wonderbench/mianguang/docs/README.md

# 方案文档

[PDF阅读版](毫米波睡眠监测与夜灯_样机设计方案.pdf) · [Word可编辑版](毫米波睡眠监测与夜灯_样机设计方案.docx)

方案书为2026-10-28的8页设计记录，包含资源比较、模块选择、电源与接口、安装、固件和验证计划。其“PCB编辑暂停、待最终导出”等历史状态已由2026-11-04的[PCB V0.2交付说明](../pcb/release_v02/README_交付与装配.md)替代；接线、跳帽与制造数据均以V0.2为准。

`archive/`保留V0.1离线复核作为问题来源记录；H-01至H-05的处理及剩余功能边界见V0.2交付说明。历史报告中的原工作区路径不作为当前文件入口。

`source/delivery_status_2026-10-28.json`保存原方案生成时的状态快照；`fonts/`包含文档字体及许可证。历史文档生成脚本在[tools/](../tools/)，输出到`docs/generated/`，不覆盖已交付PDF或Word。
