wonderbench/mianguang/research/README.md

# 参考资料与选型

- [选型证据与集成约束](source_notes.md)：C1001主选、其他雷达路线、安装和数据有效性条件。
- [资源索引](resources.json)：官方链接与用途。
- [下载校验清单](download_manifest.json)：参考资料SHA-256。
- [datasheets/](datasheets/)：厂家手册、协议、透波罩指南、C1001尺寸图与STEP/DWG。
- [vendor_library/](vendor_library/)：DFRobot官方库审阅快照及原许可证，用于协议核对。

资料快照日期为2026-10-28。当前项目连接与选料以[PCB V0.2](../pcb/README.md)为准。厂家文档及模型归原提供方，具体来源记录在上述索引。
