wonderbench/mianguang/models/mechanical/interface_evidence.md

# V0.2 PCB 与外壳接口证据

提取日期：2026-11-04。本文与同目录 `pcb_v02_reference.json` 一起用于 Blender 尺寸复核。`pcb/release_v02` 为冻结输入，未修改。数字复核不代表实物装配通过。

## 坐标与提取范围

- PCB 坐标：毫米；从元件顶面看，板框左下角 `(0,0)`，X 向右、Y 向上、Z 从顶面向元件侧。原生 EDA 数据以 mil 保存，乘 0.0254 转为 mm；旋转角沿原生 XY 平面逆时针。
- 板框 66×56 mm；厚度 1.6 mm 来自 V0.2 装配建议，Gerber 本身不规定板厚。四个非金属化孔名义 Ø2.7 mm，中心 `(5,5)`、`(61,5)`、`(5,51)`、`(61,51)`，孔距 56×46 mm。JSON 保留导出量化的小数，不将其当作加工公差。
- 全部 23 个元件位于顶面，共 63 个物理焊盘。读取独立 `.epcb` 的放置和项目 `.epro2` 内封装，使用仓库现有解析器处理删除及覆盖记录，再对照冻结 PickPlace、BOM 和针脚网络。
- `footprint_layer48_centerline_bbox_xyxy_mm` 是封装 layer 48 图形中心线外接框，不是实测器件外壳，也不是带装配公差的禁布区；`pad_bbox_xyxy_mm` 是焊盘机械参考。JSON 保存两者和并集，范围格式为 `[xmin,ymin,xmax,ymax]`。微小焊盘偏移小于 0.0002 mm，机械包络计算忽略该偏移。
- 当前 Blender 设计映射：`X=x−33`，`Z=y+56`；载板中心 `Y=12.2`，元件面 `Y=11.4`，背面 `Y=13.0`；元件向 `−Y` 生长。毫米转换为 Blender 米时再除 1000。

## XIAO：按针位配准，USB 朝向板 +Y

U1 原生放置原点为 `(33,30)`，两排针的几何中心为 `(33,29.51740096)`。左排 X=25.38000004，针 1→7 的 Y 从 37.13740096 递减至 21.89740096；右排 X=40.62000004，针 8→14 的 Y 从 21.89740096 递增至 37.13740096。行距 15.24 mm、针距 2.54 mm；承载板钻孔约 Ø1.1 mm。不能将两排针画成 19.2 mm 间距，也不能按原点直接对称放置模块。

Seeed 官方规格为 21×17.8 mm。官方 V1.3 KiCad 的板边按 D0、TX、RX、5V 针位配准后，在载板上为 X=24.110..41.890、Y=19.103401..40.058401 mm，中心 `(33,29.580901)`；该公开 CAD 的边框为 17.78×20.955 mm。USB 朝 +Y，变换到外壳后朝 +Z。[Seeed 官方说明](https://wiki.seeedstudio.com/XIAO_ESP32C3_Getting_Started/)、[官方 V1.3 PCB 文件](https://files.seeedstudio.com/wiki/XIAO_WiFi/Resources/XIAO_ESP32C3_v1.3_KiCad_260116.zip)。

冻结 EDA 封装保留的模块图形与当前官方 V1.3 板边在配针后有约 0.22 mm 的偏置差。插装孔位以冻结载板为准；壳内模型使用官方板边与额外装配余量。预留 USB 至 PCB Y≈41.7 mm 属于外壳设计余量，不能据此推定实际线缆插头的完整形状。

候选排母 C124418 / Ckmtw B-2200S07P-A120 的产品页列明 1×7、2.54 mm、塑壳绝缘高度 8.5 mm；这不是模块板底到载板顶面的完整堆高。[供应商产品规格](https://www.lcsc.com/product-detail/C124418.html)。当前模型另预留 2.5 mm 公针塑壳，暂按板底离载板 11 mm、模块 PCB 厚 1.6 mm、模块元件高 3.2 mm。公针/排母配套型号、插入止点、焊接姿态与实际 USB 外壳高度未冻结，该堆高只允许作条件空间检查。

当前 USB 服务插头预留厚度 8 mm（外壳 Y=−6.8..1.2），起点 Z=97.6 mm，轴向拔插距离 24 mm；线缆随后转弯的空间仍需按实物确认。模块自带 USB 用于固件/调试；面板电源 USB-C 小板通过 J1 供电，是另一个独立物料，不应将两者混为同一接口。

## XIAO 外置天线：真实候选尺寸与粘贴区域

XIAO ESP32C3 官方说明明确随附外置天线；目前尚未确认本项目实物的天线批次。可追溯候选为 Seeed A-01 FPC（SKU 318020748），其 2024-10-08 工程图型号 M01-0601770R0A、版本 V01：FPC 为 40.0±0.3 ×20.0±0.2 mm，馈线 80±2 mm、直径 1.13±0.1 mm，局部焊接总高不大于 1.80 mm（含离型纸）。当前官方商品页补充 FPC 基体厚 0.2 mm、IPEX1 接头。[官方工程图第 1 页](https://files.seeedstudio.com/wiki/XIAO_WiFi/antenna/FPC_Antenna_2.4GHz_2.9dbi_for_XIAO_ESP32C3/res/Datasheet_2.4GHz_FPC_Antenna_2.9dbi_for_XIAO_ESP32C3.pdf)、[官方商品页](https://www.seeedstudio.com/FPC-Antenna-A-01-for-XIAO-ESP32C3-C5-p-6439.html)。当前商品页包含双频用途，而上述工程图针对 2.4 GHz；本设计按这组有来源的外形预留空间，不据此认定随附批次或射频特性一致。

建议贴在左侧塑料内壁 YZ 平面，40 mm 长边沿 Z，20 mm 短边沿 Y。内壁 X=−47.6 mm 时，名义 FPC 基体中心为 `(−47.5,0,84)`、尺寸 `0.2×20×40` mm；包含焊点和装配余量的电子占位中心为 `(−46.6,0,84)`、尺寸 `2.0×20.6×40.8` mm。粘贴与检修区为 Y=−12..12、Z=62..106 mm，即 24×44 mm。占位最内侧 X=−45.6，距载板左边 X=−33 有 12.6 mm；此距离是几何余量，不是经厂家确认的射频净空要求。该位置避开中央雷达正前方，也将天线置于背部安装座之前。

官方 XIAO V1.3 PCB 的 ANT0（U.FL-R-SMT-1）原点配准到载板为 `(33,20.50040096)`，在本版外壳中为 X≈0、Z=76.50040096，处于 USB 的相反一端。FPC 馈线端可朝下至 Z≈64，至 ANT0 的 XZ 直线距离约 49.1 mm；80 mm 馈线可据此设计绕行路径，但折弯半径、连接头扣合高度、应力释放和检修余量仍需实物与模型验证。不得仅以端点直线距离判定线长够用。馈线不得覆盖 C1001 天线、夹在壳体接缝内，或妨碍 JP1/JP2/JP3 拔插。

JSON 的 `xiao.external_antenna` 记录官方尺寸、链接及 PDF 哈希；`enclosure_design_assumptions.wifi_antenna` 记录上述候选落位。不得将这些条件预留写成实物装配或 Wi-Fi/BLE 性能已通过。

## 接口、针序和跳帽访问

| 接口 | 原点 mm | 针 1→末针方向 | 针序 / 服务要求 |
|---|---:|---|---|
| J1 | 17,8 | +Y | 1=5V_IN，2=GND；外接面板供电小板 |
| J2 | 56,35 | +X | 1=5V_SYS，2=GND，3=RADAR_RX，4=RADAR_TX；雷达线束 |
| J3 | 56,17 | +Y | 1=5V_SYS，2=LED_LOW；限流暖白灯板 |
| J4 | 11,29 | +X | 1=BUTTON_N，2=GND；外壳按键线束 |
| J5 | 14,44 | +Y | 1=3V3，2=GND，3=I2C_SDA，4=I2C_SCL |
| JP1 | 47,8 | +Y | 1=5V_ISO，2=5V_MCU；主控电源跳帽 |
| JP2 | 48,36 | +X | 1=UART_TX_LINK，2=RADAR_RX；发送隔离跳帽 |
| JP3 | 48,41 | +X | 1=UART_RX_LINK，2=RADAR_TX；接收隔离跳帽 |

八个排针的插拔方向均应沿元件面法向（外壳 −Y），表中 X/Y 仅指板内针脚排列。塑壳大小、锁扣、极性防呆、线缆折弯半径及跳帽抓取尺寸没有被 PCB 封装锁定。模型应在可拆前盖后保留抓取路径，并避免雷达托盘或线束遮住 JP1/JP2/JP3。USB 调试前按 V0.2 装配说明：断开外部 5 V，拔下三个跳帽，再插 XIAO USB。不能仅拔 JP1 就认为 UART 已隔离。

## C1001 雷达模块的可追溯安装孔

官方图纸确认 22×22 mm、右侧两孔距 18 mm、距上下边各 2 mm；元件面视图左侧针脚自上而下为 VIN、GND、RX、TX、IO1、IO2。[DFRobot 官方页面及下载](https://wiki.dfrobot.com/sen0623)。

原厂 `JQC1001.step` 的板实体为 `#298 MANIFOLD_SOLID_BREP`：边界 X=18.559999465942..40.560001373291，Y=7.30999994278..29.309999465942，Z=−0.99144074..0 mm。将其左下角平移到 `(0,0)`，两个孔的名义中心为 `(20,2)`、`(20,20)`；对应圆柱面 #749/#815 的半径为 1.00000054 mm（名义 Ø2.0）。相对板中心即 `(9,−9)`、`(9,+9)`。孔径来自原厂 CAD，须与实际批次测量复核后再选螺钉/柱；不能把此 Ø2.0 与承载 PCB 的 Ø2.7 混用。

STEP 板厚为 0.99144074 mm，当前外壳取 1.0 mm 近似。文件含嵌套组件坐标，且 Free-Models 子装配存在变换后越出板框的几何；因此整个文件全部点的最大最小值不构成可信实物总高。当前模型雷达板中心为 `(0,−16.8,121)`，板背面 Y=−16.3，向后预留 8 mm 至 Y=−8.3；这是待到货验证的器件与线束空间，不是已测得的模组厚度。

## 当前已确认与条件检查边界

| 项目 | 状态 |
|---|---|
| 承载 PCB 板框、四孔、23 元件放置、63 焊盘、网络针序 | 冻结源文件数字证据 |
| XIAO 行距、针距、USB +Y、公开 V1.3 板边配准 | 原生封装与官方资料交叉核对 |
| C1001 22×22、18 mm 孔距、STEP Ø2.0 | 官方图纸/CAD；实物版本未核验 |
| 排母塑壳 8.5 mm | 候选供应商规格；采购配套尚未冻结 |
| 11 mm XIAO 插装高度、模块厚 1.6 mm、元件高 3.2 mm | 设计预留，需实测配套装配 |
| 雷达背面 8 mm、USB 插头 8 mm 厚×24 mm 轴向 | 设计预留，需实物确认 |
| 面板 USB-C、灯板、按键、线束、Wi-Fi 天线、螺钉 | 具体采购尺寸/固定方式未锁定 |
| 白色透波窗材料、色母和厚度 | 外观设计参数；射频效果需样件对照 |

## 全部 23 个元件放置和 layer 48 平面尺寸

以下尺寸是封装图形中心线的外接框，不是实测器件尺寸。焊盘外接框及其与图形的并集分别保存在 JSON 中。

| Ref | XY mm | CCW deg | Layer48 W x H mm | Footprint |
|---|---:|---:|---:|---|
| C1 | 31.000, 14.000 | 0 | 2.000 x 1.250 | C0805 |
| C2 | 37.000, 14.000 | 0 | 1.600 x 0.800 | C0603 |
| C3 | 17.000, 34.000 | 90 | 0.800 x 1.600 | C0603 |
| C4 | 54.000, 28.000 | 0 | 2.000 x 1.250 | C0805 |
| C5 | 54.000, 31.000 | 0 | 1.600 x 0.800 | C0603 |
| D1 | 37.000, 8.000 | 0 | 4.200 x 2.600 | SMA_L4.2-W2.6-LS5.0-RD_1 |
| D2 | 24.000, 14.000 | 90 | 1.700 x 2.800 | SOD-123FL_L2.8-W1.7-LS3.6-RD |
| F1 | 25.000, 8.000 | 0 | 3.200 x 1.600 | F1206 |
| J1 | 17.000, 8.000 | 90 | 2.540 x 5.080 | HDR-TH_2P-P2.54-V-M-1 |
| J2 | 56.000, 35.000 | 0 | 10.160 x 2.500 | HDR-TH_4P-P2.54-V-M |
| J3 | 56.000, 17.000 | 90 | 2.540 x 5.080 | HDR-TH_2P-P2.54-V-M-1 |
| J4 | 11.000, 29.000 | 0 | 5.080 x 2.540 | HDR-TH_2P-P2.54-V-M-1 |
| J5 | 14.000, 44.000 | 90 | 2.500 x 10.160 | HDR-TH_4P-P2.54-V-M |
| JP1 | 47.000, 8.000 | 90 | 2.540 x 5.080 | HDR-TH_2P-P2.54-V-M-1 |
| JP2 | 48.000, 36.000 | 0 | 5.080 x 2.540 | HDR-TH_2P-P2.54-V-M-1 |
| JP3 | 48.000, 41.000 | 0 | 5.080 x 2.540 | HDR-TH_2P-P2.54-V-M-1 |
| Q1 | 49.000, 17.000 | 0 | 1.300 x 2.900 | SOT-23-3_L2.9-W1.3-P1.90-LS2.4-BR |
| R1 | 45.000, 24.000 | 0 | 1.600 x 0.800 | R0603 |
| R2 | 49.000, 22.000 | 90 | 0.800 x 1.600 | R0603 |
| R3 | 17.000, 29.000 | 0 | 1.600 x 0.800 | R0603 |
| R4 | 49.000, 27.000 | 0 | 1.600 x 0.800 | R0603 |
| R5 | 49.000, 31.000 | 0 | 1.600 x 0.800 | R0603 |
| U1 | 33.000, 30.000 | 0 | 17.856 x 22.446 | XIAO_ESP32C3_SOCKET_2x7_P2.54 |

## 来源文件指纹

| Input | SHA-256 |
|---|---|
| `pcb/release_v02/Mianguang_V0.2.epcb` | `1cc1c4cba7115e438fbd0bac56380e4d36e0445491d1454f6da5bd68f7b3f74f` |
| `pcb/release_v02/Mianguang_V0.2.epro2` | `4eb70110e04e7c353f97750ac7644401175efcc098e2bfd465b6daf8d8106603` |
| `pcb/release_v02/PickPlace_Mianguang_V0.2.csv` | `e606ba203e43fe6af33b6836d30a4253de79c5992be454ca68045de4488c9eaf` |
| `pcb/release_v02/BOM_Mianguang_V0.2.csv` | `ec123c07fdffcc1a422fdac34d5140f67d5df404ad6c0e5fd122b268b563254a` |
| `pcb/release_v02/Gerber_Mianguang_V0.2.zip` | `663cf9db40d43defeba6dd79a99d8856211062c604a15fb8657d6bc7a798bc77` |
| `pcb/release_v02/README_交付与装配.md` | `c297ffe9cb8d8de3dd1741a3de4af1682943b6dbbc863be644320158e0cf5332` |
| `research/datasheets/C1001_step/JQC1001.step` | `8e2c76e44df98a1f32d43bad3ae7bf83f0e4d73102cc5e6e15412d7ff26e2b06` |
| `research/datasheets/C1001_dimensions.png` | `221a93c36e9908340f5e083d6ba3b4e5144f02bf990134016940414713dc0130` |
| Official XIAO V1.3 PCB ZIP | `477bc61cec652eaeefa887cb1f97abb1514e8a61ea9659240b88be7213c3b6ff` |
| ZIP member `202003511_XIAO ESP32C3_v1.3_SCH&PCB_260116/XIAO ESP32C3_v1.3.kicad_pcb` | `a761393935ff261a58fee3e3d7ecfb65152eaba8620de64ff7758fb0c043d1db` |
