wonderbench/mianguang/models/mechanical/review_v02.md

# V0.2 外壳独立复核记录

2026-11-04 对保存后重新打开的 `Mianguang_Enclosure_V0.2.blend` 完成独立几何复核：**15 项通过，0 项失败**。原始结果见 [`geometry_checks.json`](../v0.2/geometry_checks.json)，可复核脚本为 [`verify_enclosure_v02.py`](../scripts/verify_enclosure_v02.py)。检查没有保存或修改 Blender 工程。

本记录针对 PCB V0.2 与数字模型的配合。器件高度及未选定配件仍按采购包络判断；通过几何检查不代表已完成实物装配、射频或承载测试。

## 依据与复现

- PCB：冻结的 66 × 56 mm V0.2 载板，23 个器件、14 个 XIAO 对接针位，读取独立机械参考中的原生 EDA 坐标。
- 机械参考：[`pcb_v02_reference.json`](pcb_v02_reference.json)；来源文件 SHA-256 一并复核。
- 已检查模型 SHA-256：`ac4f19d308f535fb3ac228d6c6f5e865014e69b46b43829d7eb3abe2b98e2112`。
- Blender：5.2.1 LTS。

```sh
blender --background models/v0.2/Mianguang_Enclosure_V0.2.blend --python models/scripts/verify_enclosure_v02.py
```

脚本写入几何检查 JSON；不会保存或覆盖 `.blend`。后续若修改几何，应重新执行检查并核对报告中的模型指纹。

## 本次修正并复核的具体问题

| 位置 | 发现 | 最终处理 |
| --- | --- | --- |
| 主板与 XIAO | 初稿模块位置、针距与安装孔径不对应 V0.2 | 按 EDA 坐标布置全部23器件；XIAO按14针定位；主板孔改为Ø2.7 |
| 顶部按钮 | 键帽、法兰会撞桥柱 | 桥柱移至X=±17，扩大桥板；检查0～0.45 mm行程无打印件穿透 |
| 雷达与灯板托盘 | 立柱伸入托盘实体 | 柱端分别止于Y=-6与Y=-8.5承压面 |
| 灯板线槽 | 线槽切开安装孔 | 线槽移至Z=56.8，线束经过该槽 |
| C1001背面 | 元件包络侵入安装柱 | 在采购允许包络中扣出两孔周围禁布区域 |
| USB受电板 | 压条悬空，受电板后端穿壁 | 增加压脚；受电板中心Y=13.5；重新检查开孔配合 |
| 下部前盖柱 | 碰USB压条、灯托、扩散片法兰 | 两柱移至X=±42、Z=39；前盖定位唇增加Ø7.6退让，保留外面板厚度 |
| J2与JP2 | 插头预算与跳帽过近 | J2限制为最大10.4 mm宽窄体插壳，模型侧隙0.260 mm |
| 转轴 | 原立柱与下倾壳体相撞；螺母座、固定耳及摩擦垫相交 | 后置桌面立柱；阶梯固定耳R7.7/R4.5；摩擦垫外径9；增加实际止挡 |
| 单件连接 | 初轮前盖及USB压条存在断开的实体岛 | 接合处增加实体重叠后融合；最终11件均为单一连通实体 |
| 线束 | 自动切线超调，局部穿过托盘、桥板与压条 | 控制切线范围并重排四条尾段；对曲线实体包络重新检查 |

## 最终数字检查结果

| 检查 | 结果 |
| --- | --- |
| PCB板框、厚度 | 66 × 56 × 1.6 mm；厚度为本版制造建议 |
| 23个器件位置与XIAO14针 | 与独立提取的冻结坐标逐项一致，数值误差小于0.001 mm |
| 主板四孔 | Ø2.700 mm；孔中心X=±28，Z=61/107，孔距56 × 46 mm |
| 主板孔与壳内柱孔轴线 | 从实际网格孔圈拟合；同轴数值误差小于0.001 mm |
| 雷达两孔 | 模组Ø2.000 mm、托盘Ø1.700 mm，两孔距18 mm；轴线一致 |
| 11个打印零件 | 非流形边0；每件1个连通实体；体积为正 |
| 静态打印件与电子预算 | 未检测到超过数值分类阈值的采样穿透 |
| 桌面0～30° | 63个姿态检查通过；机身最低点距底座顶面最小3.971 mm |
| 壁挂0～45° | 93个姿态检查通过；机身及外接USB插头预算距墙面最小11.149 mm |
| 实际止挡 | 桌面−0.1°/30.1°、壁挂−0.1°/45.1°均检测到止挡接触 |
| 顶键 | 0、0.20、0.45 mm三个位置未与打印件相交；弹力及实际开关行程待选型确认 |
| XIAO USB插头 | 拆前盖和雷达托盘后，12 × 8 × 24 mm服务包络不与保留打印件相交 |
| 雷达面至前盖 | 模型间隙4.50 mm；没有据此推断射频性能 |
| 外部USB-C | 受电接口预算与壳开口配合通过；采购接口及真实线缆需符合预算 |

## 检查范围

碰撞检查使用保存模型的三角面、顶点及三角面中心，结合最近距离和三个方向射线判断内部点；数值分类阈值为0.05 mm。该阈值用于排除共面接触及浮点误差，不是允许制造干涉量。旋转检查采用0.5°离散步长，并加入端点和距止挡0.1°的位置；不能代替连续运动证明或实体转动测试。

XIAO插座组合高度、C1001背面8 mm预算、USB受电小板、灯板、光感头与实际线缆均需采购后量测。仍需验证打印收缩、热熔螺母试孔、紧固扭矩、底座抗倾倒、壁挂承载、按键回弹、夜灯温升和透波。以上事项保持为明确的样机验证条件。
