wonderbench/mianguang/firmware/reports/demo_summary.md

# 固件日志工程摘要

**合成模拟非实测 — 仅用于工具验证**

来源：`<project>/firmware/fixtures/demo_synthetic.jsonl`  
SHA-256：`b06ec00be3675a69ca47d01a035d6e8733191f3152256c597300977b0d793199`

非空记录 15 条，其中结构有效 sample 13 条；无效 JSON 1 条，结构不合格 0 条，非 sample 1 条。空白行 0 条。
重复相邻时间 1 次，时间下降 1 次，共 2 段。时间下降按重启或乱序边界处理，不能确证重启。

| 时间项目 | 结果 |
| --- | --- |
| 各段首末跨度之和 | 14.000 秒 |
| 可积分观察时间 | 8.000 秒（跨度的 57.1%） |
| 已知正向间隔中未计时间 | 6.000 秒 |
| 有效在床观察 | 6.000 秒 |
| 有效非在床观察 | 0.000 秒 |
| 在床状态 unknown | 2.000 秒 |

覆盖率分母为可积分观察时间。缺口和跨分段时间不补齐，也不自动算入 unknown。

| 指标 | 有效时间 / 覆盖率 | 有效去重原始读数数 | 中位数 | 范围 |
| --- | --- | --- | --- | --- |
| RR 呼吸频率 | 6.000 秒 / 75.0% | 6 | 17.0 | 14–22 |
| HR 心率 | 6.000 秒 / 75.0% | 6 | 71.0 | 68–82 |

RR/HR 单位为次/分钟。原始读数按各字段独立的 `(分段,t_ms-age_ms)` 去重；中位数不使用固件趋势中位数，日志行数不当作独立样本数。原始 available 读数范围、冲突和来源行见 JSON。

| 分段 | 来源行 | t_ms 范围 | sample 条数 |
| --- | --- | --- | --- |
| 1 | 2–11 | 1000–11000 | 9 |
| 2 | 12–15 | 500–4500 | 4 |

统计只延续至下一条有效记录，且间隔须大于 0、不超过 2 秒；末条不外推。坏行/非 sample 会阻断区间；重复时间行不贡献时长，其后区间也保守排除。

- 这是工程观察摘要，不是临床睡眠报告；在床观察时长不等于睡眠时长。
- 日志记录数不等于独立雷达读数数；RR 与 HR 分别按分段内 t_ms-age_ms 去重。
- 去重统计仅覆盖日志可见的观测时间键，不代表模组全部采样或 UART 帧总数。
- 非在床观察时长不等于真实离床时长或离床次数；unknown 不计作非在床。
- t_ms 下降仅表明重启或乱序边界，不能单凭该日志确认实际重启次数。
- 各段时长独立相加，没有绝对时间轴；乱序分段可能重叠，不能据此宣称真实整夜时长。
- 不推断模组睡眠阶段、睡眠质量、医学事件或医学报警。

JSON 附有每个计入/排除区间、原始读数来源行、异常位置与源文件哈希，可据此复核。
