wonderbench/mianguang/platform/reports/README.md

# 已执行的软件验收记录

以下报告来自真实 PostgreSQL / HTTPS 容器运行，输入全部为合成设备数据。JSON 保留当次 GitHub 合并候选提交、运行时间、请求数、环境与数据库字节数；不改写为最终主分支提交。工作流日志及 artifact 是对应执行证据。

| 历史规模 | 负载范围 | 证据 |
|---|---|---|
| 6,000 行 | 100 台同步突发；100 台每10秒上报；10个独立会话每15秒轮询；持续30.005秒 | [原始JSON](capacity-6000.json)、[工作流](https://github.com/wonderbench/mianguang/actions/runs/41850938034) |
| 6,048,000 行 | 同样的混合负载，持续30.006秒；并发查询单绑定24小时趋势与CSV | [原始JSON](capacity-6048000.json)、[工作流](https://github.com/wonderbench/mianguang/actions/runs/41851603839) |

两次运行的100次突发、300次周期上报、20次总览、2次趋势和2次CSV请求全部成功；实际行数、每台接收、latest/排序水位、调度次数及临时凭证清理检查全部通过。趋势和CSV各只有2个样本，表中P95是本次样本统计，不能外推长时间尾延迟。

| 服务端处理 P95 | 6,000 行 | 6,048,000 行 |
|---|---:|---:|
| 同步突发接入 | 31 ms | 69 ms |
| 周期接入 | 8 ms | 82 ms |
| 总览 | 43 ms | 64 ms |
| 单绑定24小时趋势 | 17 ms | 289 ms |
| 单绑定24小时CSV | 11 ms | 446 ms |

计时来自 Django `Server-Timing`，不包含反向代理排队和网络传输；客户端P95及样本数另见JSON。执行环境为2个可见CPU、8,317,034,496字节主机内存的GitHub Linux runner，Python3.12.16 / Django5.2.19 / PostgreSQL17.11；它不是设计候选的4 vCPU机构主机。

完整历史种子实际耗时431.922秒。负载后本次设备共有6,048,400条观测；全库大小10,137,294,515字节，观测表含索引10,127,826,944字节（约9.43 GiB）。这些是数据库关系大小，不包含WAL、Docker镜像、备份及未来膨胀空间。

本次只完成完整历史规模下的短时正确性和查询检查。两份报告均为 `smoke_passed`，`full_capacity_passed=false`。100台/10会话连续24小时、真实浏览器渲染、三台真机24小时、现场断电与UART/灯时序、机构异机恢复仍未执行。执行命令及完整判定见[容量验收](../docs/capacity.md)。

## 固件CI与开发产物

[固件CI记录](firmware-ci.json)来自[工作流41855225085](https://github.com/wonderbench/mianguang/actions/runs/41855225085)。6个原生C++可执行测试、实际main.cpp mock的3份JSON、15项日志测试、实际网络序列化的3份服务端契约检查、1项USB聚合流程模拟及两个板级构建全部通过；原生与网络host检查使用ASAN/UBSAN。

| 构建环境 | 静态RAM | Flash链接尺寸 | 应用分区上限 |
|---|---:|---:|---:|
| 原 `xiao_esp32c3` / V0.2.0 | 16,852 B | 289,680 B | 1,310,720 B |
| `xiao_esp32c3_platform` / 0.3.0-dev | 77,940 B | 936,796 B | 1,310,720 B |

以上是该次CI链接结果；原V0.2发布包未替换。开发版 `.bin`、分区/引导文件与ELF位于该工作流的artifact，元数据、摘要和保留期限见JSON。静态RAM不包含运行期Wi-Fi/TLS堆与任务峰值；NVS断电、网络期限、UART/按键/灯表现和三台24小时仍按[现场记录](../docs/field_trial.md)验收。
