wonderbench/mianguang/models/mechanical/mount_notes.md

# V0.2 桌面 / 壁挂支架设计记录

日期：2026-11-04。尺寸单位为 mm。此记录描述 Blender 几何与装配目标，未进行实物承载、倾覆、磨损或锁紧扭矩测试。

## 共用安装接口

- 主体中心 `(0,0,90)`，后背外表面 `Y=22`。共用 X 轴转轴中心为 `(0,34,90)`。
- 共用支架前板 44×30×4，正面 `Y=22`，两颗 M3 的中心为 `X=±16 / Z=90`。主壳内侧向后拧入 M3×10，先固定支架，再安装 PCB。
- 支架有侧向装入的 M3 六角螺母槽：对边 5.7、厚度 2.7，螺母中心 `Y=26.15`。按 M3 螺母对边5.5、厚2.4的目标包络建模，采购后须复核实际尺寸。槽前壁厚2.8；轴向螺钉清孔Ø3.4止于Y29.5。
- 主壳内承压面Y18时，M3×10的杆端到Y28；完整越过螺母后面Y27.35，且不接近转轴孔。螺钉头与 PCB 焊脚净距由主壳检查文件复核。
- 两个活动耳分别位于 `X=±18`，耳厚6，内侧面X=±15。固定中心耳总宽28，侧面X=±14；中央20宽段半径7.7，留出后板旋转间隙0.3；两端减径为半径4.5，避让螺母加强块的最小扫掠半径5。每侧放置Ø9×内Ø4.4×厚1的纤维/聚合物摩擦垫圈；其外径也必须避让上述加强块。转轴孔Ø4.4、轴目标M4×50，外侧加0.8厚垫圈与M4锁紧螺母。右侧螺母和左侧内六角头可从侧面操作。
- 轴向材料叠层为28+2×1+2×6=42；M4×50加外垫圈0.8与螺母5后，名义露牙2.2。螺纹仅作包络，未绘制牙型。

## 桌面结构

- 底座、后置立柱与顶部悬臂合为一个连通打印零件；不是未固定的相接外观块。
- 底座100×120×5，中心`(0,22,4.5)`，底面Z2，顶面Z7；四个Ø12×3粘贴硅胶脚垫落地到Z0，其中1mm嵌入凹槽。
- 后置立柱中心Y78，厚8，前缘Y74、后缘Y82。立柱与底座后沿对齐，底部有三角加强筋。顶部悬臂连接到共用转轴。
- 桌面俯角0–30°；共用支架右侧止挡舌与桌面支架的两个止挡面接触，分别限制0°与30°。模型保留准确止挡面，未对接触面增加装饰倒角。
- 对保守前下角`(Y=-23.6,Z=32)`，30°时的高度为`90+(-23.6-34)×sin30°+(32-90)×cos30°=10.9705`，相对底座顶面的净距约3.97。根模型若改变前盖厚度或主体高度，必须重算。
- 壳体后下角在45°时Y约66.53，后柱前面Y74；仅按壳体矩形包络得到7.47的横向间隔。桌面实际限位30°，更早停止。此值不代表包含所有支架止挡的完整碰撞检查。
- 5mm底板的强度、长期蠕变及整机重心尚未实测；不能把静态包络净距写成抗倾覆合格。

## 壁挂结构

- 壁挂板68×88×5，正面Y90，背面/墙面Y95；悬臂、加强筋和中心耳与板体连通。
- 壁挂俯角0–45°，两端有相同原理的机械止挡。
- 两个钥匙孔入口Ø8.5、槽宽4.5；最终承力槽中心Z70与Z126，孔距56。安装时先让螺钉头通过大孔，再向下滑入窄槽。
- 底部另有Ø4.5防抬起锁定孔，中心Z52，正面头部沉孔Ø8.5×2.2。两个上部挂点之外，必须装好第三颗锁定螺钉。
- 目标为M4盘头墙面固定件，实际螺钉头径需小于入口且大于窄槽；墙体锚栓按墙材另选。没有假定任何特定墙体的承载能力。

## 数字检查与实物待验

构建脚本仅输出部件，不导出、不覆盖其他 Blender 场景。根构建脚本负责检查连通性、闭合网格、轴孔、角度扫掠及整体装配。打印试装仍需复核螺母槽公差、轴孔实际尺寸、摩擦片压缩、最大角度、锁紧保持力、桌面抗倾覆与墙体紧固。

支架局部数字检查已在 Blender 后台实跑：三个打印部件均为单连通、0条非流形边、正体积。对共用活动支架与桌面固定支架，在0.1°、每0.5°中间步进及29.9°共61个采样点，BVH表面交叉均为0；壁挂同理至44.9°，共91个采样点均为0。越过止挡0.1°时出现交叉（下端−0.1°为8对面；上端30.1°/45.1°各6对面），证实止挡实际存在。边界接触本身不记作穿透。这是离散表面碰撞检查，不等于连续扫掠数学证明，也不覆盖完整主壳、线缆和螺钉。
