wonderbench/mianguang/THIRD_PARTY_NOTICES.md

# 第三方资料

| 内容 | 来源与随附说明 |
|---|---|
| DFRobot HumanDetection参考库 | [官方仓库](https://github.com/DFRobot/DFRobot_HumanDetection)；快照与[LICENSE](research/vendor_library/LICENSE)一并保留 |
| Noto Sans CJK SC字体 | [Noto CJK](https://github.com/notofonts/noto-cjk)；保留[OFL.txt](docs/fonts/OFL.txt) |
| 厂家手册、尺寸图、STEP/DWG | 来源见[资料索引](research/resources.json)和[选型证据](research/source_notes.md)，归各自权利人 |
| 固件与验收工具依赖 | 版本固定于`firmware/platformio.ini`、固件构建清单和`pcb/qa/requirements.txt`；依赖运行环境不随仓库复制 |

第三方文件保留各自许可证和来源，不因纳入本仓库而变更授权范围。
