wonderbench/mianguang/platform/docs/delivery.md

# 软件交付状态与剩余验收

截至2026-11-04，文档范围内的MVP软件模块已实现并逐项提交PR。平台业务代码、联网适配、配置和运行工具均在 `platform/`；原固件只增加条件编译接入与独立构建环境，V0.2发布包保留。

## 已交付与自动验证

| 项目 | 合并记录 | 已执行验证 |
|---|---|---|
| M1 数据接入 | [PR #1](https://github.com/wonderbench/mianguang/pull/1) | PostgreSQL迁移、凭证/身份、绑定、幂等与排序、并发边界及3设备合成接入 |
| M2 管理闭环 | [PR #2](https://github.com/wonderbench/mianguang/pull/2) | 两角色、Admin、总览、历史趋势、CSV权限及审计；容量工具覆盖10个独立HTTP查看会话 |
| M4 部署与恢复 | [PR #3](https://github.com/wonderbench/mianguang/pull/3) | 实际三容器HTTPS部署、人员网络边界、日清理、age加密备份及隔离空库恢复 |
| M4 容量工具 | [PR #4](https://github.com/wonderbench/mianguang/pull/4) | 100台同步突发和持续上报、10会话、604.8万行历史下的30秒混合负载；实际行数和水位一致 |
| M3 联网与现场配置 | [PR #5](https://github.com/wonderbench/mianguang/pull/5) | V0.2与0.3.0-dev实际构建、原有ASAN/UBSAN回归、真实序列化的服务端契约校验及USB配置流程模拟 |

实际数值、请求样本数、构建尺寸、原始JSON与工作流来源统一放在[软件验收记录](../reports/README.md)。容量目标、代码检查通过和真机结果各自记录；不会把短跑、HTTP会话或链接尺寸换算成24小时、浏览器渲染或运行期堆峰值。

## 执行入口

- 服务器部署、账号、网络边界、每日维护及隔离恢复：[运行与恢复](operations.md)。
- 两个固件环境的构建与受控刷写、USB配置、换绑及凭证轮换：[联网固件](../firmware/README.md)。
- 100台/10会话/6,048,000行/86,400秒的完整合成运行命令：[容量验收](capacity.md)。`--require-full` 在范围或门槛不满足时非零退出；10个真实浏览器的持续行为另行记录。
- 三台设备、无USB上报、断网/重启/换绑、资源及本地灯控对照：[现场记录与空白模板](field_trial.md)。

## 尚未完成的验收及所需条件

| 验收 | 所需真实条件 | 当前状态 |
|---|---|---|
| 100台持续24小时与真实浏览器 | 可持续运行的独立演示主机、同版PostgreSQL/HTTPS部署、10个浏览器及完整运行时间 | 已完成30秒及完整历史规模检查；24小时和真实浏览器未执行 |
| 三台真机24小时及硬件故障边界 | 三套PCB V0.2/ESP32设备、受控USB和供电、实际雷达与安装场景、现场操作记录 | 软件、工具和模板已交付；没有接入真机，不存在实测通过结论 |
| 机构实际部署及异机恢复RTO/RPO | 机构主机、域名/证书、Wi-Fi/NTP、人员网段、受控异机备份挂载与密钥保管、负责人 | 容器内合成部署和隔离恢复通过；机构环境与生产恢复指标未验收 |

上述条件没有在本轮提供。不得自动启用雷达或恢复安装/光照确认，也不能将开发固件当成无人值守恢复版本。现场补齐证据后按实际结果更新记录；仍失败或未覆盖的项目保留原状态。
