wonderbench/mianguang/pcb/qa/v03/online_dfm/PRECHECK_04_report.pdf

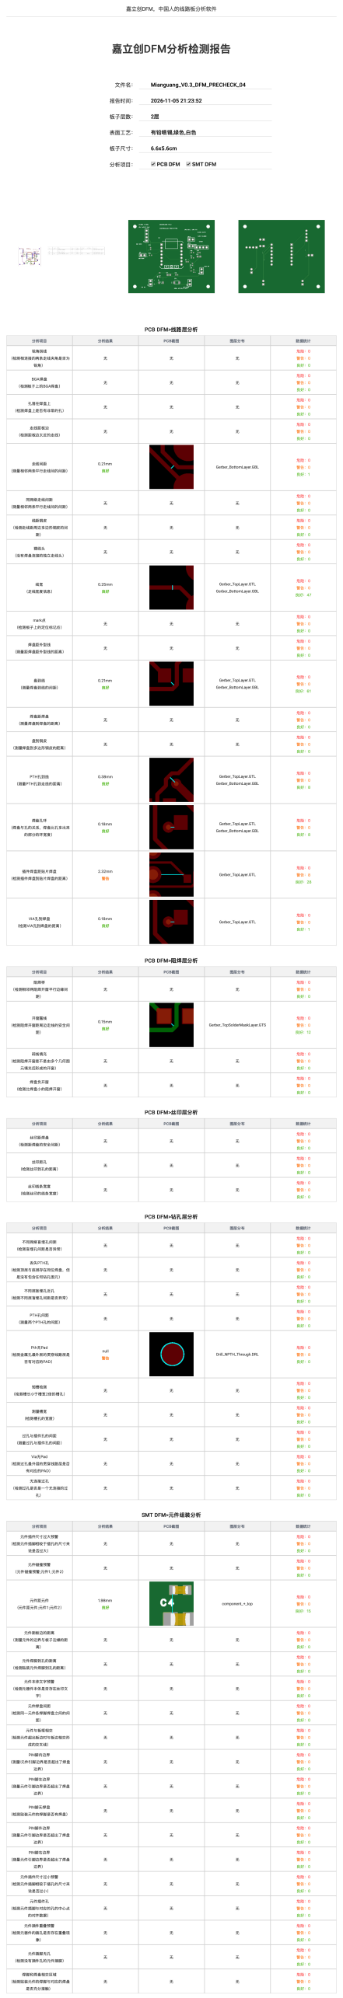
[picture p3: page 1]
