wonderbench/mianguang/pcb/qa/v03/online_dfm/PRECHECK_03_2_report.pdf

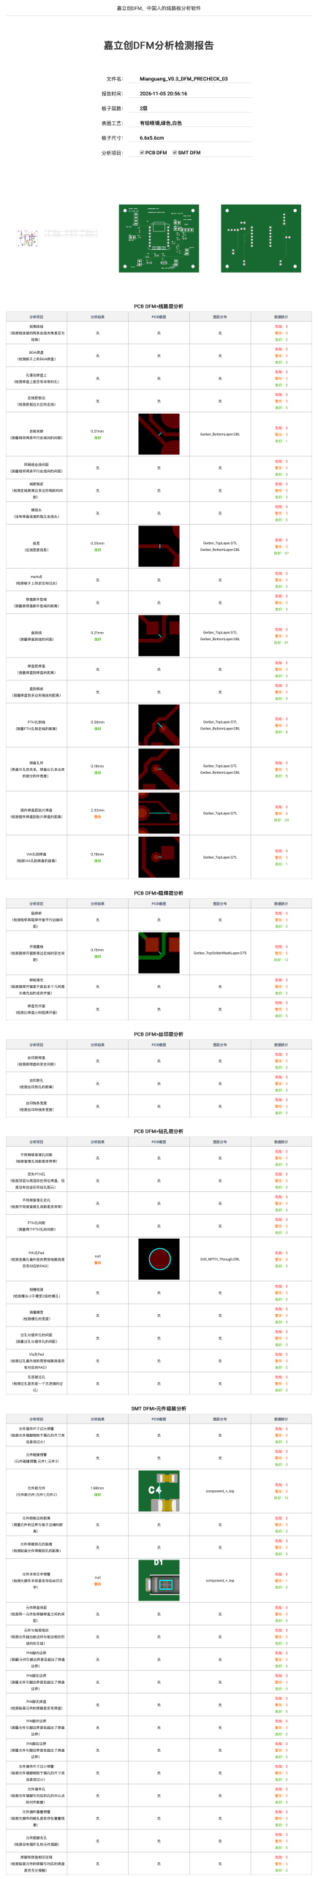
[picture p4: page 1]
