wonderbench/mianguang/pcb/qa/v03/online_dfm/PRECHECK_03_report.pdf

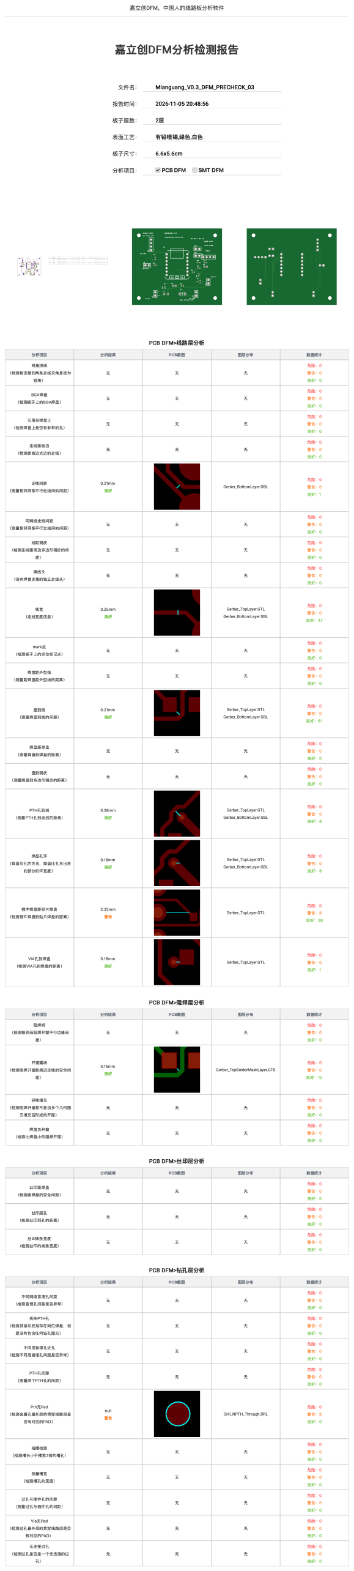
[picture p5: page 1]
