wonderbench/mianguang/pcb/qa/v03/online_dfm/PRECHECK_02_report.pdf

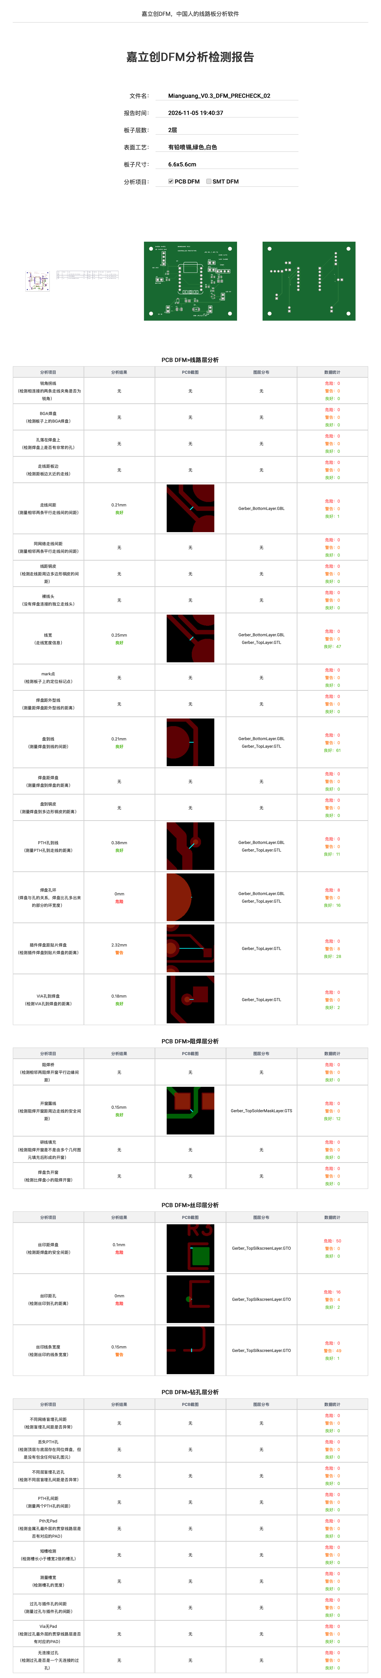
[picture p6: page 1]
