wonderbench/mianguang/docs/archive/PCB_V0.1_离线复核_2026-10-28.md

# 眠光 V0.1 离线硬件复核

复核日期：2026-10-28。范围为 C1001 + XIAO ESP32C3、66 × 56 mm 载板的原理图连接、器件记录、固件引脚与封装证据。仅读取工程文件、既有报告和厂家公开资料；未操作 EDA、Blender 或浏览器，未修改设计。本报告不是制造放行。

**结论：最新原理图的 51 个指定连接点均与 `net_assignments.json` 相符，未发现已证实的 TX/RX 对接反向、MOSFET G/S/D 接错或 SS14 极性接反。已证实的问题集中于交付版本不一致、建板脚本未跟随修改，以及若干仍依赖操作流程和外部部件的集成边界。现有资料不足以宣布最新 PCB 已与最终 F1 同步并完成制造校核。**

## 1. 本次采用的版本与证据等级

| 对象 | 本次读到的状态 | 可据此下的结论 |
|---|---|---|
| `hardware/native/sleep_radar.esch` | 与 `reports/schematic_reflow_final.json` 的 `result.source` 逐字相同；源头更新时间为 2026-10-28 11:39:20 左右 | 本次最新可读原理图；F1 已为 Littelfuse 1206L110/16WR、C3761685 |
| `hardware/reports/reflow_pins.json` | 19 个器件、最终重排后的引脚坐标 | 将每个指定引脚坐标匹配到最新原理图 LINE 端点及 NET 属性，共核对 51 点，0 处不一致 |
| `hardware/native/sleep_radar.epcb` | DOCHEAD 更新时间 11:36:28 左右；F1 仍引用旧 Device `27cd969df57915f3` | 是最终 F1 修改之前的 PCB 快照，不能当作当前 EDA 内存/已保存工程的完整证明 |
| `hardware/native/schematic_netlist.json`、`BOM_V01.csv`、`BOM_V01.tsv` | F1 为 KUU K1206L050YR、C2892420、0.5 A | 已确认过期；D1、Q1 的后期替换已进入这些文件 |
| `hardware/native/mianguang_sleep_radar_v01.epro2` 及 `unpacked_epro2/*.epru` | 打包时间在 F1 最终修改之前；内含 U1 等真实封装图元 | 可核对该快照封装，不能证明包含最终 F1 |
| `reports/reimport_fuse.json` | 返回 `true` | 有“执行过导入”记录，但没有导入后 PCB 源、BOM、网表、DRC 或连接核对快照 |
| `reports/eda_release_save.json`、`handoff_save_only.json` | 保存成功 | 只证明保存动作成功；不是新一轮设计或制造校核结果 |

便于后续识别的本次文件 SHA-256：

- 原理图：`f08d592f12919b7ad14e96aa431896464a231b6f72f49cc15f0fb8365b5d67d3`。
- PCB：`0b3f4b1c2fcabfc2d8d93410d4ed8d0b3d8abbf7a62a2eb7283a094f0ef4a5cb`。

以上哈希用于标识复核输入；后续改动后的文件应重新取证。

## 2. 已证实的问题

### H-01：最终 F1 与现有交付导出不一致——需在采购或制造前处理

最新原理图器件 `0160557e621b6da5` 的 Manufacturer 为 Littelfuse，Manufacturer Part 为 `1206L110/16WR`，Supplier Part 为 `C3761685`。`fuse_details.json` 对应 16 V、保持电流 1.1 A、跳闸电流 2.2 A、F1206。

但 `BOM_V01.csv` 第 7 行、同名 TSV、`schematic_netlist.json` 的 F1 和既有工程压缩包仍是 `K1206L050YR / C2892420 / 0.5 A`。因此，按目前文件直接下单会采购旧料，按照导出包复现也会回到旧版本。应从同一已保存工程重新导出 PCB、原理图、BOM、网表和项目包，再对 F1 的器件号、封装、引脚网络与版本进行一次交叉核对。

这不是“最新原理图仍选错保险丝”；最新原理图已正确记录此次替换。没有导入后完整源文件时，也不能反过来认定实时 EDA 内的 PCB 未更新。

### H-02：生成脚本不能完整复现当前设计

`hardware/scripts/create_schematic.py` 和 `01_create_components.js` 仍使用旧 F1 器件 UUID、名称 `PTC 0.5A HOLD`，也保留初始 D1/Q1 UUID。其器件列表未创建 JP1；JP1 是通过独立操作增加，后续连接脚本却依赖其存在。最终 F1 替换操作仅见报告，未纳入可复现的建板过程。

这些脚本目前只能作为过程记录。若继续提供“从脚本重新生成当前版本”的入口，应先让器件清单、JP1 创建、最终 F1/D1/Q1 替换、导出顺序同步，并在脚本或说明中明确初建与更新的适用状态。

### H-03：JP1 只隔离电源，不能满足全部断电 UART 隔离条件

已确认的拓扑是 `5V_IN → F1 → 5V_SYS → D1(A→K) → 5V_ISO → JP1 → 5V_MCU`；雷达 J2 与夜灯 J3 接在 `5V_SYS`。JP1 打开时只断开 MCU 的外部 5 V 支路，R4/R5 两条 UART 仍连接 MCU 与雷达，每路只有 100 Ω 串联电阻。

`firmware/src/main.cpp` 的 `setRadarEnabled(false)` 会结束 UART 并将 RX/TX 设为 INPUT；`setup()` 默认禁用 UART。这与原理图的操作说明一致。但硬件没有雷达电源检测、信号隔离或断电容忍缓冲器。执行 `radar on` 后，突然撤掉雷达电源无法由当前硬件自动阻止信号引脚注入；同样，应用代码高阻设置不证明上电、复位、下载器或 ROM 阶段始终高阻。100 Ω 不是电平转换器，也不构成断电隔离。

这是已确认的集成限制，而不是本次证明“已经发生损坏”。V0.1 可保留明确的受控调试流程；若要成为无人值守成品，应设计可验证的电源状态检测/通信禁能与上电时序，或使用具有相应断电保护能力的接口方案，再实测两侧独立掉电状态。

### H-04：无人值守启动行为尚不等于成品自动运行

固件上电始终调用 `setRadarEnabled(false)`，只有控制台 `radar on` 命令启用通信。它不会因为 JP1 闭合且外部 5 V 已存在而自行启用雷达。这是合理的工程调试防护，且 README 已明确说明；但若交付目标包括断电恢复后自动监测，该功能目前未完成。不能把引脚映射一致等同于完整的独立运行闭环。

### H-05：U1 采购元数据存在明确错误

U1 的 `Manufacturer Part` 为 XIAO ESP32C3，实际关联封装为 `CONN-SMD_XIAO_ESP32C3`，但导出网表的 `Supplier Footprint` 填写了 `QFN-32_5X5_EP3.7`。后者是芯片级封装名称，不是整块 XIAO 模块的外形。此属性不会自动证明 PCB 焊盘错误，但会误导采购和装配识别；应清理该元数据并锁定所购 XIAO 模块的硬件版本及是否预焊排针。

## 3. 已核对通过的连接和器件记录

### 3.1 固件接口

| 功能 | 原理图/网络 | 固件 | 结论 |
|---|---|---|---|
| 雷达发送 | U1.7 = D6 → MCU_TX → R4 100 Ω → RADAR_RX → J2.3 | GPIO21，`kRadarTx` | 相符；连接雷达 RX |
| 雷达接收 | J2.4 = RADAR_TX → R5 100 Ω → MCU_RX → U1.8 = D7 | GPIO20，`kRadarRx` | 相符；接收雷达 TX |
| 夜灯 | U1.3 = D2 → LED_PWM → R1 100 Ω → Q1.G | GPIO4，20 kHz PWM | 相符；高占空比对应低侧 MOSFET 导通 |
| 按键 | U1.2 = D1 / BUTTON_N；R3 10 kΩ 上拉至 3V3；C3 100 nF 对地；J4 按下接地 | GPIO3，INPUT_PULLUP，低有效 | 相符；外部 RC 约 1 ms，固件仍须做逻辑消抖 |
| 环境光 | U1.5 = D4 / SDA；U1.6 = D5 / SCL；J5.1 = 3V3 | GPIO6 / GPIO7，BH1750 地址 0x23 | 相符；子板须将 ADDR 置低，并提供接到 3.3 V 的上拉 |

XIAO 官方当前引脚表确认上述 D1/D2/D4/D5/D6/D7 与 GPIO 的映射。资料来源：[Seeed XIAO ESP32C3 官方入门页](https://wiki.seeedstudio.com/XIAO_ESP32C3_Getting_Started/)。

### 3.2 电源、二极管与夜灯

- **D1：** 最新原理图和现有 PCB 导出均为 MDD SS14、C2480、SMA/DO-214AC。符号定义 1=K、2=A，网络为 2=5V_SYS、1=5V_ISO；方向正确。现有包内 SMA 焊盘中心距约 3.930 mm，单焊盘约 1.520 × 1.680 mm，确有 SMA 封装图元，不是仅将旧封装改了名称。精确焊盘推荐尺寸仍应以锁定批次的制造商图为准。
- **JP1：** 1=5V_ISO、2=5V_MCU，确实串在 MCU 外供电支路。Seeed 官方说明 5V 引脚关联 USB VBUS，并要求外部供电向该引脚串二极管，方向与当前 D1 一致。D1 阻止 USB 向 5V_SYS 回供，但不能单独证明所有同时接电脑 USB 与外部电源的情况均安全；原理图“编程前取下 JP1 并断开外部 5 V”的流程仍有意义。[官方电源引脚说明](https://wiki.seeedstudio.com/XIAO_ESP32C3_Getting_Started/)
- **Q1：** 最新原理图及导出均为 AOS AO3400A、C20917、SOT-23。1=G 接 LED_GATE、2=S 接 GND、3=D 接 LED_LOW；与低侧 NMOS 拓扑相符。R1=100 Ω，R2=100 kΩ 下拉；启动先输出 LOW 再连接 PWM 的固件顺序相符。库记录导通电阻上限 48 mΩ @ VGS=2.5 V，支持 3.3 V 驱动的器件选择方向，但本次未完成制造商原始 PDF 参数表的独立复核。
- **夜灯接口：** J3.1=5V_SYS、J3.2=LED_LOW。板上没有 LED 限流电阻或恒流驱动；原理图已明确要求外部 **5 V、自带限流、≤0.5 W** 暖白灯板。按该边界灯电流最多约 100 mA。不能把 J3 接口解释为可直接接裸 LED。
- **F1：** 最新原理图的选料记录是 1.1 A 保持、2.2 A 跳闸，不能继续写成 0.5 A。保持/跳闸值来自本地器件详情记录，本次未获得对应 Littelfuse 原始曲线进行温度降额与时间曲线复核；它也不是精密的 1.1 A 限流器。
- **D2：** SMF5.0A、C2980403、SOD-123FL，符号图形阴极侧对应 pin 1，接 5V_SYS；pin 2 接 GND，未发现反接。库记录 VRWM=5 V、钳位电压 9.2 V；由此不能声称它把所有浪涌限制在“安全 5 V”，也不能代替输入过压切断或稳压。
- **去耦及按键值：** C1 标注 10 µF/25 V/X5R，料号 CL21A106KAYNNNE，0805；C2/C3 为 CC0603KRX7R9BB104、100 nF/50 V/X7R、0603；R1/R4/R5 为 100 Ω、R2=100 kΩ、R3=10 kΩ。原理图标注、网表和器件记录未发现相互冲突。C1 的耐压/介质及有效容值仍应补制造商资料及直流偏压条件证据。

## 4. XIAO 封装与机械真实性

本次实际解析了工程压缩包中 UUID `d1533a679cd0c852` 的 FOOTPRINT 文档，未用模块名称或 3D 外观代替焊盘校核。

| 项目 | 本地封装测得值 | 外部对照/判断 |
|---|---|---|
| 双排通孔 | 14 孔，排间距 600 mil=15.24 mm，同排针距 100 mil=2.54 mm | 与 Seeed 官方 DIP / DIP-SMD 封装孔心排列相符，旋转和平移后针序亦相符 |
| 通孔孔径/焊盘 | 孔径 43.308 mil≈1.100 mm，焊盘 62.992 mil≈1.600 mm | 官方混合封装为 0.889 mm 孔、1.524 mm 焊盘；本地是修改尺寸，需按实际排针/插座与制造能力确认，不能称为官方原样封装 |
| 两侧 SMD 焊盘 | 中心排间距约 17.000 mm，焊盘约 3.000 × 2.000 mm | 官方 DIP-SMD 示例为中心排间距 16.910 mm、焊盘 2.432 × 1.524 mm；尺寸不同不直接等于不可焊，但应选定贴焊或插座方案后按同一种装配方式复核 |
| 底部焊盘 | 另有 15–23，共 9 个底部焊盘，含一个 2.8 × 2.8 mm、编号 17 的 `PAD` | 官方本次下载的 DIP-SMD 包含 8 个底部焊盘；本地附加大焊盘没有在该官方库中找到直接对应。当前原理图 pin 17 NC；NC 不代表物理焊盘及锡膏不存在，直接贴焊前须核实模块底面禁布和焊接间隙 |
| 模块板体 | 主体丝印边界约 17.78 × 21.00 mm，USB 轮廓向板体外伸出 | 与官方规格 21 × 17.8 mm 的量级一致；不应将 USB 突出部分错误计入 PCB 板体后宣称板体尺寸错误 |
| 采购属性 | `Supplier Footprint=QFN-32_5X5_EP3.7` | 已确认错误，见 H-05 |

官方对照来源：[XIAO 系列 KiCad 封装包](https://files.seeedstudio.com/wiki/XIAO-KiCad-Library/New_XIAO_Series_Footprints.zip)，本次读取 `XIAO-ESP32-C3-DIP.kicad_mod`、`XIAO-ESP32-C3-DIP-SMD.kicad_mod`、`XIAO-ESP32-C3-SMD.kicad_mod`。这些官方文件本身也有不同装配形式和底部编号约定；不能只按 15–23 的编号差异判定本地信号映射错误。

`reports/pcb_imported_components.json` 中 U1 通孔曾显示 `hole=4.3308`，与包内同一封装的 `hole.width=43.308` 相差 10 倍。真实包内几何对应约 1.1 mm，故本次**不采纳“U1 孔径只有 0.11 mm”这一结论**。该矛盾说明单独使用早期 API 返回的几何值有风险；最终应以重新导出的封装/PCB 和钻孔文件联合核查。

尚未确定的装配事项：使用排针插座还是模块直接贴焊、实际模块硬件修订、插座高度、USB 插头拔插空间、天线馈线与外置天线位置、底部焊盘和载板走线之间的间隙。当前 3D 模型和库名不足以关闭这些项目。

## 5. 载板与 C1001 模块的孔位

- 现有 PCB 源的板框为闭合 66 × 56 mm 矩形，单位换算与 `placement_mm.json` 相符。
- 4 个载板安装孔均为不镀铜孔，孔径约 2.7 mm；中心为 (5,5)、(61,5)、(5,51)、(61,51) mm。它们是载板安装孔，不是 C1001 的固定孔，也不是 XIAO 模块孔。
- 已直接查看 `research/datasheets/C1001_dimensions.png`：C1001 板为 22 × 22 mm，右侧两孔纵向中心距 18 mm，孔中心距上下板边各 2 mm；左排接口针序从上到下 VIN、GND、RX、TX、IO1、IO2，针距 2.54 mm。
- 最新载板只提供四针 J2 线束接口，没有 C1001 的独立安装封装和固定孔。因此不能声称 C1001 可直接落入载板四个安装孔；它的支架、孔径、Z 高度与壳体装配是独立问题。
- `research/source_notes.md` 将孔径、器件总高、连接器方向列为实物待复核，这一保留正确。尺寸图未标注孔径；本次没有根据图片比例臆定孔径。

## 6. 仍需验证的电气/制造边界

1. **输入组件未定型。** J1 实际器件是 2.54 mm 两针排针，不是 USB-C 插座。USB-C 面板输入组件须在外部完成正确的 CC 下拉/受电配置、极性与线材规格；载板中没有这部分电路。应补外部面板组件、LED 限流组件、线束、J5 光感子板和 JP1 跳线帽的确切装配物料，不能只交付板上 BOM。
2. **新 F1 的保护配合尚未计算。** 需要在最差环境温度、最大 Wi-Fi 峰值、电源能力和灯板最大负载下核对保持/误动作，并检查线束、连接器、铜箔与故障电流及清除时间匹配。仅从 0.5 A 改成 1.1 A 不能证明保护性能更好或电压跌落已经解决。
3. **压降余量与供电瞬态。** 5V_MCU 承受 F1、D1、线缆及接触压降；C1001 直接在 5V_SYS。应测量低输入电压、夜灯 PWM、Wi-Fi 发送时 MCU 和雷达端实际电压、复位行为与通信质量。尚无实测数据证明供电预算成立。
4. **雷达支路去耦与回流。** 目前只有接在共享 5V_SYS 的 C1/C2；未见独立雷达电源滤波、专用电源测试点，J2 与 J3 共用该电源网。`source_notes.md` 所述“独立去耦与电源测试点、夜灯回流不穿过雷达支路”不能仅由此原理图宣称完成，应结合最终布线和雷达端去耦位置核验。
5. **UART 电气额定值。** 官方 ESP32 直连示例支持当前 3.3 V 逻辑的集成方向，但本地资料仍没有 C1001 UART 的绝对最大值、VIH/VIL 和断电注入规定。本次不将这些参数猜为已知。
6. **I²C 子板。** 载板不装 SDA/SCL 上拉，原理图明确依赖子板；这是条件式设计，不是遗漏已证明的错误。仍需确认子板上拉只接 3.3 V、ADDR=0，以及线缆长度/上拉值适配 100 kHz 通信。
7. **布线完成性证据不完整。** `pcb_final_verification.json` 曾给出 DRC 空列表，但较早 `autoroute_final.json` 同时记载 16 网中仅 2 网成功、14 网失败。后者可能涉及已有布线的重试，不能直接据此认定 14 网断路；空 DRC 同样不能解释该差异。本次不做完整铜几何连通性判定。尤其 F1 最后一次再导入后，缺少新一轮源文件、网络连通性与制造检查报告。

## 7. 建议关闭顺序

先从最终已保存工程重新导出完整同版文件并确认 F1；再确定 XIAO 装配形式和外部组件 BOM，核实底部附加焊盘；随后核对最终 PCB 连通性、钻孔、焊盘和电源回流。上板阶段优先验证 JP1/USB 操作状态、两侧独立掉电与复位阶段 UART、电源压降和灯板限流。只有这些条件关闭后，才能将当前工程样机描述升级为可独立运行、可生产的设计。
