wonderbench/mianguang/models/v0.2/renders/02_rear.png

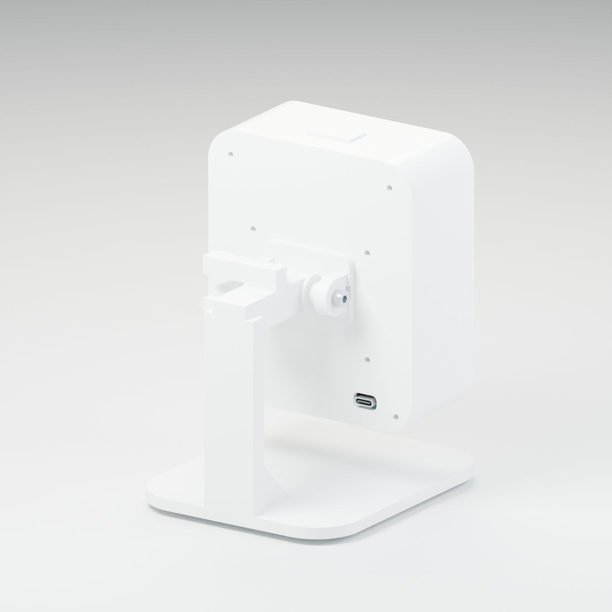
models/v0.2/renders/02_rear.png
