wonderbench/mianguang/models/v0.2/renders/03_wall_45deg.png

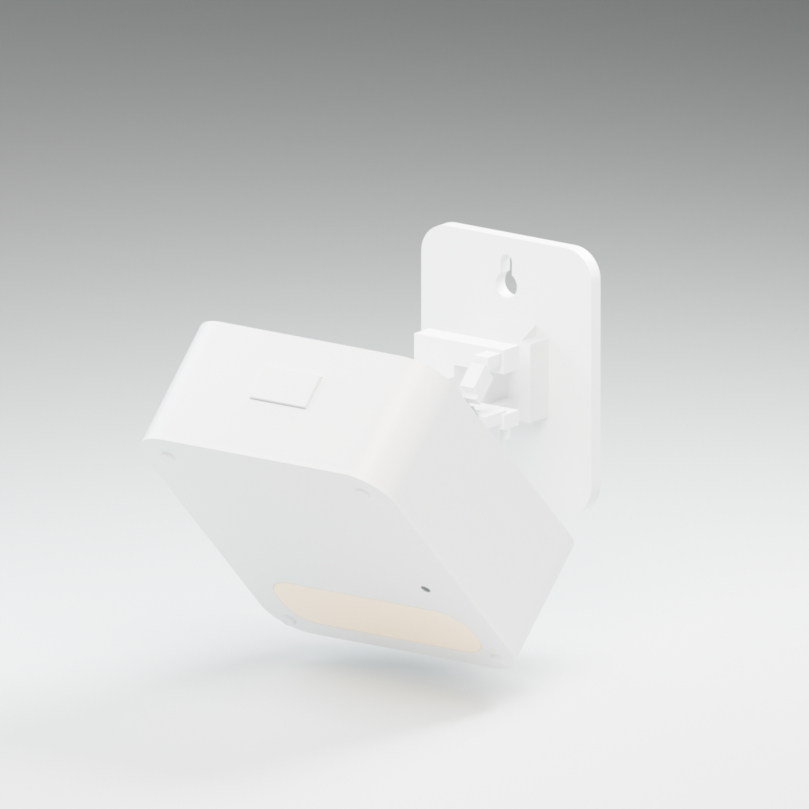
models/v0.2/renders/03_wall_45deg.png
