wonderbench/mianguang/models/v0.2/renders/04_exploded.png

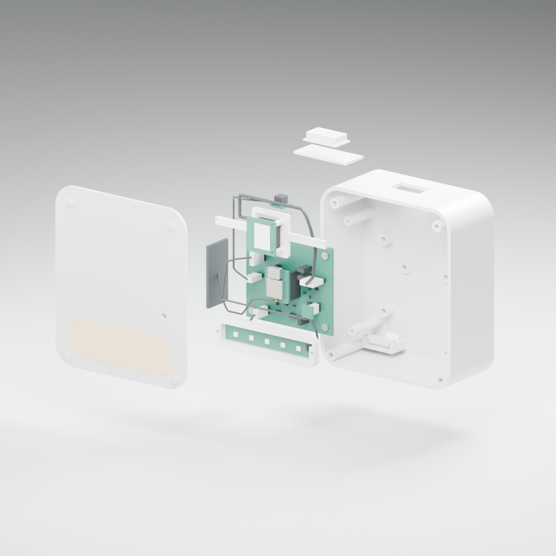
models/v0.2/renders/04_exploded.png
