wonderbench/mianguang/pcb/release_v03_precheck04/Schematic_V0.3.png

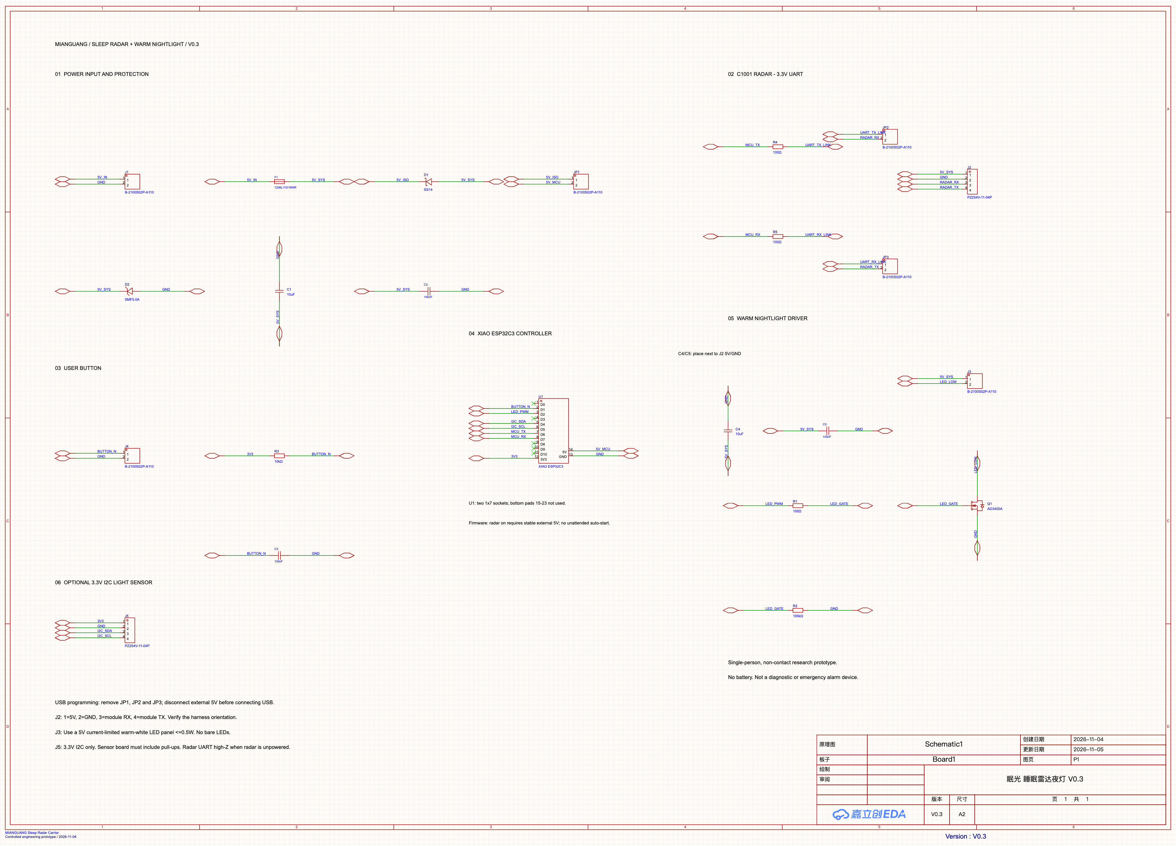
pcb/release_v03_precheck04/Schematic_V0.3.png
