wonderbench/mianguang/research/datasheets/C1001_dimensions.png

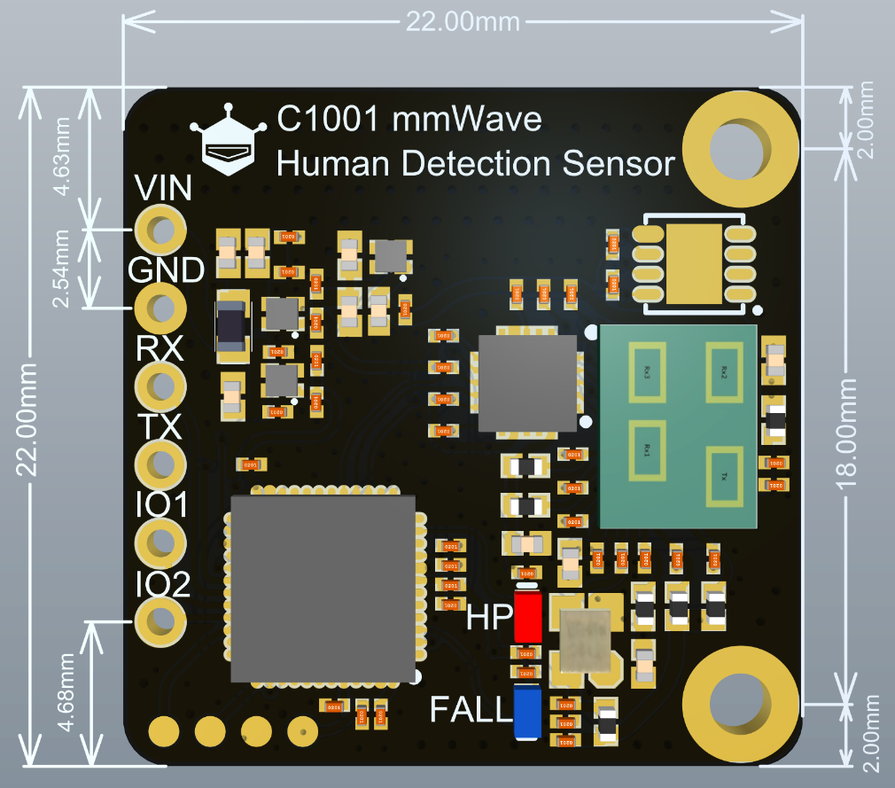
research/datasheets/C1001_dimensions.png
