wonderbench/mianguang/pcb/release_v03_precheck04/外接件与装配BOM.csv

物料编号 | 类别 | 名称 | 每套数量 | 单位 | 必须满足的规格 | 采购候选或来源 | 是否包含在工程BOM | 装配位置或连接 | 采购与验证状态
EXT-01 | 外接电子件 | DFRobot C1001 毫米波雷达模组 | 1 | 块 | SEN0623；5 V 供电；UART；单独固定 | DFRobot C1001 SEN0623；https://wiki.dfrobot.com/sen0623 | 否 | J2：5V_SYS/GND/模块RX/模块TX | 型号已选；到货硬件/固件版本、孔径、UART额定值待核
EXT-02 | 采购合并项 | Seeed XIAO ESP32C3 模块 | 1 | 块 | 必须是 XIAO ESP32C3；双排1×7公针插装；不按QFN芯片采购 | Seeed XIAO ESP32C3；https://wiki.seeedstudio.com/XIAO_ESP32C3_Getting_Started/ | U1已列时仅采购一次 | U1；USB-C方向按最终装配图 | U1已清除未核实的C19189385；确认Seeed模块修订、是否预焊排针及随附天线；不与工程BOM重复计数
EXT-03 | 插装附件 | 1×7 直插排母 | 2 | 条 | 2.54 mm针距；两排中心距15.24 mm；配合载板1.1 mm孔与1.8 mm焊盘及模块公针 | 既有库候选 C124418；220S-1*7P H=8.5MM Ytype Gold-plated | 否 | U1的14个通孔；一侧一条 | 候选未冻结；核对制造商引脚截面、孔径适配、插合深度和壳内高度
EXT-04 | 插装附件 | 1×7 直公针 | 2 | 条 | 2.54 mm针距；与选定排母配合；可用同规格长排针分切 | 既有库候选 C492406；PZ254V-11-07P | 否 | 焊于XIAO两侧；预焊版模块则不另购 | 核对公针长度及插合；预焊版需从采购量中扣除
EXT-05 | 插装附件 | 2.54 mm 两针跳线帽 | 3 | 个 | 单个帽只短接同一跳线的两针；绝缘外壳，便于拔取 | 通用2.54 mm短路帽；供应商待定 | 否；JP1/JP2/JP3排针已在工程BOM中，帽另购 | JP1电源、JP2雷达RX、JP3雷达TX | 必须核对针距；只在全部断电时切换
EXT-06 | 外接电子件 | 5 V 自带限流暖白灯板 | 1 | 块 | 额定5 V；总功率≤0.5 W；带电阻限流或恒流；可由低侧PWM调光 | 供应商待定；既有结构仅为65×9 mm占位 | 否 | J3.1=5V_SYS；J3.2=LED_LOW | 不得用裸LED；冻结外形、限流方式、PWM兼容性、色温和温升
EXT-07 | 外接电子件 | USB-C 固定5 V受电面板小板 | 1 | 块 | CC1、CC2分别具有5.1 kΩ下拉；输出固定5 V与GND；不请求9/12/20 V | 供应商待定；需原理图或导通检查 | 否 | 小板5V/GND到J1.1/J1.2 | 载板不含USB-C/CC电路；确认极性、板体、线缆应力释放和面板固定
EXT-08 | 电源附件 | USB 5 V电源适配器 | 1 | 个 | 稳压5 V；首轮选≥1 A供电能力；结合实测峰值和压降确认 | 合规成品固定5 V电源；型号待定 | 否 | 外部USB-C受电小板 | ≥1 A为样机选型目标；不代替输入保护、峰值和故障配合测试
EXT-09 | 线束 | 雷达四芯线束 | 1 | 套 | 载板侧2.54 mm四针母端；雷达侧按到货接口配接；逐线校验 | 供应商待定；按实物定长 | 否 | J2→C1001 VIN/GND/RX/TX | 不可默认商用线序；确认1号脚和线长；避开雷达天线正面
EXT-10 | 线束 | 供电两芯线束 | 1 | 套 | 2.54 mm两针母端；额定电流与F1/故障保护配合；极性标记 | 供应商待定；按实物定长 | 否 | USB-C受电小板→J1 | 核对接触件、导线截面、绝缘和防拉脱
EXT-11 | 线束 | 灯板两芯线束 | 1 | 套 | 2.54 mm两针母端；支持灯板最大电流；正负/开关回路标记 | 供应商待定；按实物定长 | 否 | J3→灯板 | 灯板负端接LED_LOW，不额外短接GND绕过Q1
EXT-12 | 外接电子件 | 常开瞬时按键及两芯线 | 1 | 套 | 无源常开；按下短接BUTTON_N与GND；与顶部键帽结构配合 | 型号待定；按键帽及固定结构选型 | 否 | J4 | 确认行程、力度、回弹和结构传动；不外加电源
EXT-13 | 选装电子件 | BH1750 环境光模块 | 1 | 块 | 3.3 V供电/逻辑；ADDR接低，地址0x23；自带SDA/SCL至3.3 V上拉 | BH1750子板；准确型号待定 | 否 | J5；位于独立光感窗 | 未装时自动夜灯不会得到已确认黑暗条件；需整机标定及防自身夜灯串光
EXT-14 | 选装线束 | 光感四芯线束 | 1 | 套 | 载板侧2.54 mm四针母端；3V3/GND/SDA/SCL | 供应商待定；按实物定长 | 否 | J5→BH1750 | 随EXT-13选装；上拉只接3.3 V；长度/上拉适配100 kHz
EXT-15 | 调试附件 | USB数据线 | 1 | 条 | 与XIAO USB-C匹配；具备数据功能 | 通用合规USB数据线 | 否 | 电脑→XIAO USB-C | 调试工具可多台共用；区别于仅充电线
EXT-16 | 模块随附件 | XIAO配套天线及馈线 | 1 | 套 | 与模块射频连接器匹配；优先使用厂家随附件 | Seeed模块随附；缺失时按厂家配套件补齐 | 否；通常随U1提供 | XIAO天线座；天线远离C1001正前方 | 确认供货内容；随模块提供时不重复采购
MECH-01 | 结构件 | 白色机壳、雷达窗和扩散片 | 1 | 套 | 外观参照industrial目录；雷达窗无金属填料/镀层；厚度和间距实测 | 现有Blender概念模型/打印样件；非冻结生产图 | 否 | 前后壳、上部雷达区、下部夜灯区 | 材料透波、装配公差、温升、卡扣与紧固均待实物验证
MECH-02 | 结构件 | 桌面支座与壁挂组件 | 1 | 套 | 兼容两种安装；角度可固定；按实际墙体/桌面选择固定方式 | 现有Blender桌面/壁挂概念件 | 否 | 机壳后部共用安装位置 | 转轴锁紧、限位、抗倾倒、墙体紧固承载尚待细化
MECH-03 | 结构件 | 载板与雷达固定件 | 1 | 套 | 载板四个2.7 mm不镀铜孔；绝缘间隔柱/螺钉长度按装配确定；雷达独立支架 | 型号和数量细分待机械装配冻结 | 否 | 载板孔距56×46 mm；C1001独立固定 | 不得用载板四孔代替雷达模块固定孔；避免螺钉/导线遮挡天线
