wonderbench/mianguang/pcb/release_v03_precheck04/BOM_Mianguang_V0.3.xlsx

No. | Quantity | Comment | Designator | Footprint | Value | Manufacturer Part | Manufacturer | Supplier Part | Supplier
1 | 2 | 10uF | C1,C4 | C0805 | 10uF | CL21A106KAYNNNE | SAMSUNG(三星) | C15850 | LCSC
2 | 3 | 100nF | C2,C3,C5 | C0603 | 100nF | CC0603KRX7R9BB104 | YAGEO(国巨) | C14663 | LCSC
3 | 1 | SS14 | D1 | SMA_L4.2-W2.6-LS5.0-RD_1 |  | SS14 | MDD(辰达半导体) | C2480 | LCSC
4 | 1 | SMF5.0A | D2 | SOD-123FL_L2.8-W1.7-LS3.6-RD |  | SMF5.0A | GOODWORK(固得沃克) | C2980403 | LCSC
5 | 1 | 1206L110/16WR | F1 | F1206 |  | 1206L110/16WR | Littelfuse(美国力特) | C3761685 | LCSC
6 | 6 | B-2100S02P-A110 | J1,J3,J4,JP1,JP2,JP3 | HDR-TH_2P-P2.54-V-M-1 |  | B-2100S02P-A110 | Ckmtw(灿科盟) | C124375 | LCSC
7 | 2 | PZ254V-11-04P | J2,J5 | HDR-TH_4P-P2.54-V-M |  | PZ254V-11-04P | XFCN(兴飞) | C492403 | LCSC
8 | 1 | AO3400A | Q1 | SOT-23-3_L2.9-W1.3-P1.90-LS2.4-BR |  | AO3400A | AOS | C20917 | LCSC
9 | 3 | 100Ω | R1,R4,R5 | R0603 | 100Ω | 0603WAF1000T5E | UNI-ROYAL(厚声) | C22775 | LCSC
10 | 1 | 100kΩ | R2 | R0603 | 100kΩ | 0603WAF1003T5E | UNI-ROYAL(厚声) | C25803 | LCSC
11 | 1 | 10kΩ | R3 | R0603 | 10kΩ | 0603WAF1002T5E | UNI-ROYAL(厚声) | C25804 | LCSC
12 | 1 | XIAO ESP32C3 | U1 | XIAO_ESP32C3_SOCKET_2x7_P2.54 |  | XIAO ESP32C3 | Seeed Studio |  | Seeed Studio / authorized reseller
