wonderbench/mianguang/models/stl/SR01_04_Top_Key_22x12.stl

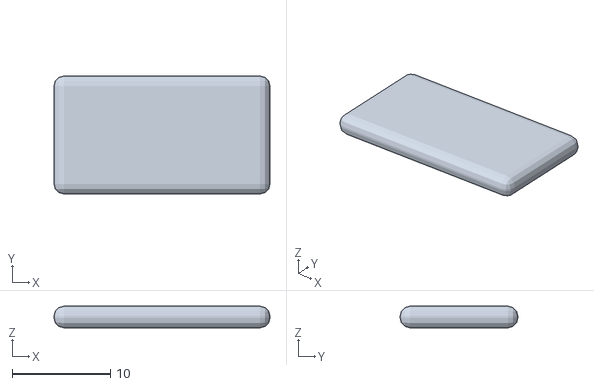
[picture p12: CAD file, 2026-11-04]
models/stl/SR01_04_Top_Key_22x12.stl
22.0 x 12.0 x 2.20
