wonderbench/mianguang/models/v0.2/stl/SR02_02_Front_Radome.stl

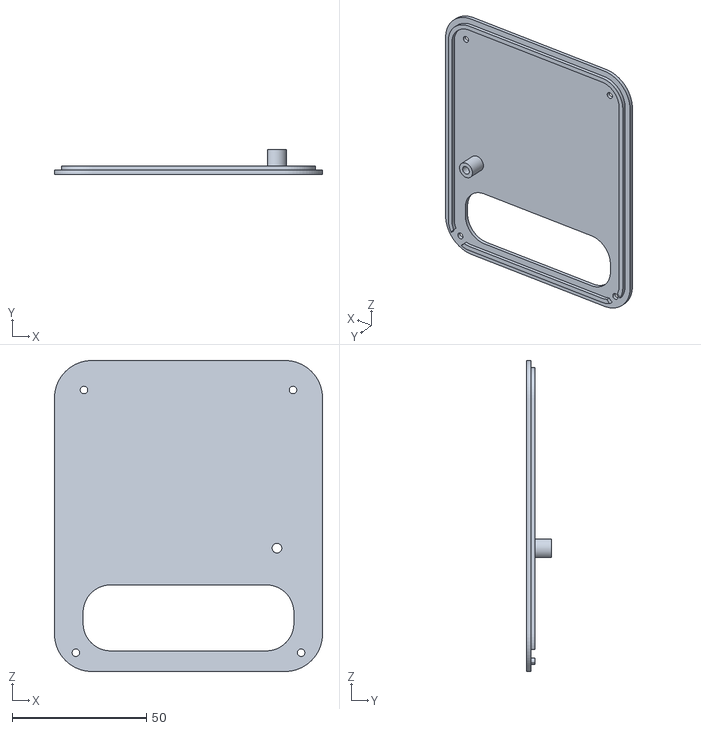
[picture p13: CAD file, 2026-11-04]
models/v0.2/stl/SR02_02_Front_Radome.stl
100.0 x 9.20 x 116.0
