wonderbench/mianguang/research/datasheets/C1001_step/JQC1001.step

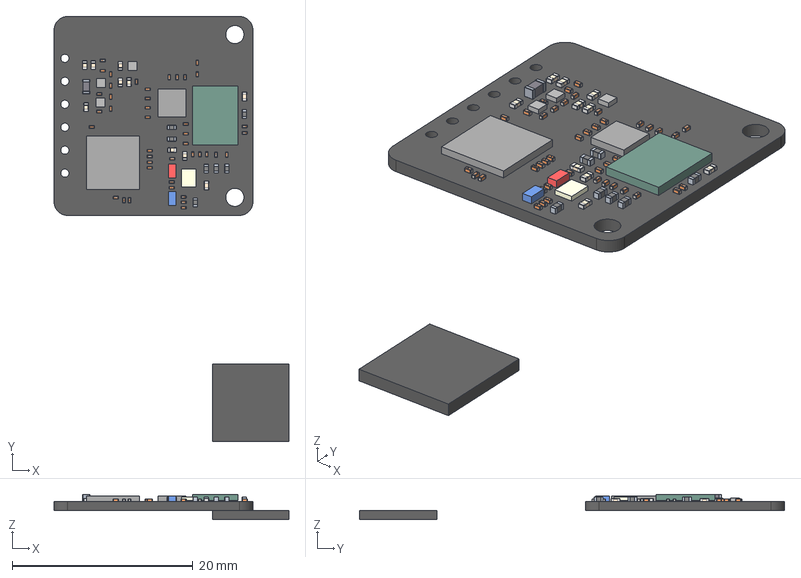
[picture p14: CAD file, 2026-11-04]
research/datasheets/C1001_step/JQC1001.step
26.0 x 47.0 x 2.79 mm
Board
Extruded x 10
User_Library-0201(0603M)_Cap x 42
User_Library-C-0402 x 12
Lötende x 14
User_Library-FB_1608-1_Pad001
User_Library-FB_1608-1_Cut
