wonderbench/mianguang/models/stl/SR01_09_Wall_Plate.stl

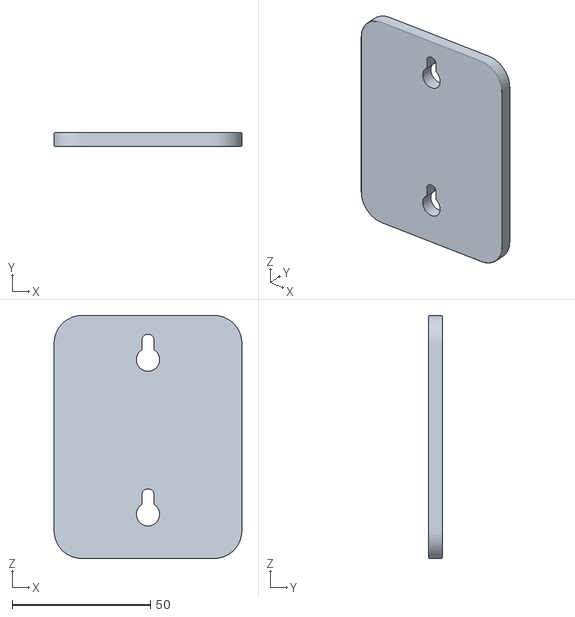
[picture p15: CAD file, 2026-11-04]
models/stl/SR01_09_Wall_Plate.stl
68.0 x 5.00 x 88.0
