wonderbench/mianguang/models/v0.2/stl/SR02_04_Captive_Top_Key.stl

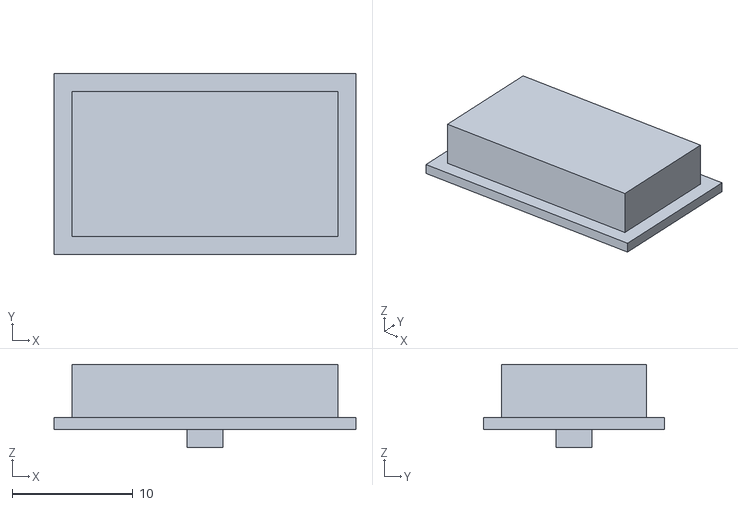
[picture p16: CAD file, 2026-11-04]
models/v0.2/stl/SR02_04_Captive_Top_Key.stl
25.0 x 15.0 x 6.90
