wonderbench/mianguang/models/stl/SR01_07_Desk_Riser.stl

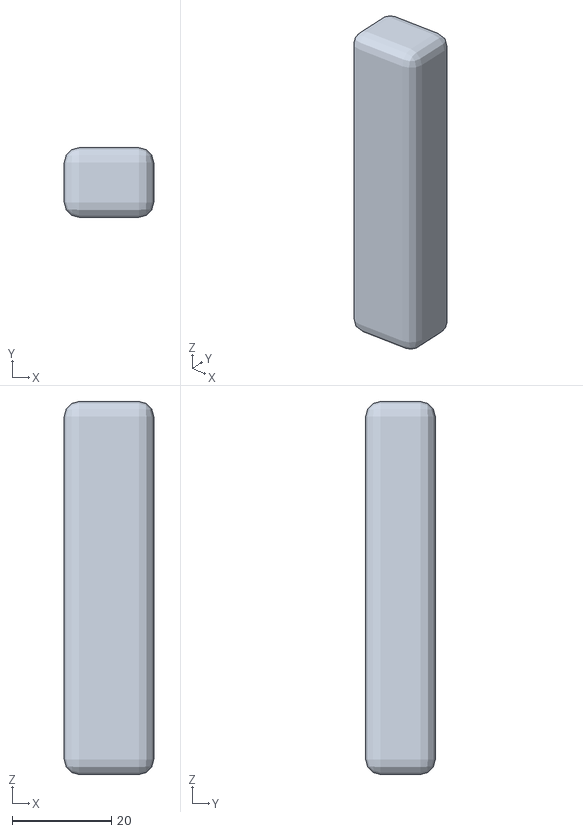
[picture p17: CAD file, 2026-11-04]
models/stl/SR01_07_Desk_Riser.stl
18.0 x 14.0 x 75.0
