wonderbench/mianguang/models/v0.2/stl/SR02_08_Desk_Stand_Base.stl

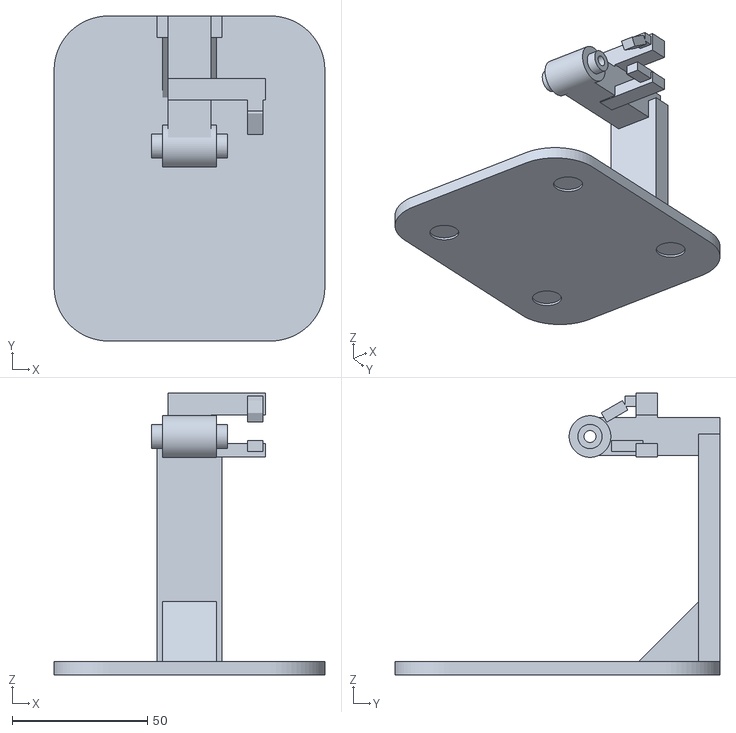
[picture p18: CAD file, 2026-11-04]
models/v0.2/stl/SR02_08_Desk_Stand_Base.stl
100.0 x 120.0 x 104.0
