wonderbench/mianguang/models/stl/SR01_06_Rear_Dock.stl

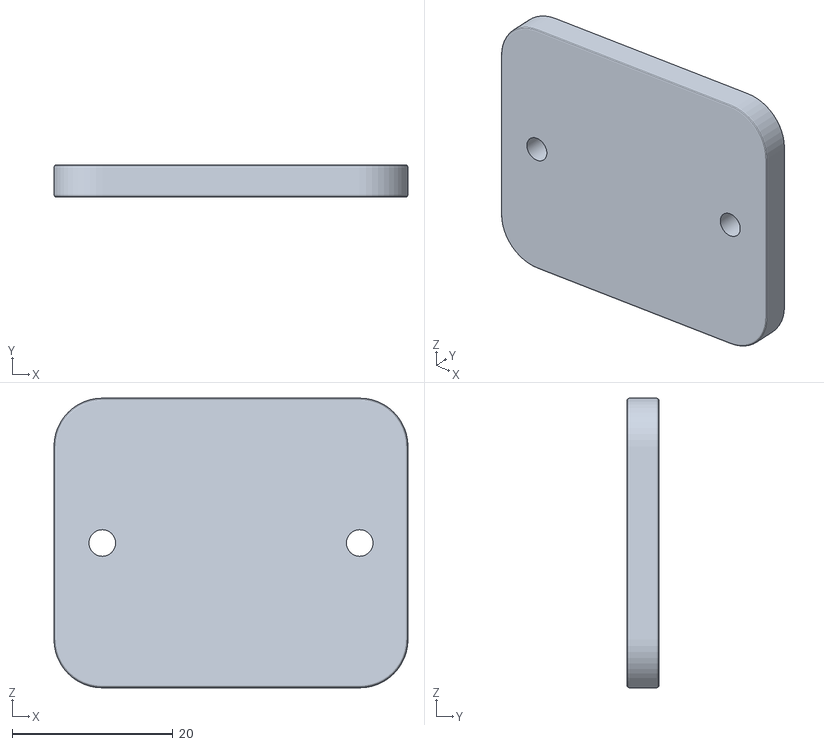
[picture p19: CAD file, 2026-11-04]
models/stl/SR01_06_Rear_Dock.stl
44.0 x 4.00 x 36.0
