wonderbench/mianguang/models/v0.2/stl/SR02_01_Rear_Tub.stl

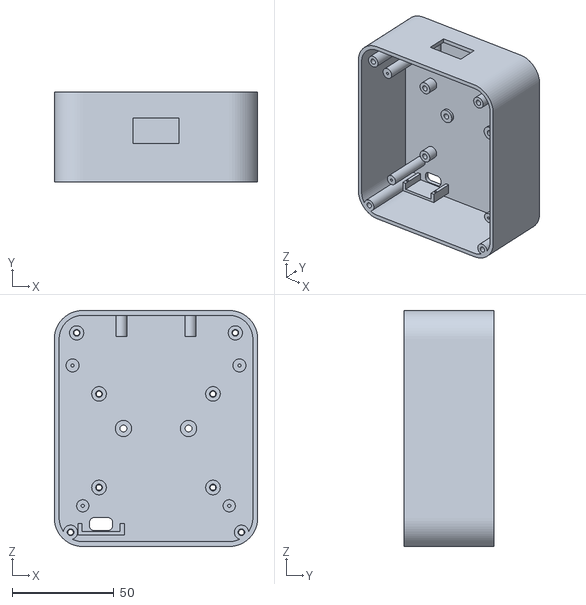
[picture p20: CAD file, 2026-11-04]
models/v0.2/stl/SR02_01_Rear_Tub.stl
100.0 x 44.0 x 116.0
