wonderbench/mianguang/models/stl/SR01_01_Rear_Tub.stl

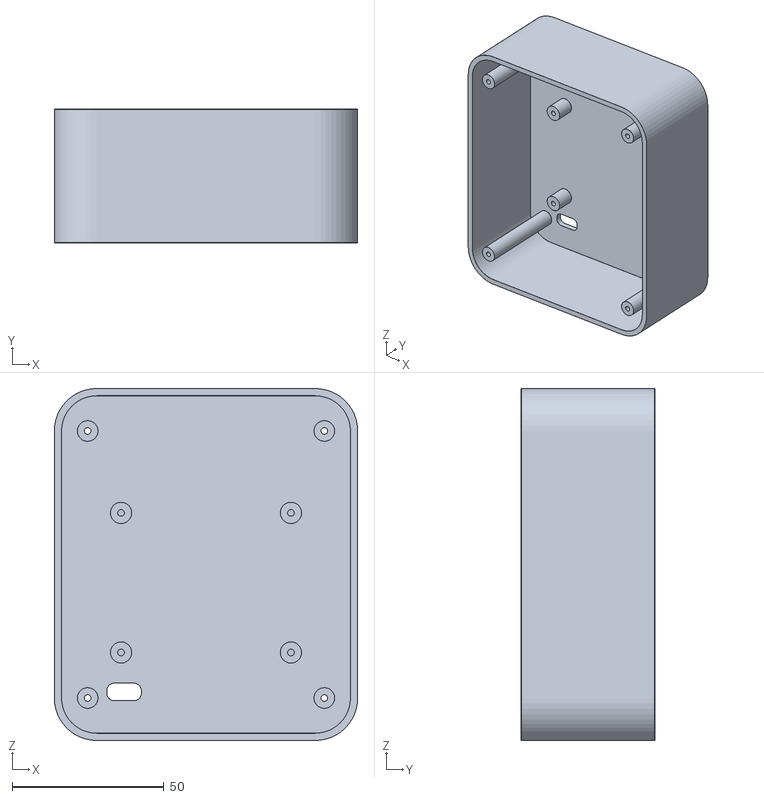
[picture p21: CAD file, 2026-11-04]
models/stl/SR01_01_Rear_Tub.stl
100.0 x 44.0 x 116.0
