wonderbench/mianguang/models/v0.2/stl/SR02_14_USB_Retainer.stl

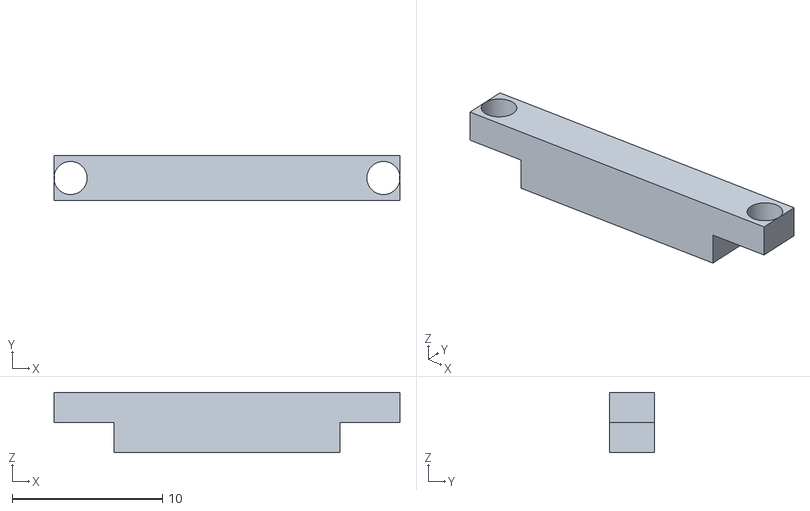
[picture p22: CAD file, 2026-11-04]
models/v0.2/stl/SR02_14_USB_Retainer.stl
23.0 x 3.00 x 4.00
