wonderbench/mianguang/models/stl/SR01_10_Wall_Standoff.stl

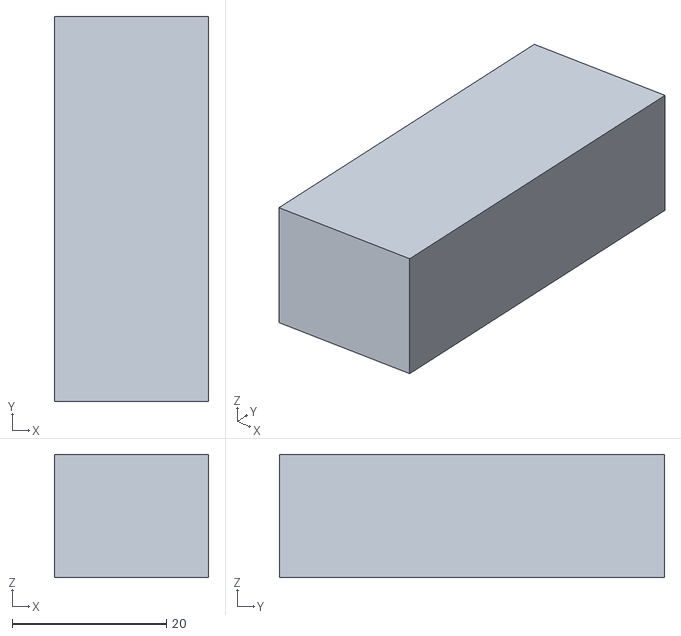
[picture p23: CAD file, 2026-11-04]
models/stl/SR01_10_Wall_Standoff.stl
20.0 x 50.0 x 16.0
