wonderbench/mianguang/models/v0.2/stl/SR02_09_Wall_Bracket_Plate.stl

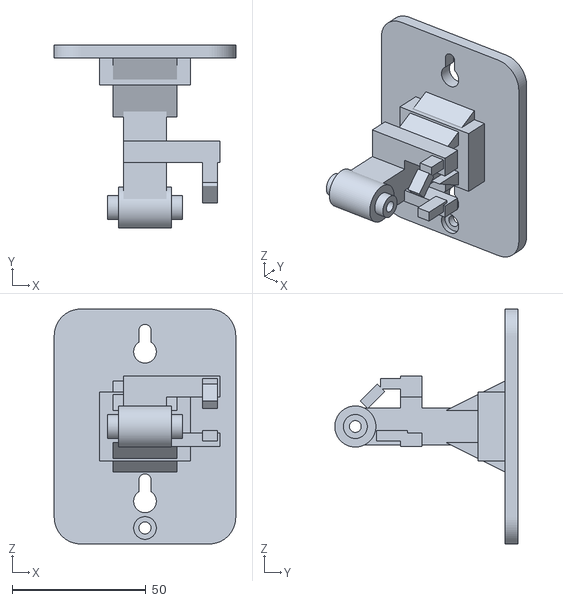
[picture p24: CAD file, 2026-11-04]
models/v0.2/stl/SR02_09_Wall_Bracket_Plate.stl
68.0 x 68.7 x 88.0
