wonderbench/mianguang/models/stl/SR01_03_Light_Diffuser.stl

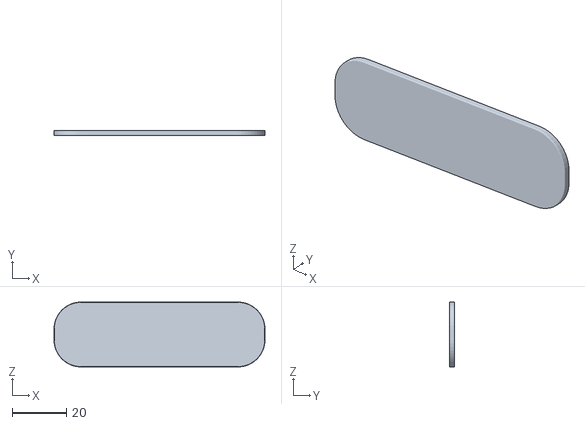
[picture p25: CAD file, 2026-11-04]
models/stl/SR01_03_Light_Diffuser.stl
78.0 x 2.00 x 24.0
