wonderbench/mianguang/models/v0.2/stl/SR02_05_Radar_Carrier.stl

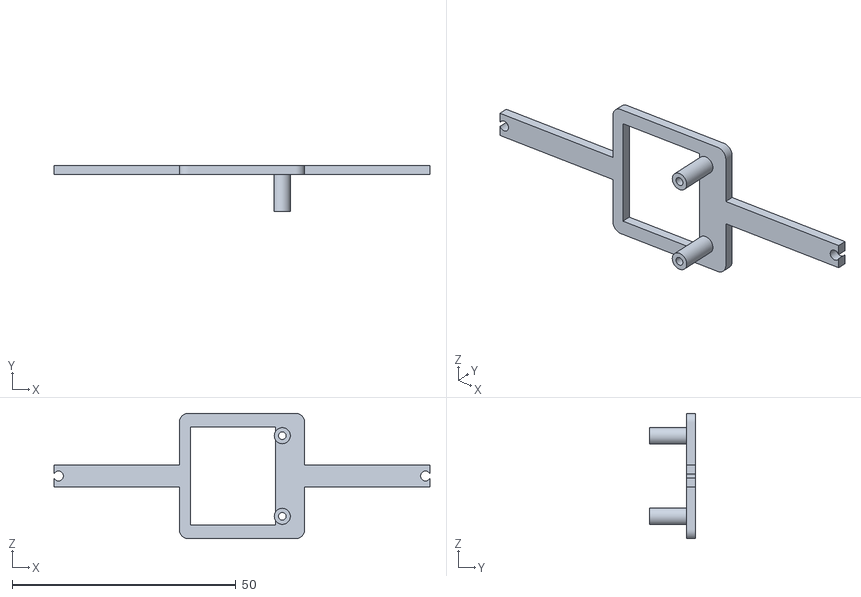
[picture p26: CAD file, 2026-11-04]
models/v0.2/stl/SR02_05_Radar_Carrier.stl
84.0 x 10.3 x 28.0
