wonderbench/mianguang/models/stl/SR01_02_Front_Radome_Frame.stl

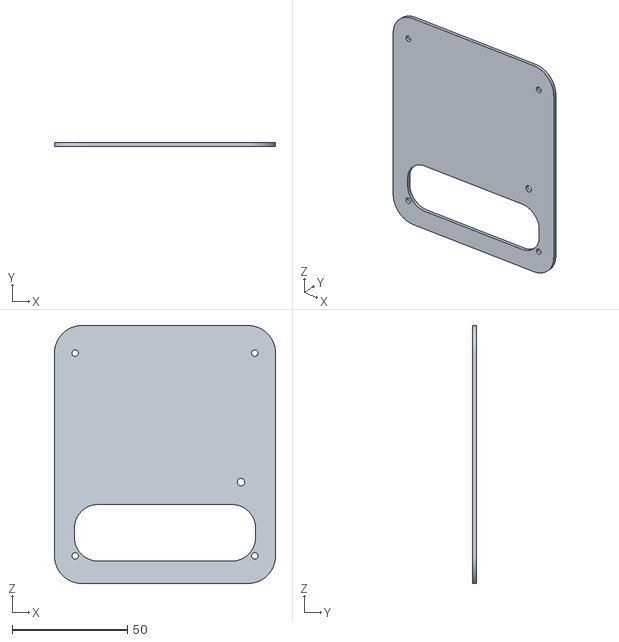
[picture p27: CAD file, 2026-11-04]
models/stl/SR01_02_Front_Radome_Frame.stl
96.0 x 1.60 x 112.0
