wonderbench/mianguang/models/v0.2/stl/SR02_03_Light_Diffuser.stl

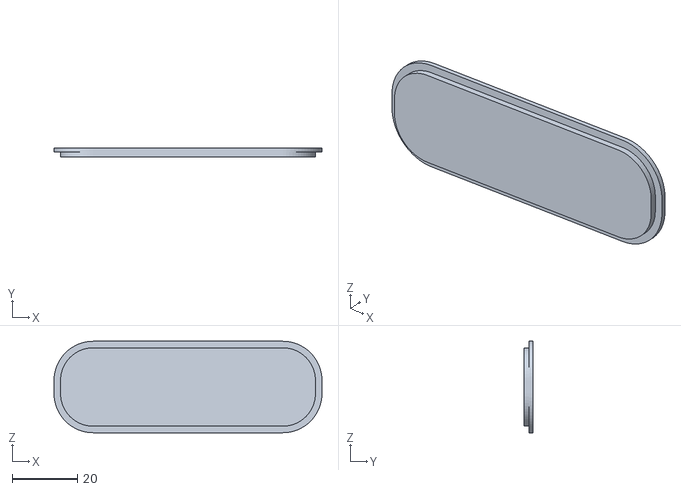
[picture p28: CAD file, 2026-11-04]
models/v0.2/stl/SR02_03_Light_Diffuser.stl
82.0 x 2.80 x 28.0
