wonderbench/mianguang/models/stl/SR01_08_Desk_Base.stl

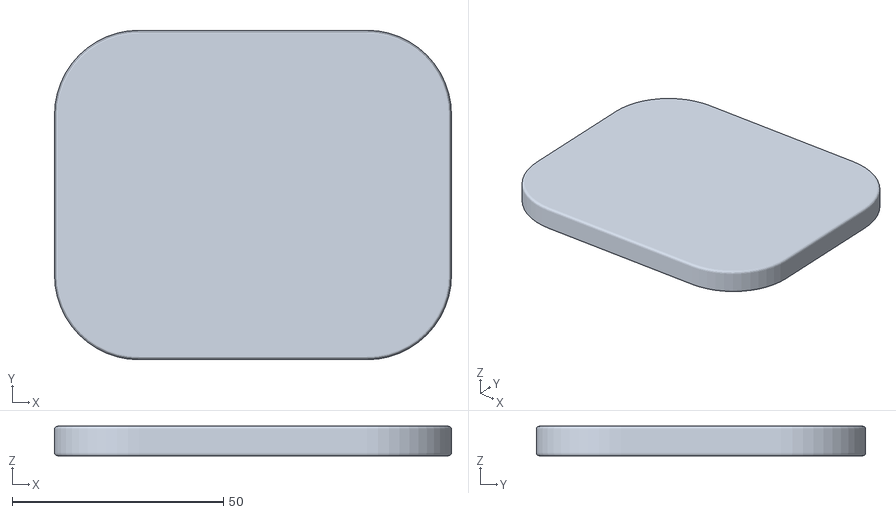
[picture p29: CAD file, 2026-11-04]
models/stl/SR01_08_Desk_Base.stl
94.0 x 78.0 x 7.00
