wonderbench/mianguang/models/v0.2/stl/SR02_07_Common_Dock_Yoke.stl

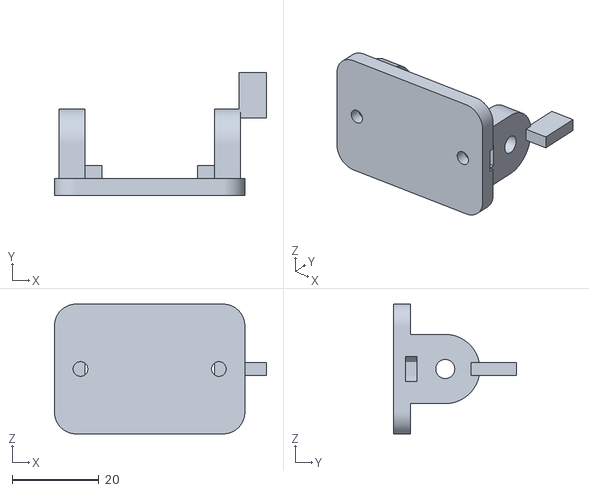
[picture p30: CAD file, 2026-11-04]
models/v0.2/stl/SR02_07_Common_Dock_Yoke.stl
49.0 x 28.5 x 30.0
