wonderbench/mianguang/models/stl/SR01_05_Radar_Tray.stl

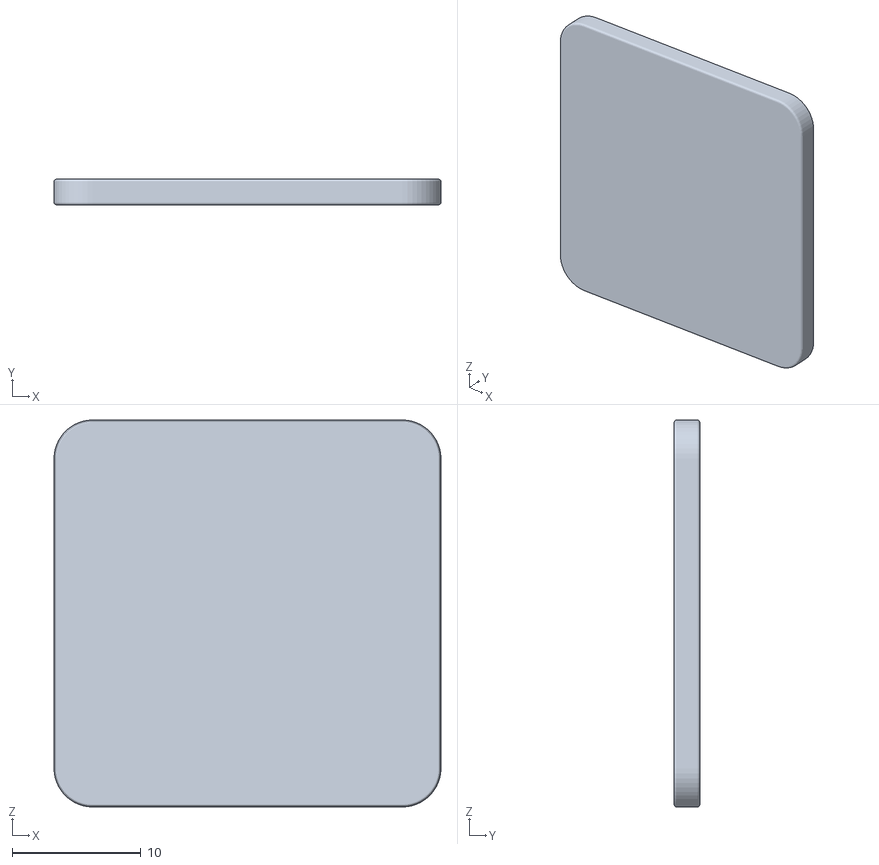
[picture p31: CAD file, 2026-11-04]
models/stl/SR01_05_Radar_Tray.stl
30.0 x 2.00 x 30.0
