wonderbench/mianguang/models/v0.2/stl/SR02_06_LED_Baffle.stl

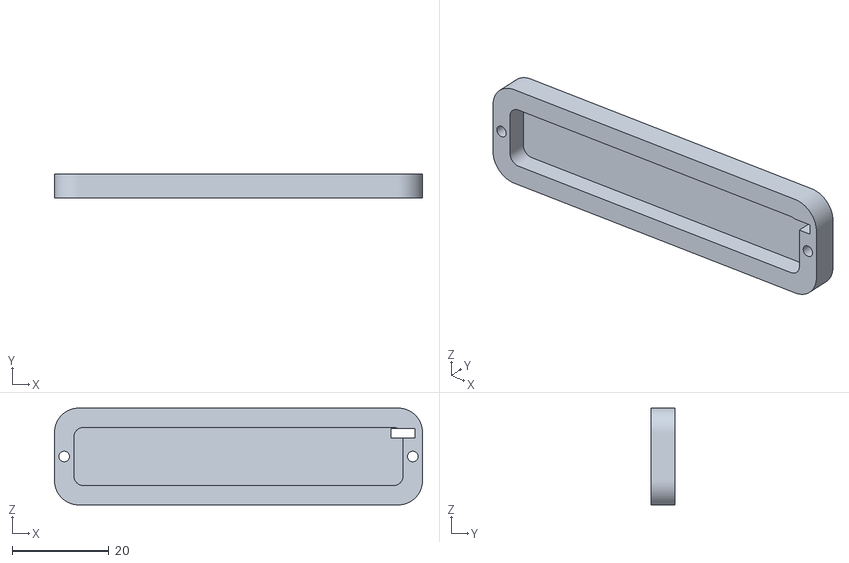
[picture p32: CAD file, 2026-11-04]
models/v0.2/stl/SR02_06_LED_Baffle.stl
76.0 x 5.00 x 20.0
