wonderbench/mianguang/models/v0.2/stl/SR02_12_Key_Switch_Bridge.stl

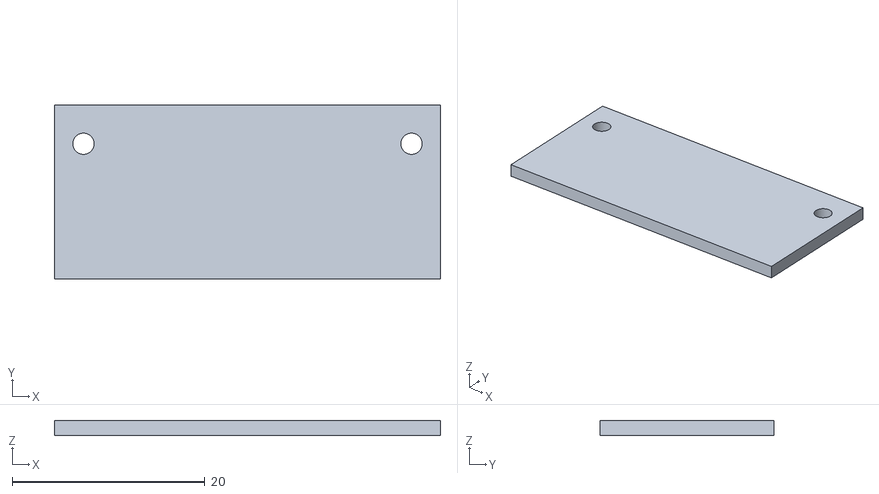
[picture p33: CAD file, 2026-11-04]
models/v0.2/stl/SR02_12_Key_Switch_Bridge.stl
40.0 x 18.0 x 1.60
