wonderbench/mianguang/(list of files, cad)

Other CAD files:
models/Sleep_Radar_Nightlight_Concept.blend
models/v0.2/Mianguang_Enclosure_V0.2.blend
research/datasheets/C1001_step/JQC1001.DWG
