wonderbench/mianguang/pcb/release_v03_precheck04/README_交付与装配.md

# 眠光 PCB V0.3 · PRECHECK04

日期：2026-11-05。此目录为收到PRECHECK03第二份在线PCB/SMT报告后的固定修订候选。**04尚未进行在线复检，未制造放行。**

## 本次最小修正

03第二份报告为PCB 0危险/16警告、SMT 0危险/1警告。SMT指出D1本体中央有丝印；04只调整D1封装顶丝印：删除中央二极管图形的四条线，把原阴极竖线移到本体外左侧。竖线中心X=33.2 mm、端点Y=7.4/8.6 mm，笔画8 mil（0.2032 mm），指示左侧1脚K。D1位号与上下轮廓保留。铜线、焊盘、孔位、器件位置和电气网络不作修改。

板仍为FR-4、2层、66 × 56 mm、厚1.6 mm、1 oz铜、绿色阻焊、白色丝印；目标表面工艺无铅喷锡。四个Ø2.7 mm NPTH中心为(5,5)、(61,5)、(5,51)、(61,51) mm，兼容既有V0.2外壳孔位和接口布局。尺寸/结构结论仅为数字几何验证。

## 同版交付文件

- `Mianguang_V0.3.epro2`：完整嘉立创EDA工程，含修订工程封装；`.esch`和`.epcb`为独立源快照。
- `BOM_Mianguang_V0.3.xlsx`和`.csv`：23件完整电气BOM，12个物料组。
- `PickPlace_Mianguang_V0.3.csv`：全部23件原生坐标。14件SMT专用BOM/坐标及9件手工项另见`../preflight_v03/smt_precheck04/`。
- `Gerber_Mianguang_V0.3.zip`：与`../preflight_v03/Mianguang_V0.3_DFM_PRECHECK_04.zip`相同，上传PCB及SMT分析。
- `Schematic_V0.3.png`、`PCB_Review_V0.3.pdf`：原理图及四页PCB查看文件。
- `native_checks.json`、`manifest.json`：原生严格检查及冻结文件身份。独立检查报告在上级`release_v03_precheck04_acceptance.json`和`release_v03_precheck04_fabrication.json`；差异、极性、导出及原始Gerber证据在`../qa/v03/precheck04/`。

上传Gerber仅删除经证明为主PTH精确子集的Via分类附表，全部保留层字节不变。主钻孔共38个PTH+4个NPTH；NPTH文件含明确NON_PLATED注释，不能为迎合PTH缺盘提示给安装孔补铜或删孔。

## 尚需确认的事项

1. 03第二份的8条`Pth无Pad`提示指向`Drill_NPTH_Through.DRL`。独立审计证实四个非镀铜机械孔源与导出一致，仍需DFM/CAM核对孔类型并记录处置；尚无平台豁免或零警告结论。
2. 另8条插件焊盘到贴片焊盘间距提示按既定工艺保留：14件SMT先回流、9件通孔/模块后手工装配。贴片方应确认手工焊接空间、工艺边/定位点；本版不作为波峰焊设计放行。
3. 03第二份已执行SMT DFM，但PDF不能证明全部14位号导入、选料和极性已逐项确认。04应重新分析并复核D1本体丝印提示是否消失，D1/D2/Q1方向按新极性表确认，D2实物阴极色带仍待供方包装图确认。
4. 两份03报告均选有铅喷锡；实际分析及最终加工设置应与目标无铅喷锡保持一致。

## 装配与上电

电路沿用V0.2操作要求：USB烧录前断开外部5 V并取下JP1/JP2/JP3；仅外供电时三个跳线装上、USB不接；受控双电源联调时拔下JP1，确认雷达有电后执行`radar on`。断电时切换跳线。J3接5 V自带限流、功率不超过0.5 W的灯板。外接件见本目录补充BOM，完整接线步骤见`../release_v02/README_交付与装配.md`；采购以本版完整BOM为准。

D1阴极向左，D2设计阴极向下，Q1单脚D在左、右下为G。原生旋转角度不等于贴片库零度，必须按实际针脚确认。原工程及本地检查通过不等于在线DFM、贴装匹配、首件焊接、电气、温升、射频或实物装配均通过。

03第二份原报告与复核位于`../qa/v03/online_dfm/PRECHECK_03_2_report.pdf`和`PRECHECK_03_2_review.md`。它们对应03，不能冒充04已通过。
