wonderbench/mianguang/models/mechanical/assembly_v02.md

# 眠光 V0.2 工程样机装配指南

适用日期：2026-11-04。适用工程：[Mianguang_Enclosure_V0.2.blend](../v0.2/Mianguang_Enclosure_V0.2.blend)；PCB 输入：[冻结 V0.2 交付](../../pcb/release_v02/)。本文依据 [主构建脚本](../scripts/build_enclosure_v02.py) 与 [支架脚本](../scripts/mount_v02.py) 描述样机装配目标。

本版允许开展打印配合验证。下面的紧固件和电子外形是采购约束或试配目标，不是已锁定的量产 BOM。到货尺寸、螺纹啮合、夹持力、线束和材料性能必须实测；不得仅凭模型或渲染图下结论。

## 结构零件与紧固件

STL 全套 11 件。两种安装方式共用九件机身零件，再选择桌面或壁挂支架；完整双模式套件保留两种支架。机身外形名义宽 100×高 116×深 44 mm，不含前盖突出、按键、支架和线缆。

| STL 零件 | 数量 | 用途与装配方式 |
|---|---:|---|
| `SR02_01_Rear_Tub` | 1 | 2.4 mm 名义壁厚；含 PCB、前盖、托盘、USB 和按键安装柱 |
| `SR02_02_Front_Radome` | 1 | 1.6 mm 前板、定位唇边及环境光筒；四颗前盖螺钉固定 |
| `SR02_03_Light_Diffuser` | 1 | 光窗 78×24 mm；背面法兰以薄胶垫固定到前盖 |
| `SR02_04_Captive_Top_Key` | 1 | 22×12 mm 键帽，下方法兰防脱；由实际开关提供回弹 |
| `SR02_05_Radar_Carrier` | 1 | C1001 双孔支撑及左右安装臂；可拆下进行 USB 检修 |
| `SR02_06_LED_Baffle` | 1 | 独立灯板托盘与遮光结构；灯线从侧槽引出 |
| `SR02_07_Common_Dock_Yoke` | 1 | 两种支架共用的活动后座；侧装 M3 螺母，M4 转轴 |
| `SR02_08_Desk_Stand_Base` | 1 | 连通的基座、立柱、悬臂和限位结构；基座 100×120×5 mm |
| `SR02_09_Wall_Bracket_Plate` | 1 | 连通的壁挂板、悬臂和限位结构；板体 68×88×5 mm |
| `SR02_12_Key_Switch_Bridge` | 1 | 托住独立按键小板；从下方装两颗 M2 螺钉 |
| `SR02_14_USB_Retainer` | 1 | 跨过受电小板前端无器件区域的可拆压条 |

| 紧固件或辅料 | 数量 | 当前目标与需要确认的尺寸 |
|---|---:|---|
| M2.5 内螺纹嵌件 | 8 | PCB 四处、前盖四处；模型导孔 Ø3.3，导孔深约 4.6/4.7 mm。嵌件外径、长度和安装工艺按实际产品试配，不将导孔尺寸当作嵌件外径 |
| M2.5 螺钉 | 8 | PCB 和前盖各四颗；M2.5×6 为试配起点。按实际嵌件、头型和夹持厚度核对长度，不能顶底或穿出外壳 |
| M2×6 螺钉 | 8 | USB 压条、按键桥、雷达托盘、灯托各两颗；安装柱为 Ø1.6 导孔，先做材料与牙型试配或攻牙试验 |
| M1.6×14 螺钉及配套螺母 | 各 2 | C1001 固定目标；模块孔 Ø2.0，支撑柱通孔 Ø1.7。板厚、柱高、螺母厚和露牙需核实，未额外计入垫圈厚度 |
| M3×10 螺钉 | 2 | 从壳内向后进入共用后座；必须在安装 PCB 前完成 |
| M3 六角螺母 | 2 | 目标对边 5.5、厚 2.4 mm；侧装槽对边 5.7、厚 2.7 mm |
| M4×50 转轴螺栓及 M4 锁紧螺母 | 各 1/安装模式 | 轴孔 Ø4.4；锁紧螺母包络对边 7、厚 5 mm。更换支架时可转移这一套硬件 |
| 纤维或聚合物摩擦垫圈 | 2/安装模式 | 外 Ø9、内 Ø4.4、厚 1 mm，放在中心耳与两侧活动耳之间 |
| 外侧金属垫圈 | 1/安装模式 | 外 Ø9、内 Ø4.4、厚 0.8 mm；垫圈总厚影响锁紧和露牙 |
| 粘贴硅胶脚垫 | 4/桌面模式 | Ø12×3 mm，约 1 mm 嵌入底座凹槽 |
| 墙面螺钉与锚固件 | 3/壁挂模式 | M4 盘头为几何目标；两处挂点、一处防抬起锁定。头径须能穿过 Ø8.5 入口并大于 4.5 mm 槽宽；长度及锚固方式按墙材另选 |
| 薄胶垫、不透光可拆胶带、线束固定件 | 按需 | 用于灯板、扩散片、按键小板、光感小板和天线；胶层厚度也要计入装配 |

螺纹仅以孔和包络表达，没有建模牙型。先打印孔、嵌件、螺母槽和转轴的配合试片，再决定工艺与补偿值。白色外观不要求所有内件透光；灯托及光筒必须在实物上确认能抑制串光。

## 电子件采购尺寸约束

| 电子件 | 当前模型约束 | 不应据此认定的事项 |
|---|---|---|
| V0.2 承载 PCB | 66×56×1.6 mm；四孔 Ø2.7，中心距 56×46；四孔在壳中 X=±28、Z=61/107 mm | Gerber 不规定板厚，需按交付要求下单 |
| XIAO ESP32C3 | 两排 1×7，行距 15.24、针距 2.54 mm；模块板边按官方 V1.3 针位配准，USB 朝壳体上方 | 排母塑壳 8.5 mm＋公针塑壳预留 2.5 mm＝11 mm 板底堆高是条件设计，不是已测完整插装高度 |
| XIAO 元件和检修插头 | 模块 PCB 厚暂按 1.6、顶面器件高暂按 3.2 mm；USB 插头 12×8 mm 截面、24 mm 轴向空间 | 具体 USB 线缆、接头、天线扣合高度和插入止点尚未固定 |
| J1–J5 接插件 | 插装和线束总体高度按载板元件面外 14 mm 预算；针序见接口证据 | PCB 排针封装不能保证任意带锁插壳都适配 |
| J2 雷达插壳 | 沿 X 宽度必须不大于 10.4 mm；与 JP2 跳帽名义侧隙仅约 0.26 mm | 极性键、倒角、壳体偏移和批次公差仍可能侵占间隙；必须测量候选窄体插壳 |
| C1001 | 22×22 mm，板厚近似 1 mm；右侧两孔 Ø2.0、间距 18 mm；背面器件和线束有 8 mm 条件预算 | 原厂 STEP 整体包络含不可靠自由模型，不能据此认定实际模组总高 |
| 面板 USB-C 受电小板 | 18×12×1.6 mm；后侧 USB 插口对准 X=−27、Z=43 mm；壳孔 11.4×6.4 mm | 前缘 3 mm 必须无器件，作为压持区（示意 Y=7.5..10.5）；压脚不得压焊点。板上 CC1/CC2 受电配置须符合 PCB 装配说明，外形匹配不能代替电气核对 |
| 夜灯灯板 | 65×9×1 mm，5 V 自带限流、功率不超过 0.5 W；侧向引线，薄胶垫固定 | LED 封装高度、胶层、散热与亮度均未实测 |
| 按键小板及开关 | 小板 10×10×1.6 mm，开关 6×6×5 mm；键帽侧隙约 0.3 mm、法兰与顶壁间隙约 0.8 mm | 开关有效行程暂以 0.25 mm 为调整目标；回弹、按压力和顶杆高度按到货件校准 |
| 环境光小板 | 8×8×1.6 mm，感光面贴近光筒后端，用可拆不透光胶带固定 | 常见更大尺寸 BH1750 成品板不能直接套用；须选合适小板或重新设计支座 |
| 2.4 GHz FPC 天线 | 有来源的 A-01 候选为 40×20×0.2 mm、80 mm 馈线，局部焊接总高≤1.8 mm；左内壁预留 2 mm 厚电子包络 | 随附批次、胶层、馈线长度/弯曲、接头扣合和装壳性能仍待实测 |

承载 PCB 背面为 Y=13 mm，焊脚预算截至 Y=16 mm。背壁内表面 Y=19.6 mm 的名义余量为 3.6 mm，但共用后座 M3 螺钉头局部更近；当前头部前表面 Y=16.4 mm，至焊脚预算仅 0.4 mm。修剪、检查全部焊脚及局部导线后再安装，不能用背壁余量代替螺钉头局部核对。

全部来源、坐标和已知尺寸见 [接口证据](interface_evidence.md) 与 [机械基准 JSON](pcb_v02_reference.json)。线束曲线是走线示意，不能直接作为下单线长；不得跨越雷达正前方、压在壳体接缝中或挡住跳帽。

## 装配顺序

1. **检查打印件与紧固件。** 核对 STL 毫米单位，清理孔和支撑残留；先试配嵌件、M3 侧装螺母、M4 轴及摩擦片。将八个 M2.5 嵌件安装到相应柱位，确认没有熔穿、开裂或外露金属接触 PCB 的情况。
2. **先装共用后座，再装 PCB。** 将两颗 M3 六角螺母从后座左右侧槽推入。后座贴合壳背；从敞开的壳内向后插入两颗 M3×10，拧入侧装螺母。该工序在 PCB 安装后不可直接从正面操作，不能倒置次序。确认后座贴合、螺母未转动、螺钉末端不侵入转轴空间。
3. **装 USB 受电小板。** 将小板放在后下方偏左的托台，插口对齐后壳开口；核对小板前缘 3 mm 无器件。压条只压该区域，使用两颗 M2×6 固定；按试配结果设置薄绝缘压垫，确认板不晃动且插拔力不由焊线承受。先用实际 USB 线检查插入与退出，引出待接 J1 的电源线。
4. **装顶部按键。** 从壳内将键帽穿出顶孔，使防脱法兰留在壳内。将 10×10 mm 开关板固定到桥板，开关对准顶杆；桥板两颗 M2×6 从下方向上固定。检查未按压时不触发、按下后能动作并自行回弹，引出待接 J4 的线束。
5. **固定天线与初步线束。** 在左内侧壁为 FPC 留出约 24×44 mm 粘贴检修区；按实际馈线端方向定位，并预留连接 XIAO ANT0 的松弛弧线。不要折压微型同轴接头。电源、按键、灯、光感和雷达线分别沿侧方整理，保留拔插余量。
6. **装承载 PCB 与 XIAO。** 用四颗 M2.5 试配螺钉将 PCB 固定到四柱；板背焊脚和后座螺钉头按上述预算复核。按真实插装状态测量 XIAO 堆高，确认两排针完整插入，模块 USB 朝上，外置天线接头正确扣合。安装 J1–J5 和 JP1/JP2/JP3 时逐项核对 V0.2 针序，特别检查 J2 窄体插壳与 JP2 的间隙。
7. **装夜灯。** 将 65×9 mm 限流灯板固定到独立灯托，线从侧槽引出，灯托用两颗 M2×6 固定到壳柱；确认螺孔、线槽互不侵占。将扩散片背面法兰以薄胶垫固定到前盖，避免漏光、松动和胶层侵入外观面。
8. **装 C1001 与雷达托盘。** 将 C1001 的两个 Ø2.0 孔对准托盘柱上的 18 mm 孔距，用两套 M1.6×14 与螺母固定，检查实际板厚、元件和线束没有压在支撑柱上。天线面朝前；托盘用左右两颗 M2×6 固定到壳体。核对雷达背部空间，并保持正前方无金属紧固件及导线。
9. **装环境光小板并合盖。** 将 8×8 mm 感光小板贴到光筒后端、感光面朝孔，用可拆不透光胶带固定；检查灯亮时的内部串光路径。接好 J3 灯线与 J5 光感线，缓慢合上前盖，确认线束未夹入定位唇边，再装四颗前盖 M2.5 螺钉。光筒与感光板随前盖移动，不得用短线强拉 PCB。
10. **选择一种支架并做断电试装。** 按下一节安装桌面或壁挂支架，转动到两个端点，检查实际线缆、墙面、底座和机身之间的空间。数字检查中的静态间隙不能代替这一动作。

## 桌面与壁挂

两种模式共用转轴中心 `(0,34,90)` mm 和活动后座。将固定支架中心耳放进活动后座的两耳之间，每侧放一片 Ø9×1 mm 摩擦垫圈；从侧面穿入 M4×50，另一侧放 0.8 mm 金属垫圈与 M4 锁紧螺母。调节到能可靠保持姿态、又不压裂打印耳的状态；锁紧扭矩须通过实际材料和样件确定。

桌面模式装四个 Ø12×3 mm 硅胶脚垫，使用 100×120×5 mm 基座。机械止挡目标为 0–30° 向下俯转。放在实际床头柜上检查倾覆、脚垫滑移、按键操作和 USB 拉线时的稳定性；5 mm 基座并未完成承载或长期蠕变测试。

壁挂模式的两处承力槽中心孔距为 56 mm（中性装配坐标 Z=70/126 mm），下方另有 Z=52 mm 的防抬起锁定孔。按墙材选择三套固定件：先使两颗挂点螺钉头穿过钥匙孔大端，再向下滑入窄槽，最后装好下方锁定螺钉。机械止挡目标为 0–45°；墙面固定强度、螺钉头适配和实际线缆弯曲均未由模型证明。

安装模式只描述机械兼容性。雷达仍需对准单人胸部并验证距离和姿态；普通床头柜位置不自动满足睡眠监测安装条件。相关产品资料和安装限制见仓库 [研究记录](../../research/source_notes.md)。

## USB 调试与拆修

1. 关闭并拔掉外部 5 V 电源，取下四颗前盖螺钉，托住前盖缓慢打开。
2. 先拔开灯线和环境光线，标记插头方向；如为一体线束，先释放固定点，不牵拉焊点。再取下雷达托盘的两颗 M2 螺钉，视需要断开雷达线束，将托盘与 C1001 一起移开。
3. 拔下 **JP1、JP2、JP3 三个跳帽**，确认外部 5 V 仍断开，再将调试线插入 XIAO 自带 USB。只拔 JP1 不能隔离 UART。24 mm 插入区是拆盖、拆托盘后的临时服务空间，不支持将调试线永久夹在闭合壳内。
4. 完成调试后先拔掉 XIAO USB，再按 V0.2 装配说明恢复跳帽和各线束。复装雷达托盘、灯线与光感线，检查夹线和极性后合盖，最后恢复外部供电。

若需要拆共用后座，必须先拆到能够取下 PCB，再从壳内拆 M3×10。不能用转动整个后座的方式强行松螺钉。

## 数字核对与实物放行边界

| 入口 | 能说明什么 | 不能替代什么 |
|---|---|---|
| [PCB 机械基准](pcb_v02_reference.json)、[接口证据](interface_evidence.md) | 输入文件 SHA-256、孔位、23 元件放置、官方尺寸与假设的来源 | 采购件实测、焊接和制造公差 |
| [fit_parameters.json](../v0.2/fit_parameters.json) | 构建参数、PCB 清单指纹和设计计算记录 | 独立几何复核；构建时 `design_conditions` 不等于实测结果 |
| [geometry_checks.json](../v0.2/geometry_checks.json) | 以报告列出的对象、版本和检查项为限的独立几何结果 | 未列对象、连续运动证明、实物配合、线缆柔性和承载 |
| [mesh_checks.json](../v0.2/mesh_checks.json) | 各 STL 非流形边、连通实体数、体积和外包尺寸 | 打印成功、材料强度、装配顺序或结构寿命 |
| [支架记录](mount_notes.md)、[复核记录](review_v02.md) | 设计关系、局部复核范围及问题修正记录 | 最新保存工程的完整检查结论 |

应读取最新报告的逐项状态和输入指纹；报告缺失、失败、未验证或重建后未更新时，相应项目仍未完成。本指南不预设所有几何项目通过。

首轮打印后至少完成嵌件/轴孔配合、全角度动作、三跳帽与 USB 检修、灯板/按键/光感固定、馈线松弛及墙面/桌面稳定性验证。再做相同安装条件下的裸雷达与装壳对比、灯亮/灭对比、温升与光感串光检查。白色 1.6 mm 前板、约 4.5 mm 天线前方间隙和暖光渲染只描述设计起点，不构成射频、照度、色温或医疗性能验证。
