wonderbench/mianguang/firmware/reports/board_build.txt

<project>/.tooling/pio/lib/python3.9/site-packages/urllib3/__init__.py:35: NotOpenSSLWarning: urllib3 v2 only supports OpenSSL 1.1.1+, currently the 'ssl' module is compiled with 'LibreSSL 2.8.3'. See: https://github.com/urllib3/urllib3/issues/3020
  warnings.warn(
Processing xiao_esp32c3 (platform: espressif32@6.12.0; board: seeed_xiao_esp32c3; framework: arduino)
--------------------------------------------------------------------------------
<project>/.tooling/pio/lib/python3.9/site-packages/urllib3/__init__.py:35: NotOpenSSLWarning: urllib3 v2 only supports OpenSSL 1.1.1+, currently the 'ssl' module is compiled with 'LibreSSL 2.8.3'. See: https://github.com/urllib3/urllib3/issues/3020
  warnings.warn(
Verbose mode can be enabled via `-v, --verbose` option
CONFIGURATION: https://docs.platformio.org/page/boards/espressif32/seeed_xiao_esp32c3.html
PLATFORM: Espressif 32 (6.12.0) > Seeed Studio XIAO ESP32C3
HARDWARE: ESP32C3 160MHz, 320KB RAM, 4MB Flash
DEBUG: Current (cmsis-dap) External (cmsis-dap, esp-bridge, esp-builtin, esp-prog, iot-bus-jtag, jlink, minimodule, olimex-arm-usb-ocd, olimex-arm-usb-ocd-h, olimex-arm-usb-tiny-h, olimex-jtag-tiny, tumpa)
PACKAGES: 
 - framework-arduinoespressif32 @ 3.20017.241212+sha.dcc1105b 
 - tool-esptoolpy @ 2.40900.250804 (4.9.0) 
 - toolchain-riscv32-esp @ 8.4.0+2021r2-patch5
LDF: Library Dependency Finder -> https://bit.ly/configure-pio-ldf
LDF Modes: Finder ~ chain, Compatibility ~ soft
Found 34 compatible libraries
Scanning dependencies...
Dependency Graph
|-- sleep_core
|-- Wire @ 2.0.0
Building in release mode
Compiling .pio/build/xiao_esp32c3/src/main.cpp.o
Building .pio/build/xiao_esp32c3/bootloader.bin
Generating partitions .pio/build/xiao_esp32c3/partitions.bin
Compiling .pio/build/xiao_esp32c3/lib2df/sleep_core/c1001_protocol.cpp.o
Compiling .pio/build/xiao_esp32c3/lib2df/sleep_core/monitor_logic.cpp.o
Compiling .pio/build/xiao_esp32c3/lib2df/sleep_core/radar_client.cpp.o
Compiling .pio/build/xiao_esp32c3/lib2df/sleep_core/user_input.cpp.o
esptool.py v4.9.0
Creating esp32c3 image...
Merged 1 ELF section
Successfully created esp32c3 image.
Compiling .pio/build/xiao_esp32c3/lib0a5/Wire/Wire.cpp.o
Compiling .pio/build/xiao_esp32c3/FrameworkArduino/Esp.cpp.o
Compiling .pio/build/xiao_esp32c3/FrameworkArduino/FirmwareMSC.cpp.o
Compiling .pio/build/xiao_esp32c3/FrameworkArduino/FunctionalInterrupt.cpp.o
Compiling .pio/build/xiao_esp32c3/FrameworkArduino/HWCDC.cpp.o
Compiling .pio/build/xiao_esp32c3/FrameworkArduino/HardwareSerial.cpp.o
Compiling .pio/build/xiao_esp32c3/FrameworkArduino/IPAddress.cpp.o
Compiling .pio/build/xiao_esp32c3/FrameworkArduino/IPv6Address.cpp.o
Compiling .pio/build/xiao_esp32c3/FrameworkArduino/MD5Builder.cpp.o
Compiling .pio/build/xiao_esp32c3/FrameworkArduino/Print.cpp.o
Compiling .pio/build/xiao_esp32c3/FrameworkArduino/Stream.cpp.o
Compiling .pio/build/xiao_esp32c3/FrameworkArduino/StreamString.cpp.o
Compiling .pio/build/xiao_esp32c3/FrameworkArduino/Tone.cpp.o
Compiling .pio/build/xiao_esp32c3/FrameworkArduino/USB.cpp.o
Archiving .pio/build/xiao_esp32c3/lib2df/libsleep_core.a
Compiling .pio/build/xiao_esp32c3/FrameworkArduino/USBCDC.cpp.o
Compiling .pio/build/xiao_esp32c3/FrameworkArduino/USBMSC.cpp.o
Compiling .pio/build/xiao_esp32c3/FrameworkArduino/WMath.cpp.o
Compiling .pio/build/xiao_esp32c3/FrameworkArduino/WString.cpp.o
Compiling .pio/build/xiao_esp32c3/FrameworkArduino/base64.cpp.o
Compiling .pio/build/xiao_esp32c3/FrameworkArduino/cbuf.cpp.o
Compiling .pio/build/xiao_esp32c3/FrameworkArduino/esp32-hal-adc.c.o
Archiving .pio/build/xiao_esp32c3/lib0a5/libWire.a
Compiling .pio/build/xiao_esp32c3/FrameworkArduino/esp32-hal-bt.c.o
Compiling .pio/build/xiao_esp32c3/FrameworkArduino/esp32-hal-cpu.c.o
Compiling .pio/build/xiao_esp32c3/FrameworkArduino/esp32-hal-dac.c.o
Compiling .pio/build/xiao_esp32c3/FrameworkArduino/esp32-hal-gpio.c.o
Compiling .pio/build/xiao_esp32c3/FrameworkArduino/esp32-hal-i2c-slave.c.o
Compiling .pio/build/xiao_esp32c3/FrameworkArduino/esp32-hal-i2c.c.o
Compiling .pio/build/xiao_esp32c3/FrameworkArduino/esp32-hal-ledc.c.o
Compiling .pio/build/xiao_esp32c3/FrameworkArduino/esp32-hal-matrix.c.o
Compiling .pio/build/xiao_esp32c3/FrameworkArduino/esp32-hal-misc.c.o
Compiling .pio/build/xiao_esp32c3/FrameworkArduino/esp32-hal-psram.c.o
Compiling .pio/build/xiao_esp32c3/FrameworkArduino/esp32-hal-rgb-led.c.o
Indexing .pio/build/xiao_esp32c3/lib0a5/libWire.a
Indexing .pio/build/xiao_esp32c3/lib2df/libsleep_core.a
Compiling .pio/build/xiao_esp32c3/FrameworkArduino/esp32-hal-rmt.c.o
Compiling .pio/build/xiao_esp32c3/FrameworkArduino/esp32-hal-sigmadelta.c.o
Compiling .pio/build/xiao_esp32c3/FrameworkArduino/esp32-hal-spi.c.o
Compiling .pio/build/xiao_esp32c3/FrameworkArduino/esp32-hal-time.c.o
Compiling .pio/build/xiao_esp32c3/FrameworkArduino/esp32-hal-timer.c.o
Compiling .pio/build/xiao_esp32c3/FrameworkArduino/esp32-hal-tinyusb.c.o
Compiling .pio/build/xiao_esp32c3/FrameworkArduino/esp32-hal-touch.c.o
Compiling .pio/build/xiao_esp32c3/FrameworkArduino/esp32-hal-uart.c.o
Compiling .pio/build/xiao_esp32c3/FrameworkArduino/firmware_msc_fat.c.o
Compiling .pio/build/xiao_esp32c3/FrameworkArduino/libb64/cdecode.c.o
Compiling .pio/build/xiao_esp32c3/FrameworkArduino/libb64/cencode.c.o
Compiling .pio/build/xiao_esp32c3/FrameworkArduino/main.cpp.o
Compiling .pio/build/xiao_esp32c3/FrameworkArduino/stdlib_noniso.c.o
Compiling .pio/build/xiao_esp32c3/FrameworkArduino/wiring_pulse.c.o
Compiling .pio/build/xiao_esp32c3/FrameworkArduino/wiring_shift.c.o
Archiving .pio/build/xiao_esp32c3/libFrameworkArduino.a
Indexing .pio/build/xiao_esp32c3/libFrameworkArduino.a
Linking .pio/build/xiao_esp32c3/firmware.elf
Retrieving maximum program size .pio/build/xiao_esp32c3/firmware.elf
Checking size .pio/build/xiao_esp32c3/firmware.elf
Advanced Memory Usage is available via "PlatformIO Home > Project Inspect"
RAM:   [=         ]   5.1% (used 16852 bytes from 327680 bytes)
Flash: [==        ]  22.1% (used 289732 bytes from 1310720 bytes)
Building .pio/build/xiao_esp32c3/firmware.bin
esptool.py v4.9.0
Creating esp32c3 image...
Merged 2 ELF sections
Successfully created esp32c3 image.
========================= [SUCCESS] Took 7.66 seconds =========================
