wonderbench/mianguang/pcb/release_v03/README_交付与装配.md

# 眠光 PCB V0.3 · DFM 预检候选

日期：2026-11-05。完整工程为 `Mianguang_V0.3.epro2`，使用嘉立创 EDA 专业版 4.1.78 导出。此目录是版本固定的预检候选；在线 DFM 由用户手动上传，报告尚未回传，制造放行状态为 **待完成**。

## 本轮修正

- J1–J5、JP1–JP3 的厂家名称及供应商封装描述与器件库精确匹配，关闭原 V0.2 的 8 个排针采购属性提示。
- C1/C4 保持 `CL21A106KAYNNNE`、10 µF、25 V、X5R、0805；采购编号改为已核对的 `C15850`，补齐厂家和电容属性。
- 16 条独立丝印文字采用 40 mil 字高、6 mil 笔画；修正 C0603、D1、D2、F1、Q1 的封装丝印。移动两个顶部标题和 D1 位号，避免文字相互覆盖。
- 从同一工程重新导出原理图、PCB、完整工程、网表、BOM、坐标、Gerber 和预览。检查记录绑定 `.esch`、`.epcb`、`.epro2` 的 SHA-256，包含实际使用的 10 种封装。

原理图和 PCB 原生严格检查均返回 `true`，详情为 `[]`。保存、关闭和重开后，设计记录与导出源相符；仅忽略编辑器重建的记录序号及文档时间/客户端标识。独立验收和制造几何结果分别位于上一级目录的 `release_v03_acceptance.json`、`release_v03_fabrication.json`。这些结果不替代尚未回传的在线 DFM 报告。

## 文件使用

| 文件 | 用途 |
|---|---|
| `Mianguang_V0.3.epro2` | 可导入嘉立创 EDA 的完整工程，含修改后的工程库 |
| `Mianguang_V0.3.esch`、`Mianguang_V0.3.epcb` | 原理图和 PCB 源快照，关联封装以完整工程为准 |
| `BOM_Mianguang_V0.3.xlsx`、`.csv` | 载板 23 个元件、12 个物料组的电气 BOM |
| `外接件与装配BOM.csv` | 沿用的整机外接件、模块、线束、插座和装配附件 |
| `PickPlace_Mianguang_V0.3.csv` | 坐标及方向；U1/排针为手工装配，未作贴片机原点标定 |
| `Gerber_Mianguang_V0.3.zip` | 原生制板图层与钻孔，可直接上传在线 DFM |
| `Schematic_V0.3.png`、`PCB_Review_V0.3.pdf` | 原理图与四页 PCB 查看文件 |
| `native_checks.json`、`manifest.json` | 原生检查证据和候选内容清单；在线报告未包含在本次候选中 |

`../preflight_v03/Mianguang_V0.3_DFM_PRECHECK_02.zip` 与本目录 Gerber ZIP 字节完全相同，专供手动上传。01 版预检包已被取代。

## 板参数与结构兼容

FR-4，2 层，66 × 56 mm，板厚 1.6 mm，1 oz 铜；本次制造检查按绿色阻焊、白色丝印参数进行。Gerber 不编码全部材料和表面处理要求，工艺选项应与分析/制板时填写的一致。

本轮铜层、63 个物理焊盘、23 个元件位置、42 个独立钻孔及所有网络连接均与 V0.2 一致。四个 Ø2.7 mm 不镀铜安装孔中心为 (5,5)、(61,5)、(5,51)、(61,51) mm。原 V0.2 Blender 外壳的孔位、接口和内部位置依据仍适用，无需因本轮丝印/采购属性修订重做模型。

工程库保存时部分远程 3D 资源 UUID 发生重新映射；模型名称及放置变换未变。上述兼容结论基于实际 PCB 几何，不宣称这些远程模型文件二进制相同，也不替代实物装配验证。

钻孔主文件 `Drill_PTH_Through.DRL` 含 38 个镀铜孔，`Drill_NPTH_Through.DRL` 含 4 个不镀铜孔。`Drill_PTH_Through_Via.DRL` 的 4 个过孔是主 PTH 文件的精确子集，不能重复计入加工孔。

## 接线与上电

电路和固件操作沿用 V0.2，固件仍为 V0.2.0。完整装配和首件测量步骤见仓库 `pcb/release_v02/README_交付与装配.md`；其中采购属性警告与旧 C1/C4 采购信息以本版文件为准。

| 接口 | 载板针序 |
|---|---|
| J1 外部供电 | 1=5V_IN，2=GND |
| J2 C1001 雷达 | 1=5V_SYS，2=GND，3=模块 RX，4=模块 TX |
| J3 夜灯 | 1=5V_SYS，2=LED_LOW；使用 5 V 自带限流、功率不超过 0.5 W 的灯板 |
| J4 按键 | 1=BUTTON_N，2=GND；常开瞬时按键 |
| J5 光感 | 1=3V3，2=GND，3=SDA，4=SCL；BH1750 地址 0x23，上拉只接 3.3 V |

所有跳线在断电时切换。USB 烧录前断开外部 5 V，并拔下 JP1、JP2、JP3。受控双电源联调时 JP1 拔下、JP2/JP3 装上，确认雷达供电后执行 `radar on`；单外部供电时三个跳线均装上，USB 不接。当前固件尚未实现上电自动启用或自动掉电禁能。

在线 DFM 报告回传后按实际问题位置复核，必要时重新导出新候选。首件仍需完成焊接导通、负载压降、温升、UART、夜灯及整机装配测试；本次没有实物测试记录。

## 检查范围依据

丝印字高至少 1 mm、笔画至少 0.15 mm、到焊盘间距至少 0.15 mm等规则依据[嘉立创 PCB 工艺能力](https://jlcpcb.com/capabilities/pcb-capabilities)。普通专业版严格 DRC 与[仅私有部署支持的增强 DFM 规则](https://prodocs.lceda.cn/cn/private/enterprise/drc-dfm-rules.html)不是同一套能力；本次未将未执行的增强规则或在线分析写为通过。
