wonderbench/mianguang/pcb/release_v03_precheck03/README_交付与装配.md

# 眠光 PCB V0.3 · PRECHECK 03

日期：2026-11-05。此目录为收到 PRECHECK 02 在线报告后修订的固定候选，完整工程、BOM、坐标及制板图层均已重新导出。**03 版尚需用户重新上传 PCB DFM；SMT DFM 未执行，未制造放行。**

## 根据在线报告完成的修正

| 02 版报告问题 | 03 版处理与状态 |
|---|---|
| 焊盘孔环 0 mm，8 项危险 | 四个不镀铜安装孔改用原生圆形挖槽，去除两铜层内的同径虚拟焊盘。孔径和坐标保持不变；孔内铜图形去除后不改变实际成板铜线。是否消除在线项需重新上传确认。 |
| 丝印距焊盘 0.1 mm，50 项危险 | 按实际阻焊窗口边界留距，简化无极性器件外框、扩大排针外框、修正极性器件标记。新增本地门槛为距阻焊窗 ≥0.25 mm。 |
| 丝印距孔 0 mm，16 项危险、4 项警告 | 移走 C3 位号、删除 R5 贴近过孔的外框，检查全部独立钻孔边界。上传包去掉重复 Via 分类钻孔附表，保留完整主 PTH/NPTH 文件。 |
| 丝印线宽 0.15 mm，49 项警告 | 可见文字及保留轮廓描线最小 8 mil（0.2032 mm），文字字高不小于40 mil（1.016 mm）。 |
| 插件焊盘到贴片焊盘 2.32 mm，8 项警告 | **保留的工艺提示，尚未由板厂确认。** 既定装配为14件SMT先回流，9件通孔/模块后手工插装焊接；本版不作为波峰焊装配设计。不得把这8项写成零警告。 |

D1 保留中央二极管/阴极符号；D2 保留靠1脚的阴极横杠；Q1 新增1脚旁标记圆点。位号、接口针序和上电提示保持可读。

## 同版文件

- `Mianguang_V0.3.epro2`：完整嘉立创 EDA 工程，含修订后的工程封装。
- `Mianguang_V0.3.esch`、`Mianguang_V0.3.epcb`：同版源快照；工程库以完整工程包为准。
- `BOM_Mianguang_V0.3.xlsx`、`.csv`：23个元件的完整电气BOM，共12个物料组。
- `PickPlace_Mianguang_V0.3.csv`：全部23件的原生坐标。14件SMT专用BOM与坐标另见仓库 `pcb/preflight_v03/smt_precheck03/`，9件手工项另列。
- `Gerber_Mianguang_V0.3.zip`：与 `../preflight_v03/Mianguang_V0.3_DFM_PRECHECK_03.zip` 字节相同，直接上传PCB DFM。
- `Schematic_V0.3.png`、`PCB_Review_V0.3.pdf`：原理图和四页PCB查看文件。
- `native_checks.json`、`manifest.json`：原生严格检查与文件身份。原始Gerber、钻孔去重证据及复核记录见 `../qa/v03/precheck03/`。

此 Gerber 包只删除原生 `Drill_PTH_Through_Via.DRL` 分类附表；已证明其4孔是主PTH文件的精确子集，所有保留文件的每个字节不变。上传包仅含38个PTH及4个NPTH，共42个独立孔。未经该证明不得自行删除其他钻孔文件。

## 工艺、结构与上电

载板为 FR-4、2层、66 × 56 mm、1.6 mm厚、1 oz铜，绿色阻焊、白色丝印，目标表面处理为无铅喷锡。02版报告实际选择了有铅喷锡；重新分析时请使工艺设置与最终采用的工艺一致。

四个 Ø2.7 mm NPTH 安装孔中心为 (5,5)、(61,5)、(5,51)、(61,51) mm。23个元件放置、63个物理焊盘、接口及网络保持不变，现有 V0.2 Blender 外壳的数字几何依据仍适用。圆形机械孔的表示发生变化，不能据此声称源文件或原始铜层字节与02版相同；核对的是实际孔形与钻孔后铜图形。

电路和固件操作沿用 V0.2：USB烧录前断开外部5 V、拔下JP1/JP2/JP3；仅外供电时三个跳线均装上、USB不接；受控双电源联调时JP1拔下，确认雷达有电后执行 `radar on`。所有跳线在断电时切换。J3使用5 V自带限流、功率不超过0.5 W的灯板。完整步骤见仓库 `pcb/release_v02/README_交付与装配.md`，采购信息以本版BOM为准。

SMT预览需核对选料、封装中心及实际引脚方向；原生角度不等于贴片库零度。D1阴极向左，D2设计阴极向下，Q1单脚D在左、右下为G。D2实物色带与阴极对应仍需供方包装图确认。工艺边/定位点及后续手工焊接安排应由贴片方确认，本版单板没有新增工艺边或MARK。

## 验证边界

原生原理图/PCB严格 DRC 均通过；离线验收另见上一级 `release_v03_precheck03_acceptance.json`。制造几何按 `online-preflight` 配置检查，报告为 `release_v03_precheck03_fabrication.json`。此配置是在原规则上增加距实际阻焊窗/钻孔≥0.25 mm、笔画≥0.20 mm；不代表复现了嘉立创服务器全部算法。

PRECHECK 02 在线报告归档于 `../qa/v03/online_dfm/PRECHECK_02_report.pdf`。03 版只能在新报告回传后更新在线结论；目前没有 SMT 平台确认、首件焊接、电气、温升或实物装配通过记录。
