wonderbench/mianguang/pcb/release_v02/README_交付与装配.md

# 眠光毫米波睡眠雷达夜灯｜PCB V0.2 交付与装配

版本：PCB V0.2；整理日期：2026-11-04。适用组合：DFRobot C1001 SEN0623、Seeed XIAO ESP32C3、5 V 自带限流暖白灯板；配套固件为 `mianguang_firmware_v0.2.0.zip`。这是用于接线、烧录和安装验证的受控工程样机。当前未进行开发板烧录、实物电气测试或整夜睡眠对照验证。

**交付状态：V0.2 工程、BOM和制板文件已统一导出，电路、几何、加工图层及版本文字的一致性检查通过。** PCB原生DRC返回 `[]` / `true`；原理图为0项致命问题、0项电气错误，保留1组涉及8个排针的供应商属性警告。实际Gerber的铜连接、钻孔及锡膏开窗检查通过，PCB/PDF和原理图预览已复核。文件清单与封包完整性记录见 `manifest.json` 及压缩包根目录的 `release_v02_acceptance.json`。

## 本轮修正与版本使用

| 复核项 | 本轮处理 | 状态与剩余边界 |
|---|---|---|
| H-01：F1 与旧导出不一致 | F1 统一为 Littelfuse 1206L110/16WR、C3761685；F1206；保持电流 1.1 A | 已闭环：最终工程、原理图/PCB、网表和BOM一致；本版制板数据来自同一工程 |
| H-02：旧脚本不能复现最终工程 | 以独立 V0.2 工程为发布入口；新增脚本目录说明，标明历史脚本与一次性补丁 | 已形成使用约定；旧脚本不作为一键生成入口 |
| H-03：JP1 不能断开 UART | 新增 JP2/JP3，分别断开两路 UART；与 JP1 配合用于烧录和受控联调 | 可人工断开信号；自动掉电禁能仍未实现 |
| H-04：固件不自动启用雷达 | 保持人工确认供电后执行 `radar on` | 延期功能：脱机启用、断电恢复自动监测与供电检测 |
| H-05：U1 采购属性误写 QFN | U1 改为 Seeed XIAO ESP32C3 插座装配，清除旧 C19189385 料号；只保留 14 个通孔 | 已修正实例属性及封装；实际模块修订、排母配合与插拔空间仍待到货验证 |
| 雷达电源去耦 | J2 附近增加 C4=10 µF、C5=100 nF，接 5V_SYS/GND | 已加入设计；PWM干扰、压降和雷达端瞬态尚未实测 |
| 通孔落线与布线 | 走线连接到保留的 XIAO 通孔；按新网络重新布线并清理无效微小线段 | 已闭环：PCB原生DRC与最终Gerber实铜检查均通过，无开路或短路 |

本目录为 V0.2 交付入口，对应独立本地工程 **眠光 睡眠雷达夜灯 V0.2**。`hardware/native/`、`hardware/BOM_V01.*` 和旧报告中的 V0.1 导出属于历史快照，不能混入本轮采购或制板。早期建图、重排和布局脚本的适用范围见 `hardware/scripts/README.md`；重新打开、复核和后续修改以最终工程包为准。

| 项目 | V0.2 当前设计统计 |
|---|---|
| 载板 | 66 × 56 mm，双面布线 |
| 原理图/PCB元件 | 23 个元件；18 个电气网络 |
| 元件物理焊盘 | 63 个：29 个表贴焊盘、34 个镀铜通孔焊盘 |
| 过孔 | 4 个；与元件通孔分开计数 |
| 安装孔 | 4 个直径 2.7 mm 的不镀铜孔；不计入元件焊盘 |
| XIAO插座 | 14 个镀铜通孔；孔径约 1.1 mm、焊盘约 1.8 mm，1号脚方形标记 |

焊盘数是物理铜焊盘数量，不能当作元件数量；最终钻孔文件分别包含元件通孔、过孔和安装孔。

## 统一交付文件

以下文件组成V0.2交付内容。`manifest.json` 记录 `release_v02/` 中全部有效载荷文件的相对路径、字节数与SHA-256，不记录清单自身。验收报告 `release_v02_acceptance.json` 位于压缩包根目录，与 `release_v02/` 并列，记录所验清单的SHA-256；报告不纳入清单，以避免相互引用形成哈希循环。

| 文件 | 用途 |
|---|---|
| `Mianguang_V0.2.epro2` | 完整嘉立创EDA工程，优先用于重新打开和后续修改 |
| `Mianguang_V0.2.epcb`、`Mianguang_V0.2.esch` | 同版PCB与原理图源快照；关联库以完整工程包为准 |
| `BOM_Mianguang_V0.2.csv`、`BOM_Mianguang_V0.2.xlsx` | 同版载板元件清单；CSV为标准逗号分隔文件 |
| `PickPlace_Mianguang_V0.2.csv` | 元件坐标；装配前结合顶底层、旋转和手插件确认，不视作自动贴装批准 |
| `Gerber_Mianguang_V0.2.zip` | 制板图层、板框及镀铜/不镀铜钻孔文件 |
| `Schematic_V0.2.png`、`PCB_Review_V0.2.pdf` | 原理图和PCB查看文件 |
| `schematic_netlist.json`、`pcb_netlist.json` | 原理图与PCB网络连接快照，用于同版交叉核对 |
| `native_checks.json` | 原生检查结果，包括保留提示及检查范围 |
| `manifest.json` | 本目录有效载荷文件清单与SHA-256，用于确认版本和完整性 |
| `../release_v02_acceptance.json` | 压缩包根目录的最终验收报告；绑定上述清单的SHA-256 |
| `README_交付与装配.md` | 本说明：接线、跳线操作、装配和验证边界 |
| `外接件与装配BOM.csv` | 整机所需外接件与装配附件，补充工程BOM |

工程 BOM 是载板元件清单，不等于整机采购清单。随附 `外接件与装配BOM.csv` 列出雷达、插座、公针、跳线帽、灯板、线束和结构件。U1 模块若已经列在工程 BOM 中，只采购一次；两条排母和两条公针需要另计。贴片生产时，U1 按手工插装模块处理，不应把它当作 QFN 芯片或底部贴焊模块。

## 制板下单与装配工艺

本轮小批样板建议采用 **FR-4、2层、1.6 mm板厚、1 oz铜厚、绿色阻焊、白色丝印、无铅喷锡**。这些是下单工艺建议，须由板厂确认与其工艺能力及报价选项匹配；Gerber不编码全部材料、板厚、铜厚和表面处理参数，应在下单界面逐项填写。通孔器件、排针和XIAO插座采用手工装配；XIAO模块在排母焊接检查完成后插入。

**钻孔文件不得重复计数。** 原生Gerber包保留 `Drill_PTH_Through_Via.DRL`，其中4个过孔是主文件 `Drill_PTH_Through.DRL` 的精确子集，只作为过孔分类附表。加工主孔文件为：

- `Drill_PTH_Through.DRL`：38个镀铜孔，包含34个元件通孔和4个过孔。
- `Drill_NPTH_Through.DRL`：4个不镀铜安装孔。

以上合计 **42个独立孔**。不要将过孔分类附表再次叠加到主PTH文件后重复钻孔；交给板厂时一并说明这两个主孔文件和附表关系。原生文件保持原样以便追溯，验收统计按孔中心、孔径和镀铜属性去重并逐孔匹配。

## 机械和装配约定

载板左下角为板框坐标原点，四个安装孔中心为 (5,5)、(61,5)、(5,51)、(61,51) mm，孔中心距为 56 × 46 mm。四孔用于固定载板；C1001 是通过线束连接并独立固定的 22 × 22 mm 模块，其固定孔不与载板四孔共用。

U1 双排孔中心间距为 15.24 mm、同排针距 2.54 mm。XIAO 先焊两条 1×7 公针，载板焊两条匹配排母，再插入模块。U1 的 1 号脚和 USB-C 朝向按最终装配图确认；两排不能错位或旋转 180°。载板焊孔约 1.1 mm、铜焊盘约 1.8 mm。现有排母候选 C124418 的标称高度为 8.5 mm，公针候选为 C492406，二者来自已有库检索，仍须核对实际引脚尺寸、配对插入深度和 USB 插头空间后再冻结采购。

U1 插座装配不使用模块底部附加焊盘，也不使用模块边缘 SMD 焊盘；接地由 U1.13 完成。装配后检查模块底部与载板铜线、器件的间隙。XIAO 随附外置天线需要按模块说明安装并留出馈线空间；不把天线或线束放在 C1001 正前方。[XIAO 官方说明](https://wiki.seeedstudio.com/XIAO_ESP32C3_Getting_Started/)

现有 Blender 文件是白色机身、桌面支座和壁挂背板的概念结构。载板尺寸约定保持一致，但排母高度、USB 插头、线束和螺钉柱的实物装配尚待核对。3D 模型中主板占位孔径是 2.8 mm，PCB 实际加工孔径是 2.7 mm；两者不能作为互换的加工图。桌面和壁挂均需重新确认雷达朝向、胸部距离与实际有效数据；官方睡眠模式安装建议向下倾斜 30–45°，视场为 40° × 40°。[C1001 安装说明](https://wiki.dfrobot.com/sen0623/docs/21502)

## 接口与线束

下表均为载板端针号；最终焊接前以板上 1 号脚标记和导通测量确认线束另一端，不能仅按线色判断。

| 接口 | 载板针序 | 装配要求 |
|---|---|---|
| J1 外部供电 | 1=5V_IN，2=GND | J1 是两针接口，不是 USB-C 插座；外接受电小板输出固定 5 V |
| J2 C1001 | 1=5V_SYS，2=GND，3=模块 RX，4=模块 TX | 3 接 C1001 RX，4 接 C1001 TX；IO1/IO2 本版不接；共地 |
| J3 夜灯 | 1=5V_SYS，2=LED_LOW | 5 V、自带限流暖白灯板，功率不超过 0.5 W；不得接裸 LED |
| J4 按键 | 1=BUTTON_N，2=GND | 常开瞬时按键，按下接地；不外加电源 |
| J5 选装光感 | 1=3V3，2=GND，3=SDA，4=SCL | BH1750 地址 0x23，ADDR 接低；上拉只接 3.3 V，子板自带上拉 |

UART 路径为 `U1.7 → R4 → JP2 → J2.3` 与 `J2.4 → JP3 → R5 → U1.8`；R4/R5 均为 100 Ω。JP1 串在 `5V_ISO → 5V_MCU` 支路。JP2/JP3 只是信号线物理断开，接口仍共地，不是隔离式通信，也没有自动掉电禁能功能。

## 供电与跳线状态

**所有跳线只在两路电源都断开后切换。** 先按下表设置跳线和接线，再上电。USB 指 XIAO 自带的 USB-C 调试口；“外部 5 V”指 J1 输入。

| 用途 | JP1 | JP2、JP3 | 电源及启用流程 |
|---|---|---|---|
| USB 烧录 | 拔下 | 全部拔下 | 外部 5 V 断开，仅接 XIAO USB；雷达信号和外供电支路均断开 |
| USB 日志／受控联调 | 拔下 | 全部装上 | USB 与外部 5 V 均稳定后，确认雷达实际有电，再执行 `radar on` |
| 单外部 5 V 运行 | 装上 | 全部装上 | USB 不接；当前固件上电仍等待人工启用，不保证脱机自动开始监测 |

联调结束先执行 `radar off`，再断电；改变跳线状态前确认 USB 和外部 5 V 均已断开。双电源联调中突然掉电、复位/ROM 阶段的 UART 状态仍未完成实物验证，不能把本操作流程解释为自动掉电保护。

固件上电将 UART 设为高阻，确认雷达已供电后执行 `radar on`；该命令只启用通信，不能接通雷达电源。确认位置、角度和单人场景后执行 `install yes`；BH1750 和整机光学阈值已检查后执行 `ambient yes`。这些确认不跨重启保存。现有按键短按切灯、长按切亮度或恢复自动，并不启用雷达。需要独立运行和断电恢复自动监测时，仍须另行实现并验证供电检测与自动启动。

## 首次上板验证顺序

1. 不插 U1、不开灯，检查 5V_IN、5V_SYS、5V_ISO、5V_MCU、3V3 对地是否存在异常低阻，核对 D1/D2 极性、Q1 管脚及各线束针序。
2. 按 USB 烧录状态设置跳线，插装 XIAO 后烧录；核对串口日志、按键与灯控制命令。固件编译记录不能代替烧录结果。
3. 断电后改为受控联调状态，接雷达并测量 J2 实际 5 V 和 UART 电平；两路供电稳定后启用雷达，记录查询响应、错误计数和字段有效状态。
4. 接入规定的限流灯板，测试全亮、低亮、PWM 转换时的电源压降、温升和雷达数据质量；再验证光感缺失、遮挡和自身夜灯串光。
5. 分别完成桌面与壁挂安装、翻身/离床、遮挡、断连恢复和整夜记录。呼吸/心率仅输出模组标称量程内的有效趋势，不据此生成临床睡眠分期、呼吸暂停诊断或急救报警。

F1 的 1.1 A 是保持电流标称值，不是精密限流值；还需验证温度、峰值电流和故障保护配合。D2 的 TVS 不能替代稳压或持续过压切断。载板的电气检查、制板文件检查和实物功能验证各自单独记录。

## 检查记录与保留提示

| 检查对象 | 最终文件检查结果 |
|---|---|
| 嘉立创EDA PCB DRC | 错误列表 `[]`，通过状态 `true` |
| 原理图检查 | 0项致命问题、0项电气错误；1组供应商属性警告，涉及8个排针。原生汇总 `passed=false`，原因是该警告组保留 |
| 工程、源文件、BOM和网表 | 23个元件及核心网络一致；F1、U1装配形式、元件采购属性和V0.2版本文字已交叉核对 |
| Gerber板框 | 闭合66 × 56 mm矩形，与PCB源一致 |
| Gerber实际铜连接 | 对63个物理焊盘、61个铜连通区域及镀铜孔壁联合检查；无漏铜焊盘、开路或短路 |
| 钻孔 | 42个独立孔与源文件的坐标、孔径和镀铜属性逐一匹配：34个元件通孔、4个过孔、4个2.7 mm不镀铜安装孔；其中U1为14个镀铜通孔 |
| 表贴锡膏开窗 | 29个表贴焊盘均有完整开窗，最低焊盘面积覆盖率99.9995%；该值为导出几何计算结果 |
| 通孔与锡膏边界 | 所有通孔焊盘均无锡膏覆盖；以焊盘外包区域加0.02 mm计算容差检查，越界面积为0，未归属开窗为0 |
| 预览与保存持久性 | PCB/PDF图层及原理图预览已复核；PCB保存并重开后丝印位置保留，DRC仍为 `[]` / `true`，版本与接线说明一致 |
| 文件清单与封包验收 | `manifest.json` 记录有效载荷哈希；根目录 `release_v02_acceptance.json` 绑定该清单SHA-256并记录完整验收结果 |
| 开发板烧录、实机供电／UART／灯光测试 | 尚未进行，须单独记录实物结果 |
| 实体外壳装配、桌面／壁挂安装与整夜试用 | 尚未进行，须单独记录装配及场景结果 |

1组 `ATTRMATCHCODE` 警告涉及8个排针，对应 **J1、J2、J3、J4、J5、JP1、JP2、JP3**。它们是供应商属性匹配提示。已按采购资料补充型号与供应商信息，但原库通用排针符号属性仍未得到原生匹配规则确认，故保留提示：J1/J3/J4/JP1/JP2/JP3 为 C124375、Ckmtw B-2100S02P-A110、2针2.54 mm直插；J2/J5 为 C492403、XFCN PZ254V-11-04P、4针2.54 mm直插。当前没有把提示隐藏、降级为通过或据此宣布全部采购属性已获自动确认。[C124375官方采购记录](https://www.lcsc.com/product-detail/C124375.html)、[C492403官方采购记录](https://www.lcsc.com/product-detail/C492403.html)

最终检查记录要区分：电气网络与实铜连通性、加工图层与钻孔、采购元数据、实物测试。自动掉电隔离、雷达脱机自动启动、断电后自动恢复监测和临床有效性均不在本版已实现范围内。外置限流灯板、USB-C受电小板、3.3 V光感上拉和实际线序仍是整机装配条件。

最终交付包的文件身份和验收范围以 `manifest.json` 与根目录 `release_v02_acceptance.json` 为准。上述检查验证设计文件与加工数据，不替代首次上板和整机实测，也不代表整机认证、临床验证或量产放行。
