wonderbench/mianguang/research/datasheets/C1001_sleep_installation.webp

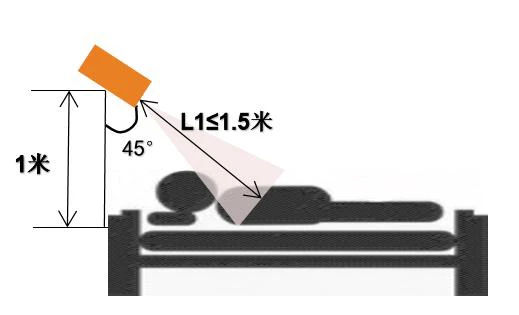
research/datasheets/C1001_sleep_installation.webp
