wonderbench/mianguang/verification/README.md

# 仓库迁移检查

[2026-11-04检查摘要](import_2026-11-04.json)记录文件分类后的路径、校验和与既有测试结果。本次没有修改固件算法、PCB电路或模型几何，也没有重新生成目标板二进制或执行实机烧录。

PCB详细检查见[最终验收报告](../pcb/release_v02_acceptance.json)，固件原始构建证据见[软件验证记录](../firmware/reports/VERIFICATION.md)。
