wonderbench/mianguang/firmware/reports/VERIFICATION.md

# V0.2 软件验证记录

日期：2026-10-28。验证环境：macOS arm64，Clang，C++17，Python 3。本目录所有场景回放均为构造数据，**没有雷达实测数据**。

| 层次 | 结果 | 可复核记录 |
|---|---|---|
| 协议、查询客户端、质量/趋势/夜灯、用户输入、贯通回放 | 6 个测试程序通过，严格编译告警、地址及未定义行为检查通过 | `native_tests.txt` |
| 实际 Arduino 主循环与硬件接口替身 | 通过；读取实际 `src/main.cpp`，验证串口/按键/光传感器耗时和 3 条 JSON | `main_mock_tests.txt` |
| 离线日志统计 | 15 项 Python 单元测试通过 | `python_tests.txt` |
| ESP32C3 目标编译 | 成功；静态RAM 16,852 B，程序 289,732 B，应用镜像 314,432 B | `board_build.txt`、`image_validation.txt` 与发布清单 |
| 开发板烧录、物理串口、测量精度、PWM/温升、整机试验 | 未进行 | 需要样机实测 |

## 已覆盖的故障与边界

- 协议：0–64 字节负载、最大长度、噪声、分片、连续帧、重叠帧头、坏帧尾、坏校验、过长报文、字节超时及回绕。
- 客户端：启动等待、睡眠模式切换/读回、同命令响应匹配、字段长度/枚举、单请求在途、晚包、超时重试、连续故障重新确认模式、关闭/恢复。
- 有效性：字段独立过期、安装未确认、通信故障、冲突占用、体动、无信息、零/255和标称量程。
- 趋势：中位数、启动覆盖率、同报文去重、观测时间归桶、缓存跨桶、缺口退出、25 天无有效数据后的恢复。
- 夜灯：8 小时合成场景、暗/亮/unknown、一次离床事件、3 秒新证据、旧在床报文、手动优先、渐变、延时与 50 天时钟推进。
- 主循环：故障与恢复在同一批输入时仍取消旧离床过程；I²C 耗时后重新校验数据年龄；日志分段输出及最大值仍是完整 JSON。
- 日志：重复、乱序/重启分段、缺口不补齐、左端有效时间积分、RR/HR 独立观测去重、同键冲突、坏 JSON、NaN/Infinity及重复属性。

长时间场景由逻辑时钟加速推进；并非连续运行了 50 天的物理耐久测试。测试的模拟输入按源码协议构造，无法证明模组实际固件的串口行为与参数完全一致。

## 本轮修复的可复现问题

1. 缓存读数可能从前一秒被计入后一秒：按真实观测时间归桶，避免虚增覆盖率。
2. 仍在新鲜期内的旧在床报文可能重新允许灯事件：拒绝乱序占用证据。
3. 25 天故障后旧去重基准超出时间比较范围：过期基准清理后允许新数据恢复。
4. 读取光传感器后沿用主循环入口时刻：决策前刷新时间并重新检查协议/数据期限，避免使用刚过期的离床证据。移除修复的负控能触发模拟测试失败。
5. ESP32C3 工具链中的 `uint32_t` 与本机底层类型不同，导致模板类型推导失败：显式使用固定宽度类型，目标编译及本机回归均通过。

固定构建版本：PlatformIO Core 6.1.18、Espressif32 6.12.0、Arduino 包 `3.20017.241212+sha.dcc1105b`（Arduino ESP32 2.0.17）、RISC-V GCC 8.4.0 / 2021r2-patch5、esptool 4.9.0。镜像的校验和与验证哈希均通过。完整镜像只在本地生成，没有调用设备烧录命令。

## 样机验证入口

使用 [固件说明](../README.md) 的接线、供电确认和命令顺序；把实际模块固件标识、安装几何、原始 UART 抓包、照度阈值和参考设备记录作为同一试验包保存。只有取得这些证据后，才评估实机准确度、漏测与误触发。当前版本不生成医学诊断、睡眠呼吸暂停报警或临床睡眠分期。
