wonderbench/mianguang/pcb/qa/v03/mounting_and_clearance_review.md

# PCB V0.3 PRECHECK04：安装孔与装配间隙处置复核

日期：2026-11-05。只读复核 `pcb/preflight_v03/Mianguang_V0.3_DFM_PRECHECK_04.zip`、`pcb/release_v03_precheck04/`、`models/v0.2/` 的 STL 与构建脚本。**未修改 EDA、Gerber、STL 或任何带清单哈希的文件；不构成制造放行，也不关闭 [LATEST.json](../../LATEST.json) 中的开放项。** 下文涉及外壳的补充说明优先于 [assembly_v02.md](../../../models/mechanical/assembly_v02.md) 中未写明的部分；该文件受 `models/v0.2/manifest.json` 哈希约束，本次未改。

## 结论

| 项目 | 判断 | 需要的动作 |
|---|---|---|
| `Pth无Pad` 8 条（NPTH 文件） | **可接受，不改设计** | 下单时请 CAM 确认一句（见“下单确认”） |
| 插件到贴片焊盘间距 8 条（最小 2.32 mm） | **可接受，不改设计** | 下单写明先回流、后手工焊通孔 |
| 报告工艺为有铅喷锡 | **必须修正，但不改文件** | 选无铅喷锡后重跑并归档 DFM |
| M3 螺钉头与 JP2/J2 焊脚（名义 0.4 mm） | **不可忽略，低成本可控** | 按下文指定螺钉头并修剪焊脚；结构修正另行跟踪 |
| 8 个螺钉柱孔贯穿后壳 | **与装配说明不符** | 首轮试装可接受；下一版外壳修正或写明用意 |
| J2 插壳与 JP2 跳帽（名义 0.26 mm） | **真实风险** | 只用窄体插壳，首件试配 |
| Ø2.7 孔配 M2.5 螺钉 | **偏紧，不必为此改板** | 打印试片；不顺时可手工扩孔；若改板顺带改孔径 |

## 1. `Pth无Pad` 8 条

本次独立解析 04 上传包，确认 `Drill_NPTH_Through.DRL` 首行为 `;TYPE=NON_PLATED`，四孔 Ø2.70000 mm，中心 (5,5)、(61,5)、(5,51)、(61,51) mm；板框层只有矩形外框。独立测得孔边到顶、底层铜的最小距离为 7.349 mm，与[专项复核](online_dfm/PRECHECK_03_npth_review.md)的 7.348618 mm 一致。四孔逐层的最小距离（9.781、9.301、7.349、10.839/13.164 mm）均与专项复核一致。

**最坏情况的后果很小：** 即使 CAM 把四孔当作镀铜孔，它们也没有网络、距铜 7 mm 以上，电气上仍然孤立，只是孔壁增加一层镀铜。M2.5 螺钉仍可通过。因此这 8 条不值得为消警改设计，**不要补铜盘、删孔或关闭检查**。

仍需问一句的原因：嘉立创[工艺能力页](https://jlcpcb.com/capabilities/pcb-capabilities)建议把 NPTH 画在机械层或禁布层，而本设计只通过 NPTH 钻孔文件表达。该页也没有给出“无焊盘孔”的规则或圆形 NPTH 的孔径公差，“4 孔 × 2 层 = 8 条”仍是推断。

## 2. 插件到贴片间距 8 条

既有复核把这项作为手工焊接空间待确认。补充一个关键事实：**23 个元件全部位于顶面（坐标文件 Layer 均为 T），29 个贴片焊盘全在顶面。** 34 个通孔的焊点都在背面操作，烙铁头并不进入顶面的 2.32 mm 间隙，背面也没有需要避让的贴片件。

按封装图形估算，插件塑壳到相邻贴片也有约 2.3 mm（U1 右排到 R1、J2 到 C5、J4 到 R3），不妨碍插装。因此无需移动 R1、R3、C5、R5，不值得为此重新走线和复检。

## 3. 表面工艺

04 报告仍为有铅喷锡，而目标是无铅喷锡。这不是文件问题，只需改下单选项，但现有报告不能证明无铅条件下的结果。改选后重跑一次并归档。

## 4. M3 螺钉头（[assembly_v02.md](../../../models/mechanical/assembly_v02.md) 补充）

装配说明只写“M3×10”，但 0.4 mm 余量依赖模型中的 Ø5.6 × 1.6 mm 头部（`build_enclosure_v02.py:180`）。承压面 Y=18，PCB 背面 Y=13，焊脚预算至 Y=16。

| 螺钉头 | 头高 k/mm | 头部前表面 Y | 距 PCB 背面/mm | 相对焊脚预算/mm |
|---|---:|---:|---:|---:|
| 内六角圆头 ISO 7380（k 最大 1.65） | 1.65 | 16.35 | 3.35 | +0.35 |
| 普通盘头（常见值，以实物为准） | 约 2.4 | 15.6 | 2.6 | −0.4 |
| 内六角圆柱头（常见值，以实物为准） | 约 3.0 | 15.0 | 2.0 | −1.0 |

位置关系：右侧螺钉在 PCB 坐标 (49,34)，左侧在 (17,34)。左侧最近通孔 6.88 mm，无风险。右侧投影内外的针脚为：

| 针脚 | 网络 | 到螺钉中心/mm | 说明 |
|---|---|---:|---|
| JP2.2 | RADAR_RX | 2.02 | 针脚在头部投影内 |
| JP2.1 | UART_TX_LINK | 3.03 | 针脚在投影外，焊盘有重叠 |
| J2.1 | 5V_SYS | 3.34 | 针脚在投影外，焊盘有重叠 |

金属头部本身不接任何网络，只有焊脚同时接触才会桥接：JP2 两脚相连会使拔下 JP2 后的 UART 断开失效，J2.1 与 JP2.2 相连则会把 5 V 加到雷达 RX。按排针常见 3 mm 尾长估算，插入 1.6 mm 板后露出约 1.4 mm，加焊料约 1.5–2 mm，正常修剪后不会接触，**概率低但后果重**。另外，`mount_notes.md` 称该净距由主壳检查文件复核，但 `geometry_checks.json` 没有焊脚或该螺钉头的检查项，此余量至今只是手算。

**装配要求：**

1. 两颗 M3×10 使用 ISO 7380 内六角圆头（或实测头高不大于 1.65 mm 的螺钉），不用普通盘头或圆柱头。
2. 焊后修剪 JP2 和 J2 焊脚，含焊料不超过板背 2.0 mm，并实测记录。
3. 在右侧螺钉头表面贴一层聚酰亚胺胶带，覆盖整个头部。
4. 合板前用万用表确认 J2.1、JP2.1、JP2.2 两两不通（JP2 跳帽拔下时）。

## 5. 螺钉柱孔贯穿后壳

`SR02_01_Rear_Tub.stl` 的后外表面（Y=22）在全部 8 个柱位都有 r=1.35 mm 的孔圈：PCB 四柱 (X=±28, Z=61/107)，前盖四柱 (X=±42, Z=39) 与 (X=±39, Z=137)。来源是 `build_enclosure_v02.py:169,175` 的 Ø2.7 通孔，在[后视图](../../../models/v0.2/renders/02_rear.png)中可见。

而装配说明要求螺钉“不能顶底或穿出外壳”，也没有提到这些孔。首轮试装没有功能影响，贯通孔还能避免螺钉顶底，但卧室产品有进尘、进虫和外观问题。应在下一版外壳中改为盲孔，或明确写明用途。修改需在 Blender 中重建并重新生成几何检查和发布包。

## 6. J2 与 JP2

按封装，J2 塑壳左缘 X=50.92、JP2 右缘 X=50.54，排针之间仅 0.38 mm；10.4 mm 宽的插壳再减至 0.26 mm。此项已有几何检查，但只针对模型包络。带锁插壳通常更宽，不能假定可用。

采购雷达线束时**只选实测宽度不大于 10.4 mm 的窄体无锁插壳**，并连同实际跳线帽试配。顶层走线 X=47.96 穿过 JP2 两脚之间，因此把 JP2/JP3 左移不是单纯移动器件，需要重新走线，只在另有改板理由时才值得做。

## 7. Ø2.7 孔与 M2.5 螺钉

2.7 mm 配 M2.5 只有 0.2 mm 直径余量，即每孔约 ±0.1 mm，且要同时容纳板厂孔位误差和打印件误差。仅 0.3% 的打印收缩，在 56 mm 孔距上就有约 0.17 mm，再加上热熔嵌件的偏斜，余量可能被用尽。

建议先按 56 × 46 mm 打印带嵌件的试片，用裸板或同孔距样板试装。若个别孔不顺，这四个孔距铜 7 mm 以上，可手工扩至 Ø3.0 mm。若因其他原因改板，可把孔径改为 Ø3.0 mm 且不动中心；需同步修改 `pcb/qa/check_release.py:555` 的期望值和外壳模型孔径。

## 下单确认

可直接用于下单备注或询问 CAM：

> 四个 Ø2.70 mm 孔（中心 (5,5)、(61,5)、(5,51)、(61,51) mm，文件 `Drill_NPTH_Through.DRL`）是不镀铜机械安装孔，按设计不带焊盘和铜环。请确认按 NPTH 加工；DFM 的 8 条“Pth无Pad”与这四孔相关，请确认可接受。装配顺序为 14 件贴片先回流，9 件通孔和模块后手工焊接，不过波峰焊；请确认 8 条插件到贴片间距提示可接受，以及是否需要工艺边或定位点。

下单选项：FR-4、2 层、1.6 mm、1 oz、绿色阻焊、白色丝印、**无铅喷锡**。选好后重跑 PCB 和 SMT 分析，归档报告，核对 14 个位号的选料、封装和方向（特别是 D1、D2、Q1）。

收到回复并归档后，再更新 `LATEST.json` 的 `open_conditions`。

## 方法与边界

Gerber 与钻孔由本次临时脚本直接解析，未使用仓库检查器；STL 按二进制顶点解析。螺钉头尺寸中，ISO 7380 已查到公开数据，盘头和圆柱头为常见值，尾长和焊料高度为估算，都需要按实物确认。本复核是文件级分析，不代替首件焊接、试装、电气或射频测试。
