wonderbench/mianguang/pcb/qa/v03/online_dfm/PRECHECK_04_review.md

# PRECHECK04 在线 PCB / SMT DFM 报告复核

用户上传的[原始 PDF](PRECHECK_04_report.pdf)已按原字节归档，报告显示时间为 **2026-11-05 21:23:52（Asia/Shanghai）**。完整单页报告已经两次独立目视核对；PCB DFM 与 SMT DFM 均勾选，并分别具有实际分析章节。

**PCB 为 0 个危险、16 个警告；SMT 为 0 个危险、0 个警告。D1 本体丝印警告已在本次报告中关闭。** 相比[03 第二份报告](PRECHECK_03_2_review.md)，合计警告由 17 降至 16，没有新增警告。本次继续使用已冻结的 04 工程、BOM、坐标及 Gerber，无须据此重新修改或导出 PCB。

## 与上一份报告的对照

| 范围与项目 | 03 第二份危险 / 警告 | 04 危险 / 警告 | 04 报告内容 | 处置 |
|---|---:|---:|---|---|
| PCB：插件焊盘距贴片焊盘 | 0 / 8 | 0 / 8 | 2.32 mm，良好 28；顶铜层 | 仍需装配方接受先回流、后手工插装的工艺 |
| PCB：Pth无Pad | 0 / 8 | 0 / 8 | `null`，良好 0；`Drill_NPTH_Through.DRL` | 仍需 DFM/CAM 确认机械孔分类和处置 |
| SMT：元件本体文字预警 | 0 / 1 | **0 / 0** | “无”，危险 / 警告 / 良好均 0 | **原 D1 警告关闭** |
| 合计 | 0 / 17 | **0 / 16** | PCB 16、SMT 0 | 工艺确认尚未完成，未制造放行 |

合计是完整 PDF 逐行求和；表中已列出所有非零危险 / 警告类别。其余检查条目均为 0 危险、0 警告。焊盘孔环显示 0.18 mm、良好 8；三项 PCB 丝印检查均为“无 / 0 / 0 / 0”，没有提供新的数值最小值。SMT 元件距元件为 1.98 mm、良好 15；该计数不等于已证明完整导入 14 个预期 SMT 位号。

## D1 修正已经得到在线复检支持

04 删除了 D1 本体中央的二极管图形，将阴极竖线移到本体外左侧，保留外部 D1 位号及上下轮廓。既有[源与导出差异复核](../precheck04/electrical_delta_review.md)和[D1 标记几何复核](../precheck04/d1_marker_review.md)证明改动仅涉及该顶层丝印，器件坐标、焊盘、钻孔和电气连接保持不变。

本次 SMT “元件本体文字预警”明确为 0，足以关闭先前 D1 的该项报告警告。它不替代选料、极性、全部位号匹配或实际焊接验收。既有本地独立验收 **49/49 PASS**、制造检查 **40/40 PASS** 仍对应同一冻结源；本轮没有改设计，也未重新生成这些历史检查结果。

## 制造前仍需取得的确认

| 待确认事项 | 当前证据与需要的回复 |
|---|---|
| 四个安装孔的 NPTH 属性 | 保持 Ø2.7 mm，中心为 (5,5)、(61,5)、(5,51)、(61,51) mm；钻孔文件明确 `NON_PLATED`。请 DFM/CAM 确认四孔不镀铜，并对 NPTH 文件触发的 8 条 `Pth无Pad` 给出处置。不要增加铜盘、删孔或关闭整个检查来消警。 |
| 8 条插件至贴片间距警告 | 按 **14 件 SMT 先回流，9 件通孔 / 模块后手工装配**；请装配方确认可执行该工艺及工艺边 / 定位点要求。最小 2.32 mm 是实际间距，不能仅以 SMT 零警告宣称这些提示已豁免。 |
| 表面工艺一致性 | 本报告仍为“**有铅喷锡、绿色、白色**”，项目目标为“**无铅喷锡、绿色、白色**”。需在分析设置和最终加工要求中统一并保存确认；当前报告没有证明无铅条件下的工艺接受。 |
| 正式贴装匹配 | 核对全部 14 个位号及料号、封装和引脚方向，特别是 D1、D2、Q1；D2 实物阴极色带仍需供方资料或实物确认。保存选料和方向预览，不能仅凭旋转角或“良好 15”判定完成。 |

机械孔的[既有专项复核](PRECHECK_03_npth_review.md)表明四个 NPTH 孔在上下铜层均无铜重叠、最近孔边到铜为 7.348618 mm，38 个 PTH 在两层都有正铜环。03→04 电气 / 制造几何不变，因此证据仍适用。四孔乘两层与 8 条警告数量相符只是解释性推断，平台分类及 CAM 接受尚未获得确认。

手工装配间距的八对焊盘见[既有逐点分析](PRECHECK_02_independent_review.md)。SMT 核对使用同版 [BOM](../../../preflight_v03/smt_precheck04/BOM_SMT_Mianguang_V0.3.csv)、[坐标](../../../preflight_v03/smt_precheck04/CPL_SMT_Mianguang_V0.3.csv)、[手工项](../../../preflight_v03/smt_precheck04/manual_assembly.csv)及[极性表](../precheck04/smt_polarity_reference.md)。这些文件无需因本次报告重新生成。

## 报告身份及归档边界

- 内部文件名：`Mianguang_V0.3_DFM_PRECHECK_04`；2 层，66 × 56 mm。
- PDF：1 页，4,762,485 字节；SHA-256 `7515256d264090277eda905bf22e0db700d14e062ea99e92811acb70e21ae9ca`，与用户原文件逐字节一致。
- PDF 元数据创建时间为 21:23:53；索引采用报告正文显示的 21:23:52。
- 关联 [04 上传 Gerber](../../../preflight_v03/Mianguang_V0.3_DFM_PRECHECK_04.zip) 的 SHA-256：`915296951145847c9b6e229feffacc6bc4edb3c42af815d3ca696ad4964370c0`。
- 结构化记录：[PRECHECK_04_summary.json](PRECHECK_04_summary.json)；当前交付状态：[LATEST.json](../../../LATEST.json)。

关联依据为用户提交、报告内文件名、尺寸及板图。PDF 不含输入 ZIP、BOM、CPL 的哈希，也没有逐位号的完整选料 / 方向清单，不能声称报告自身证明了全部输入一致性。冻结 04 工程和完整交付 ZIP 均形成于收到本报告之前，继续保持原字节；其中“待复检”是导出时状态。本 PDF、复核及最新索引作为仓库补充记录，**未加入或覆盖既有完整 ZIP**。

当前结论为：D1 问题已关闭，在线 SMT 零危险零警告，PCB 剩余 16 条工艺 / 孔分类警告待处置；尚未制造放行，也未完成首件电气、温升、射频及实物装配验证。
