wonderbench/mianguang/pcb/qa/v03/online_dfm/PRECHECK_03_2_review.md

# PRECHECK03 第二份在线 DFM 报告复核

用户第二次上传的[原始 PDF](PRECHECK_03_2_report.pdf)已逐字节归档，报告显示时间为 **2026-11-05 20:56:16（Asia/Shanghai）**。报告内部文件名仍为 `Mianguang_V0.3_DFM_PRECHECK_03`；归档文件名中的 `_2` 用于区别首次报告，不表示 PCB 版本变化。[首次报告](PRECHECK_03_report.pdf)和[首次复核](PRECHECK_03_review.md)完整保留。

**本报告合计 0 个危险、17 个警告：PCB 为 0 / 16，SMT 为 0 / 1。** PCB DFM 和 SMT DFM 均已勾选，且存在带实际结果的“SMT DFM > 元件组装分析”章节。与首次报告相比，PCB 的两类警告及数量未变；本次新增的 SMT 检查发现 D1 本体中央的一处文字预警。不能写成全部无警告通过或制造放行。

## 全部非零危险与警告

| 范围 | 检查项 | 危险 | 警告 | 良好 | 报告结果与定位 |
|---|---|---:|---:|---:|---|
| PCB | 插件焊盘距贴片焊盘 | 0 | 8 | 28 | 2.32 mm；`Gerber_TopLayer.GTL`；与首次 03 相同 |
| PCB | Pth无Pad | 0 | 8 | 0 | 结果 `null`；`Drill_NPTH_Through.DRL`；与首次 03 相同 |
| SMT | 元件本体文字预警 | 0 | 1 | 0 | 结果 `null`；`component_+_top`；截图指向 D1 本体中央 |

合计来自完整单页 PDF 各行的逐项目视求和，不是 PDF 另行颁发的总体通过结论。其余所有分析条目的危险、警告均为 0。焊盘孔环显示 0.18 mm、良好 8；丝印距焊盘、丝印距孔、丝印线条宽度均为“无 / 危险 0 / 警告 0 / 良好 0”。这些丝印条目没有给出新的数值最小值，不应借用本地测量值冒充在线报告读数。

## D1 本体中央警告与 04 候选修正

SMT 警告截图的青色框位于 D1 器件本体中央，框中可见二极管图形与小字叠影；上方外部 `D1` 位号在框外，左右焊盘也不在框内。因此该截图不支持“仅需移动 D1 外部位号”的判断。PDF 的图像分辨率不足以可靠读出框中具体字符串或确定源图元 ID，应对照源封装中央图形/文字处理。

本体中央丝印需要在拟定的 **PRECHECK_04 候选**中修正，并保持明确的阴极方向标识。修正后应重新导出、运行本地检查并重跑在线 PCB 与 SMT DFM。本次归档没有修改任何 PCB、封装、BOM、坐标或 Gerber，也不声称该警告已经关闭。

## 仍未闭环的三项工艺条件

1. **NPTH 识别及 CAM 结论。** “Pth无Pad”仍明确指向非金属孔文件。既有[NPTH 专项证据](PRECHECK_03_npth_review.md)记录了四个机械孔及源文件非镀铜意图；四孔乘两铜层与 8 条警告数量相符，但 PDF 没有逐点清单或分类日志，不能直接宣布全部误报或已豁免。仍需 DFM/CAM 核实孔属性并记录处置结论，不得为消警而给机械孔加铜、删孔或关闭整个检查。
2. **后续手工插装的工艺接受。** 8 条插件焊盘至贴片焊盘间距警告仍保留。计划工艺为 14 件 SMT 先回流、9 件通孔/模块随后手工装配；贴片/装配方对此条件的接受尚未由报告证明，不能按波峰焊工艺直接放行。具体 8 对焊盘见[02 几何分析](PRECHECK_02_independent_review.md)。
3. **喷锡工艺一致性。** 报告仍为“有铅喷锡、绿色、白色”，项目目标为“无铅喷锡、绿色、白色”。实际检测设置与最终加工要求仍需一致化确认，本报告不构成无铅喷锡条件下的最终工艺确认。

## SMT 已执行与尚未证明的范围

本次可以确认 **SMT DFM 已执行**：首页勾选 SMT DFM，后部有完整的元件组装分析章节和结果；“元件距元件”为 1.98 mm、良好 15，D1 本体文字预警为警告 1。其余 SMT 分析条目危险、警告均为 0。

该 PDF 没有逐一列出全部预期 14 个 SMT 位号、选料料号、BOM/CPL 哈希、各器件角度或逐项极性确认。“良好 15”是该项的结果计数，不能据此证明 14 个位号完整覆盖。正式选料、全部 14 位号的导入与匹配、封装/方向/极性仍需与[SMT BOM](../../../preflight_v03/smt_precheck03/BOM_SMT_Mianguang_V0.3.csv)、[SMT 坐标](../../../preflight_v03/smt_precheck03/CPL_SMT_Mianguang_V0.3.csv)及[极性表](../precheck03/smt_polarity_reference.md)逐项确认；本报告不替代这些确认，也不构成实物或制造验收。

## 报告身份与范围

- 板参数：2 层，66 × 56 mm；与首次 03 相同。
- 第二份 PDF：4,816,409 字节，1 页；SHA-256 `ea74515b35dcdc8e53dbcbce50c5f0469a792dcea27879627973c660e80364fe`。
- 首次 PDF SHA-256：`d3689c3b8a3cae97806bd7f69210ab852bbf2b0d308eebeef730b48e138e13e3`；其报告时间为 20:48:56，仅勾选 PCB DFM，合计 0 个危险、16 个警告。
- 关联的 03 上传 Gerber SHA-256：`8e786b7bfa3eb609b283f079b3bb2ccddcab58149d3979a5f0926bc297206811`。
- 结构化汇总：[PRECHECK_03_2_summary.json](PRECHECK_03_2_summary.json)。

关联依据为用户提交、报告内部文件名、尺寸及板图。PDF 不含源 ZIP 或 BOM/CPL 哈希，因此不声称它与这些输入存在报告内的密码学绑定。本次仅新增原始 PDF、结构化汇总和本文三个归档文件，首次报告及冻结 PRECHECK_03 交付保持不变。04 候选仍待修正和复测，当前尚未制造放行。
