wonderbench/mianguang/pcb/qa/v03/online_dfm/PRECHECK_03_review.md

# PRECHECK03 在线DFM报告复核

报告时间：2026-11-05 20:48:56（Asia/Shanghai）。输入为用户上传的[原始PDF](PRECHECK_03_report.pdf)，已逐字节归档并完整目视检查。PDF仅勾选PCB DFM，SMT DFM未勾选。板尺寸66 × 56 mm、2层，与03候选相符。

**结论：报告所列危险项合计0、警告合计16。此前孔环及丝印报警已不再出现；尚有两类警告需要确认，不能写为全部通过或制板放行。** 本轮不改PCB、工程封装、BOM、坐标或Gerber。

## 与02版的逐项比较

| 检查项 | 02版危险 / 警告 | 03版危险 / 警告 | 03报告结果及判断 |
|---|---:|---:|---|
| 焊盘孔环 | 8 / 0 | 0 / 0 | 最小0.18 mm，良好8；旧零孔环报警消失 |
| 丝印距焊盘 | 50 / 0 | 0 / 0 | 显示“无”，未报告异常 |
| 丝印距孔 | 16 / 4 | 0 / 0 | 显示“无”，未报告异常 |
| 丝印线条宽度 | 0 / 49 | 0 / 0 | 显示“无”，未报告异常 |
| 插件焊盘距贴片焊盘 | 0 / 8 | 0 / 8 | 最小2.32 mm，既有工艺提示仍在 |
| Pth无Pad | 0 / 0 | 0 / 8 | 新警告，图层列为Drill_NPTH_Through.DRL，数值栏为null |

合计为对完整报告各条目计数求和，不是PDF另行给出的总体通过章。丝印三项为“无 / 0 / 0 / 0”，不能把本地测量的最小值冒充在线报告读数。

## 新警告：先核对非镀铜孔识别

“Pth无Pad”的描述针对金属化孔缺少对应铜焊盘，但其图层列明确指向非镀铜钻孔文件。冻结03的四个安装孔由原生圆形挖槽导出，孔位为(5,5)、(61,5)、(5,51)、(61,51) mm，直径均2.7 mm；属于机械非镀铜孔，不承担电气导通。

原始`Drill_NPTH_Through.DRL`不仅文件名为NPTH，还含`;TYPE=NON_PLATED`与`;Layer: NPTH_Through`注释；主PTH文件对应标为PLATED。两文件没有XNC的`TF.FileFunction`扩展属性。独立解析可识别这些注释，但不能据此认定在线平台也采用相同规则。具体孔、铜避让和输入身份见[NPTH专项证据](PRECHECK_03_npth_review.md)。

据此推断，新增警告很可能源于平台把这4个机械孔带入PTH缺盘规则。4孔乘两铜层与8项数量相符，但PDF没有完整定位清单或解析日志，不能把该计数机制写成已证实。

下一步应在DFM/CAM中检查这4孔实际识别的属性为NPTH，并保持原孔位和孔径；如可编辑属性，仅核正其孔类型后重跑该项，否则交由板厂CAM核对并记录结论。无需为消除此提示给机械孔增加铜焊盘，也不能删除安装孔或关闭全部PTH检查。嘉立创[属性编辑说明](https://www.jlc.com/portal/server_guide_39122.html)列出了PTH/NPTH属性分类；该文针对软件菜单，不保证在线页面有同样入口。嘉立创EDA[圆形挖槽说明](https://prodocs.lceda.cn/cn/pcb/place-slot-region/index.html)明确小于等于6.5 mm的圆形挖槽输出到NPTH文件，03源表达与此一致。

## 既有8条间距提示与SMT

最小2.32 mm及8项数量与02一致。仍按既定工艺：14件SMT先回流，9件通孔/模块随后手工装配。间距提示未获贴片方确认，本次保留为待确认项；不把它作为波峰焊设计放行。具体8对焊盘见[02几何分析](PRECHECK_02_independent_review.md)。

本报告不含SMT检查。应在同一03版PCB资料上导入[14件SMT BOM](../../../preflight_v03/smt_precheck03/BOM_SMT_Mianguang_V0.3.csv)和[14件SMT坐标](../../../preflight_v03/smt_precheck03/CPL_SMT_Mianguang_V0.3.csv)，完成选料、封装/角度及贴装预览。D1、D2、Q1按[极性表](../precheck03/smt_polarity_reference.md)逐项确认；D2实物色带、工艺边/定位点及后续手工焊接安排仍需确认。

## 工艺与后续状态

03报告仍选择“有铅喷锡、绿色、白色”，项目目标为“无铅喷锡、绿色、白色”。需要核对平台实际工艺选项，使检测及加工要求一致；本报告不能代表无铅喷锡选项下的最终工艺确认。

本次只新增在线报告和结论，冻结工程、14件SMT文件及原始交付ZIP继续保持字节不变。其清单/说明中的“待报告”是导出时历史状态，最新结果以[当前索引](../../../LATEST.json)与本文为准。当前仍未制造放行，也没有新增SMT或实物验证通过记录。

## 输入身份

- PDF SHA-256：`d3689c3b8a3cae97806bd7f69210ab852bbf2b0d308eebeef730b48e138e13e3`。
- 03上传Gerber SHA-256：`8e786b7bfa3eb609b283f079b3bb2ccddcab58149d3979a5f0926bc297206811`。
- 03源清单SHA-256：`b4005dd1d23cf3f2f2d47bcd8de1533c190a3120a7a414f98ee6ad758b45a51f`。
- 结构化汇总：[PRECHECK_03_summary.json](PRECHECK_03_summary.json)。PDF没有上传ZIP的哈希，关联依据为用户提交记录、文件名、尺寸和板图，不能声称PDF本身提供了密码学绑定。
