wonderbench/mianguang/pcb/qa/v03/precheck04/d1_marker_review.md

# PRECHECK04 D1 外置阴极标记复核

结果：**PASS**。只读核对最终完整工程、PCB 源与实际 Gerber，没有操作 EDA 或修改候选。

仅删除封装中央 e7/e9/e10/e11，将 e8 改为阴极左侧竖杠。e14/e17 上下轮廓、焊盘、本体包络、其余图形及属性保持一致。实际 Gerber 中确认只有一条对应竖杠，旧中央符号区域已清空。

- 全局端点：**(33.2, 7.4) → (33.2, 8.6) mm**，即 (1307.086614, 291.338583) → (1307.086614, 338.582677) mil。
- 封装局部端点：(-3.8, -0.6) → (-3.8, 0.6) mm，即 (-149.606299, -23.622047) → (-149.606299, 23.622047) mil。
- 实际描线宽度：**0.2032 mm（8 mil）**，满足 ≥0.20 mm。
- D1 阴极 1 脚在左侧，接 5V_ISO。竖杠位于设计本体外侧，本体到竖杠墨迹净距 **1.598378 mm**。

| 最小墨迹净距 | 实际 Gerber / 原生焊盘结果 |
|---|---:|
| 阻焊开窗 | 0.922670 mm |
| 所有钻孔边缘 | 13.164655 mm |
| 物理焊盘（最近 D1.1） | 0.973462 mm |
| 其余丝印（含位号和轮廓） | 1.635278 mm |

上述间距均高于 0.25 mm，竖杠不越板框。计算包含描线宽度与端帽，几何离散误差界为 0.000125 mm。本体范围来自工程封装第 48 层图形，不代替实物尺寸公差；本记录不声称贴片平台检查已通过。

实际 Gerber SHA-256：`915296951145847c9b6e229feffacc6bc4edb3c42af815d3ca696ad4964370c0`。
完整输入哈希、坐标和逐项结果见 [d1_marker_review.json](d1_marker_review.json)。
