wonderbench/mianguang/pcb/qa/v03/online_dfm/PRECHECK_02_independent_review.md

# 嘉立创在线 DFM PRECHECK_02 与本地检查差异复核

日期：2026-11-05。只读复核冻结 `pcb/release_v03`；没有修改 EDA、冻结源、原制造报告或发布包。本复核使用 PDF 技能，已目视单页图像 PDF 的完整渲染。原本地36 PASS仅代表当时明示的检查范围，不是本次在线DFM结果。

归档说明：本文保留 PRECHECK_02 的问题分析与当时建议。后续 PRECHECK_03 的最终几何检查另见[正式制造检查报告](../../../release_v03_precheck03_fabrication.json)，孔转换证据见[独立转换报告](../precheck03/hole_conversion_probe.md)。在线复测结果须另行记录，本文不替代复测。

## 证据身份与确定性

- 用户提供报告：[PRECHECK_02_report.pdf](PRECHECK_02_report.pdf)，PDF标注报告时间 **2026-11-05 19:40:37**。
- 实际上传候选 `pcb/preflight_v03/Mianguang_V0.3_DFM_PRECHECK_02.zip` 与冻结 `Gerber_Mianguang_V0.3.zip` 的 SHA-256 完全一致：`b245381b710547aec874be0bb3018a74e3dfb0aaf2f7b20015833cee4b0f3a61`。
- PDF SHA-256：`10b7d5c73c5864da864bad16d8fab4e0bcffe7fb39bebef6e0b320dd8abc3111`。PDF只记文件名，没有服务端输入哈希，因此“PDF确实使用这份字节”的归属仍依据用户提交记录、文件名及精确几何对应，而非PDF内的密码学绑定。
- 详细JSON：[PRECHECK_02_geometry_review.json](PRECHECK_02_geometry_review.json)，保存全部63个焊盘、42个独立钻孔、逐条相关Gerber笔画和最近点。圆弧离散误差0.000125 mm；以下为名义文件几何，不是实物测量。

## 在线报告明确给出的结果

| 项目 | 报告最小值 | 危险 | 警告 | 良好 |
|---|---:|---:|---:|---:|
| 焊盘孔环 | 0 mm | 8 | 0 | 16 |
| 丝印距焊盘 | 0.1 mm | 50 | 0 | 0 |
| 丝印距孔 | 0 mm | 16 | 4 | 2 |
| 丝印线条宽度 | 0.15 mm | 0 | 49 | 1 |
| 插件焊盘距贴片焊盘 | 2.32 mm | 0 | 8 | 28 |

报告勾选 **PCB DFM**，**没有勾选 SMT DFM**。报告工艺栏为 **有铅喷锡、绿色、白色**，与项目原先拟定的**无铅喷锡**不一致。下次检测/下单应将表面工艺选项校正；这不是可忽略的文件字样差异，也不是证明板厂已经生产。

## 1. 丝印距离口径：50个开窗不足0.25 mm，逐一可复现

本地旧门槛检查的是“丝印到铜焊盘 ≥0.15 mm”，并检查不直接压阻焊窗；最小丝印到开窗0.09985 mm被记录但没有作为失败门槛。因此本地通过和在线危险可以同时出现。不能据旧PASS覆盖在线结果。

本次改按实际阻焊开窗测距，**恰有50个物理焊盘小于0.25 mm**，最小 **0.09985 mm**，与在线“0.1 mm、危险50”的汇总高度一致。在线截图也显示绿窗口边界。由此推断服务端所称“焊盘”使用了开窗/露铜边界；尚未获取服务端逐条规则定义，故该口径归因标为推断。无论服务端内部如何命名，50处近窗丝印均为真实导出几何，建议全部修到至少0.25 mm，并留额外余量。

下表列出全部违规物理焊盘。最近点是丝印侧位置，坐标单位mm、原点为板框左下角。每个焊盘的另一侧最近点、相关Gerber对象和边界都在JSON。

| 器件 | 引脚 | 丝印到开窗最小–最大/mm | 该器件最邻近丝印点/mm |
|---|---|---:|---|
| C1 | 2, 1 | 0.102230–0.102230 | (32.70561, 14.82740) |
| C2 | 2, 1 | 0.128745–0.128841 | (35.83031, 13.38452) |
| C3 | 2, 1 | 0.128745–0.128841 | (17.61548, 32.83031) |
| C4 | 2, 1 | 0.102230–0.102230 | (55.70561, 28.82740) |
| C5 | 2, 1 | 0.128754–0.128829 | (52.83031, 30.38452) |
| D1 | 2, 1 | 0.150631–0.150631 | (39.10218, 9.04143) |
| D2 | 1, 2 | 0.129631–0.154760 | (23.33957, 15.37840) |
| F1 | 1, 2 | 0.101620–0.101620 | (22.95994, 6.98359) |
| J1 | 2, 1 | 0.192200–0.192200 | (15.85700, 9.27000) |
| J2 | 1, 2, 3, 4 | 0.218680–0.242200 | (53.61052, 35.00000) |
| J3 | 2, 1 | 0.192200–0.192200 | (56.90000, 14.58700) |
| J4 | 2, 1 | 0.192200–0.192200 | (8.58700, 28.10000) |
| J5 | 1, 2, 3, 4 | 0.218680–0.242200 | (14.00000, 41.61052) |
| JP1 | 2, 1 | 0.192200–0.192200 | (48.14300, 9.27000) |
| JP2 | 2, 1 | 0.192200–0.192200 | (50.41300, 36.00000) |
| JP3 | 2, 1 | 0.192200–0.192200 | (50.41300, 41.00000) |
| Q1 | 1, 2, 3 | 0.124240–0.157621 | (49.50000, 15.54999) |
| R1 | 2, 1 | 0.099850–0.099850 | (46.30889, 24.43180) |
| R2 | 2, 1 | 0.099850–0.099850 | (48.56820, 23.30889) |
| R3 | 2, 1 | 0.099850–0.099850 | (15.69111, 28.56820) |
| R4 | 2, 1 | 0.099850–0.099850 | (50.30889, 27.43180) |
| R5 | 2, 1 | 0.099850–0.099850 | (50.30889, 31.43180) |
| U1 | 1 | 0.218549–0.218549 | (24.36395, 38.28040) |

构成：29个SMT焊盘全部涉及；20个排针焊盘和U1.1涉及；其余13个U1通孔焊盘不低于0.25 mm。

## 2. 丝印压孔：两处独立过孔，报告数量可由重复钻孔与笔画计数解释

实测只有以下两处独立孔的丝印距离小于0.25 mm；均为约0.29998 mm的镀铜via，四个安装NPTH没有此问题。

| 孔中心/mm | 源孔ID | 实际问题 | 最少改法 |
|---|---|---|---|
| (47.51363, 30.72071) | `07a52d824079dc75` | R5左侧外框覆盖孔；Gerber对象1716直接重叠，1715距孔0.168423 mm | 删除/简化R5紧贴焊盘的外框；保留R5位号 |
| (15.00019, 32.85405) | `72f521cd780d23ba` | C3位号多个字形笔画覆盖孔；最近为0 mm | C3位号改为水平，建议放(15.5,36.2) mm；8 mil笔画后重新确认 |

另外两处via：(46.18674,25.37276) 的丝印净距约0.485975 mm；(14.50666,27.75044) 约0.689675 mm，当前满足0.25 mm目标。

**数量解释证据：** 原生上传包同时有完整 `Drill_PTH_Through.DRL` 和其4孔精确子集 `Drill_PTH_Through_Via.DRL`。对上述两处唯一孔逐Gerber笔画测量，有8条距孔<0.1 mm、2条位于0.1–0.2 mm、1条位于0.2–0.25 mm；若via被两个文件重复计入，恰为 **16 / 4 / 2**，与在线危险/警告/良好全数吻合。此结果有力支持“重复Via文件＋按笔画统计”的解释，但不是已读取服务端算法。不能因此忽略两处真实压孔。

最少交付修正是：保留原生EDA完整导出作追溯，另生成明确命名的生产/检测Gerber包，仅保留主PTH和主NPTH两个钻孔文件。必须先验证Via附表确为精确子集，并把此转换写入清单；不能无记录删除原生包内容。

## 3. 零孔环的8处：4个NPTH双面同径铜flash，尚不能直接称误报

在四个坐标 (5,5)、(61,5)、(5,51)、(61,51) mm，上下铜层各存在一个直径2.7 mm的孤立圆形铜flash；与NPTH钻孔圆的对称差面积在几何精度内为0，名义环宽确实为0。**4孔×2层=8**与报告8危险相符。源文件也明确为 `plated=false`，钻孔文件为 `Drill_NPTH_Through.DRL`，这些证据支持报警关联NPTH同径铜图形的推断。

然而在线报告没有逐条坐标或镀铜识别结果，不能直接断言8项全部误报；同径铜flash本身也给CAM造成不必要歧义。推荐在EDA用明确的机械圆孔/圆形挖槽表达孔位，保留4孔中心与直径2.7 mm，去掉无意的同径铜flash，再核对新NPTH文件和剩余实铜。这比手工忽略警告更清楚。根代理已提出采用官方圆形挖槽方式；本复核尚未检查后续新候选，不能提前称已消项。

## 4. 线宽与最少丝印修改

当前实际GTO描线只有0.1524 mm（6 mil）和0.254 mm（10 mil）；PDF显示0.15 mm警告49。公开制造能力页的最低线宽0.15 mm与这个线上告警分级可能不同；0.20 mm是本轮主动提高的设计目标，不假称已读取服务器阈值。

推荐顺序如下，尽量不动电气铜：

1. 所有可见文字、保留的细线改为8 mil（0.2032 mm），原10 mil轮廓可保留；字号保持至少40 mil（1.016 mm）。加粗会使边缘向外增加约0.0254 mm，应在加粗后重新测距。
2. R1–R5、C1–C5、F1的紧贴焊盘外框可删除或简化，仅留清楚位号；F1中央熔断符号如保留也使用8 mil。一次处理22个SMT开窗邻近问题，并解除R5外框压via。
3. 2P排针外框每边外扩约0.13 mm：原局部±100 mil / ±50 mil可变为约±105.12 mil / ±55.12 mil，10 mil线宽保留。4P排针外框同样适度外扩。
4. J2/J5的内部pin1分隔线原位于-99.074 mil，10 mil线宽使最近窗距0.21868 mm。可删除分隔线（铜pad1方形与针序说明仍可辨识），或将分隔线精确居中于-100 mil并改8 mil，名义净距约0.2676 mm。
5. U1仅左上角e23弧的末段靠近pin1；可截短/去掉这一小段装饰轮廓。保留U1位号、铜pad1方形标记，其余几何不要改。
6. D1实际冲突是封装4个外框竖短段（`8858…`封装e12/e13/e15/e16）。删除这4段，保留上下横线及中央二极管/阴极符号；横线8 mil后距窗仍约0.308 mm。D1位号已在空白区，应保留。
7. D2建议删除贴窗外框和两小块，仅留阴极横杠，放全局y=13.40 mm、x约23.2–24.8 mm，8 mil线宽时距D2.1开窗上边12.93084 mm约0.3676 mm；D2位号保留。阴极方向仍指向D2.1，不能只删标记不补回。
8. Q1紧凑外框多段近窗，建议移除外框并在pin1侧增加直径0.4 mm圆点，中心(51.2,16.05) mm；到pin1窗口右边50.5508 mm净距约0.4492 mm。保留Q1位号，并在装配图明确圆点对应pin1。
9. C3位号按上节移至孔外空白区。所有文字在最终Gerber中再目视检查彼此碰撞；线宽/字高合格不能代替可读性。

## 5. 8条插件到SMT间距是真实几何，不是铜短路

按物理pad铜边界测量，恰有以下8对小于3 mm，最小2.321767 mm；与在线2.32 mm/警告8一致。这支持报告按约3 mm装配间距筛选的推断，但不代表厂家已判定哪种焊接工艺不可用。

| 插件pad | SMT pad | 铜pad边界间距/mm |
|---|---|---:|
| U1.9 | R1.1 | 2.321767 |
| J4.2 | R3.1 | 2.671760 |
| J2.1 | C5.1 | 2.700005 |
| J2.2 | C5.2 | 2.700005 |
| U1.8 | R1.1 | 2.729323 |
| J2.2 | C5.1 | 2.846462 |
| J2.1 | R5.2 | 2.963982 |
| J2.1 | C5.2 | 2.979546 |

这些距离远大于现有裸板铜间距门槛，因此不能说它们是短路或必然不可制造；也不能为取得“全通过”而当作不存在。若选择保留，需在装配方案中明确SMT回流后手焊通孔、禁止未经评估直接波峰焊，并将该提示列为有依据的装配评审例外，不能宣称在线全部零告警。

若目标是几何上也超过3 mm，可研究小幅移动：R1 x+0.85 mm、R3 x+0.55 mm、C5 y-0.50 mm、R5 y-0.30至-0.40 mm。它们会改变铜连接和相邻器件/过孔关系，必须重走线、重跑EDA与Gerber检查，再复查CPL和机械占位；尤其R5与现有MCU_RX via关系需重新核对。本复核未实施这些移动，也未将估算位置标为已验证。

## 后续验证边界

下一候选应新增“丝印到阻焊开窗≥0.25 mm”“丝印到全部独立钻孔≥0.25 mm”“实际丝印笔画≥0.20 mm”的明示门槛，保留原孔位/板框/网表/实铜一致性检查。机械NPTH源表达变化要有单独解析与回归支持，不沿用旧解析后直接PASS。

旧36项报告的检查器哈希和输入仍是历史事实，不能原地覆盖为新标准结果。新候选用新文件名/检查报告记录，并在新的在线检测结果出来后判断是否消项。

官方制造能力参考：https://jlcpcb.com/capabilities/pcb-capabilities （本会话2026-11-05已读取）。本报告的具体报警与数值以用户提供PDF和上述实际Gerber测量为依据；公开最低能力不替代本次线上告警标准。
