wonderbench/mianguang/pcb/qa/v03/precheck04/PCB_Top_Gerber.png

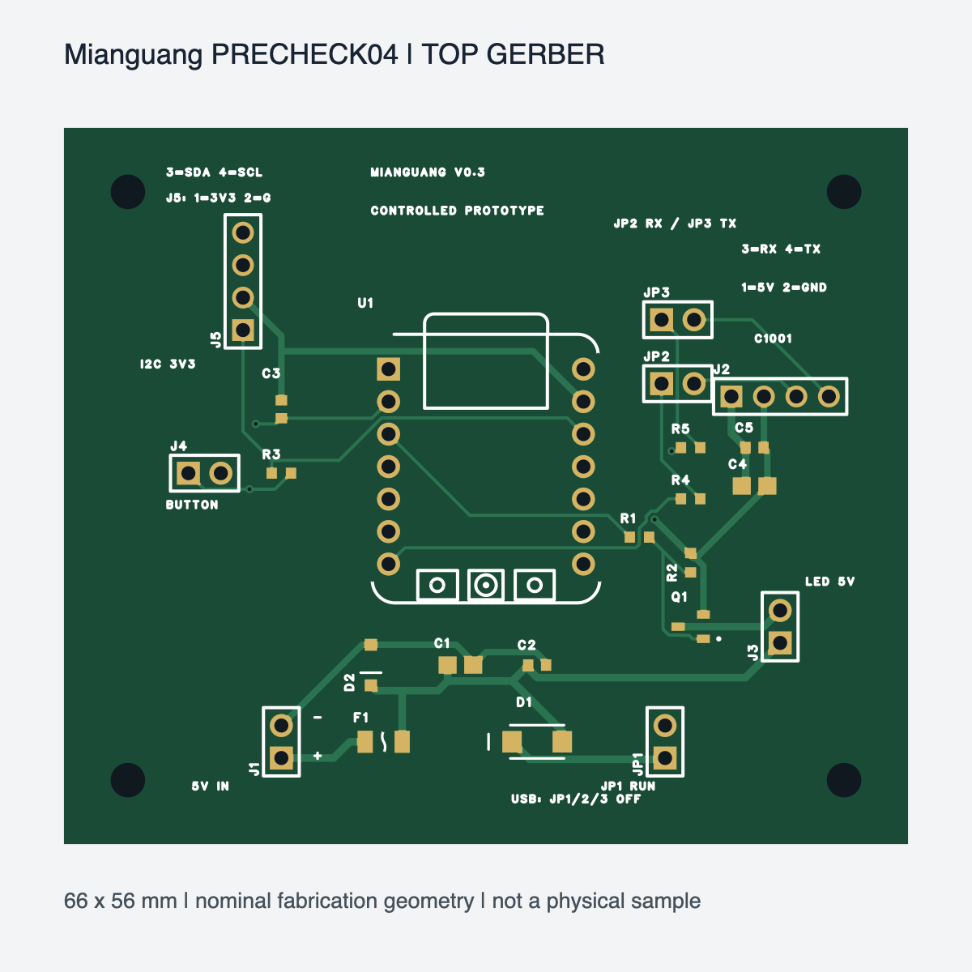
pcb/qa/v03/precheck04/PCB_Top_Gerber.png
