wonderbench/mianguang/pcb/release_v03_precheck04/PCB_Review_V0.3.pdf

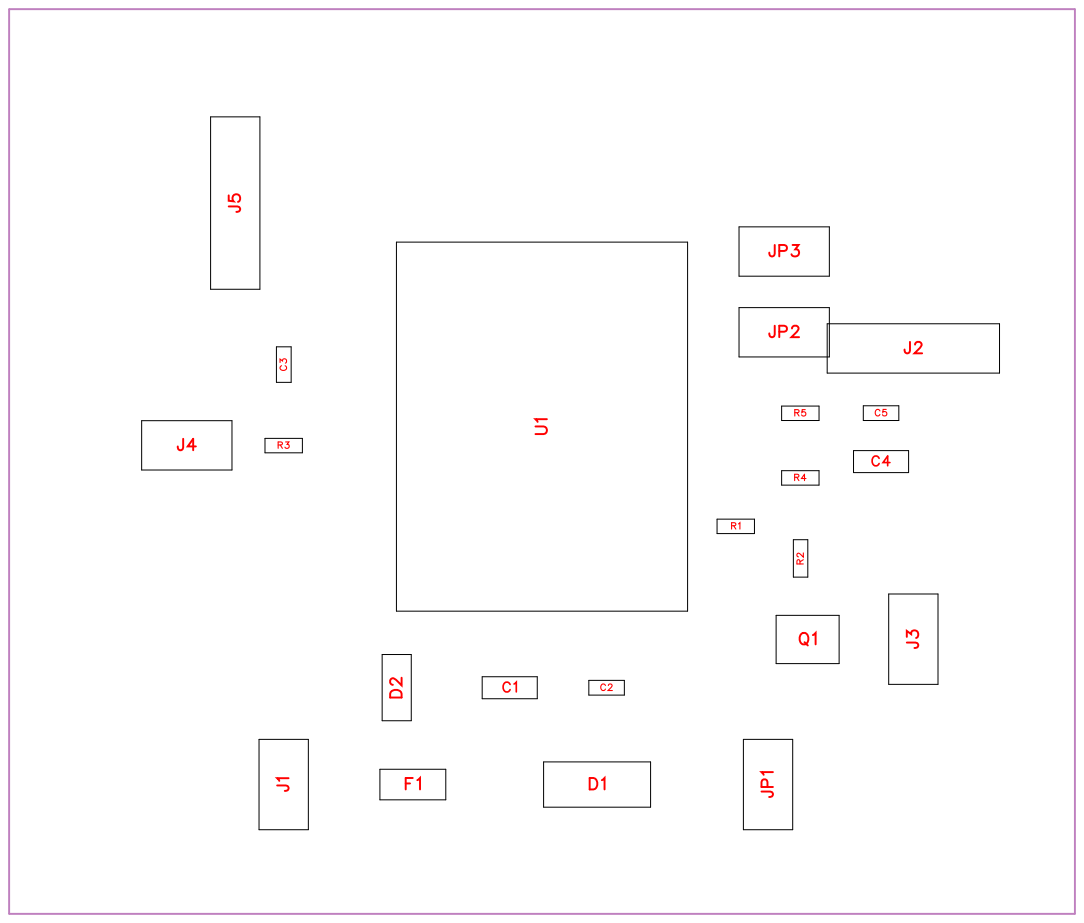
[picture p36: page 1]

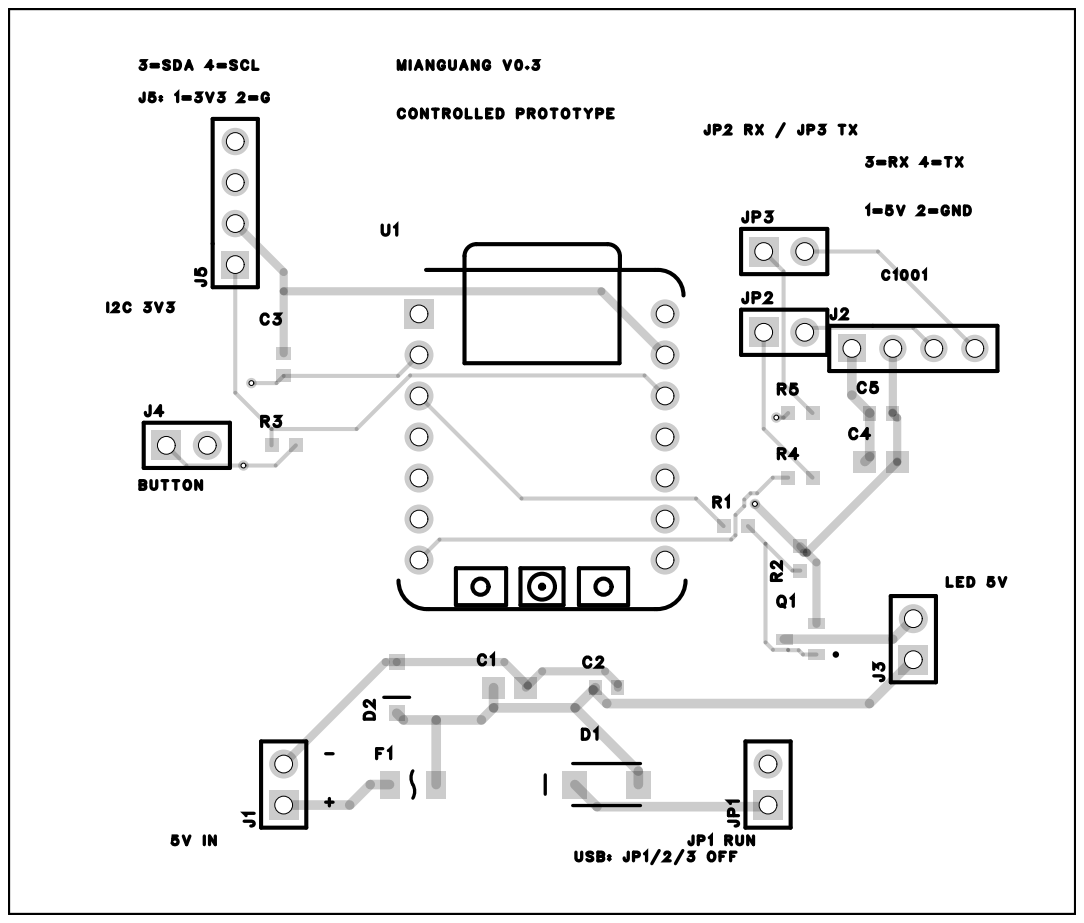
[picture p37: page 2]

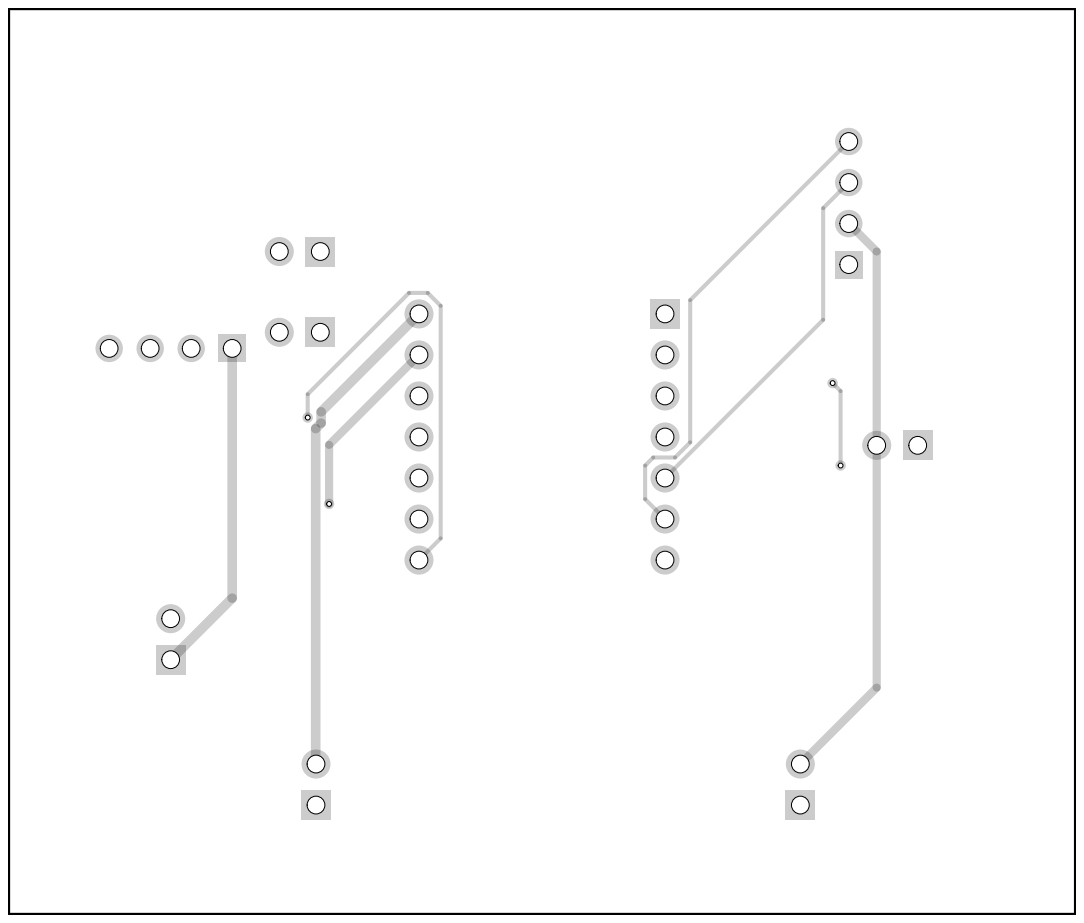
[picture p38: page 3]

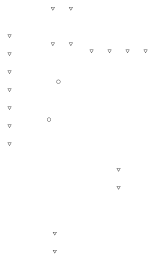
[picture p39: figure]
