wonderbench/mianguang/pcb/release_v03/PCB_Review_V0.3.pdf

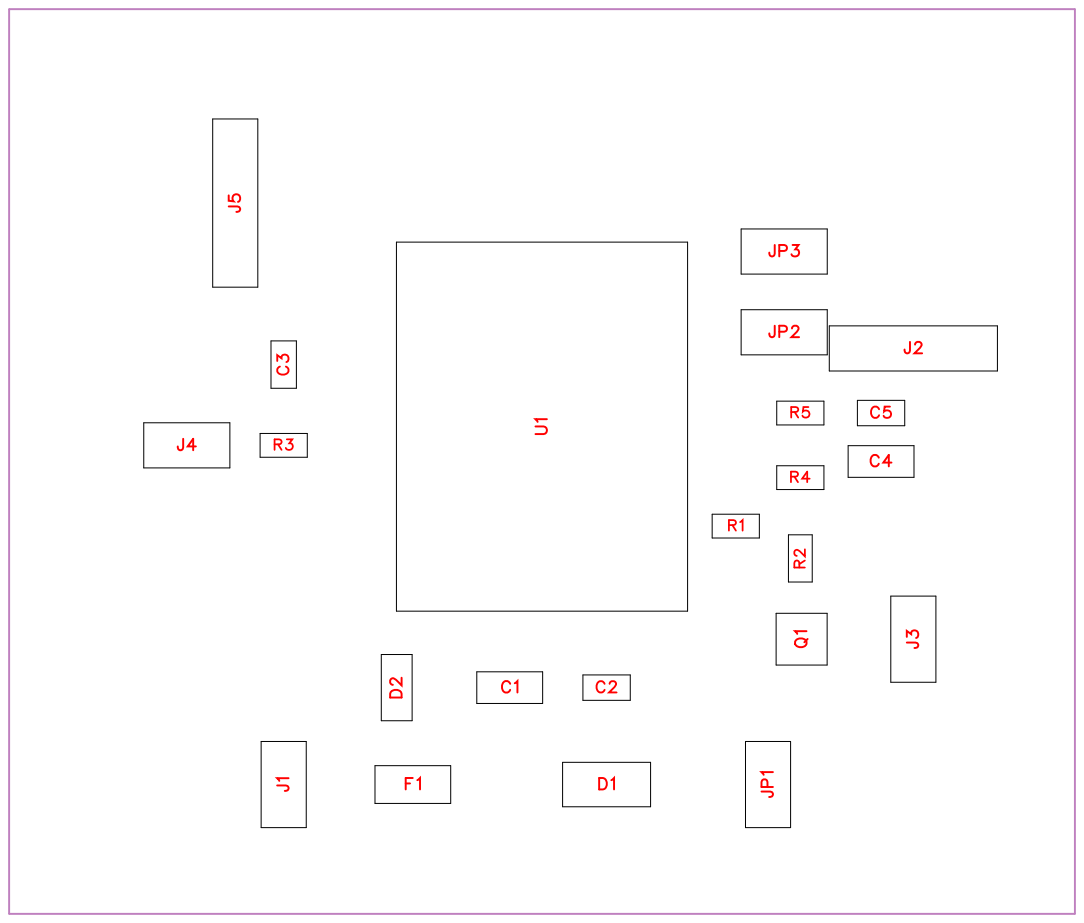
[picture p40: page 1]

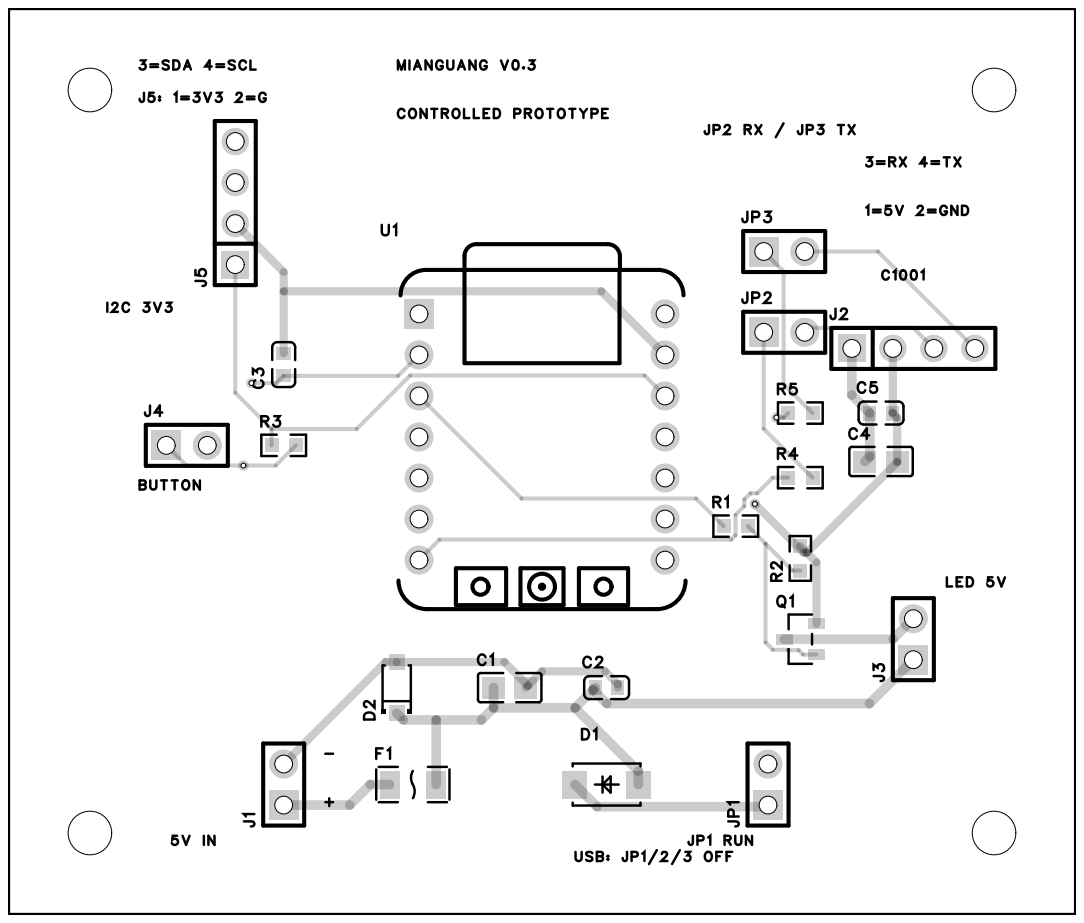
[picture p41: page 2]

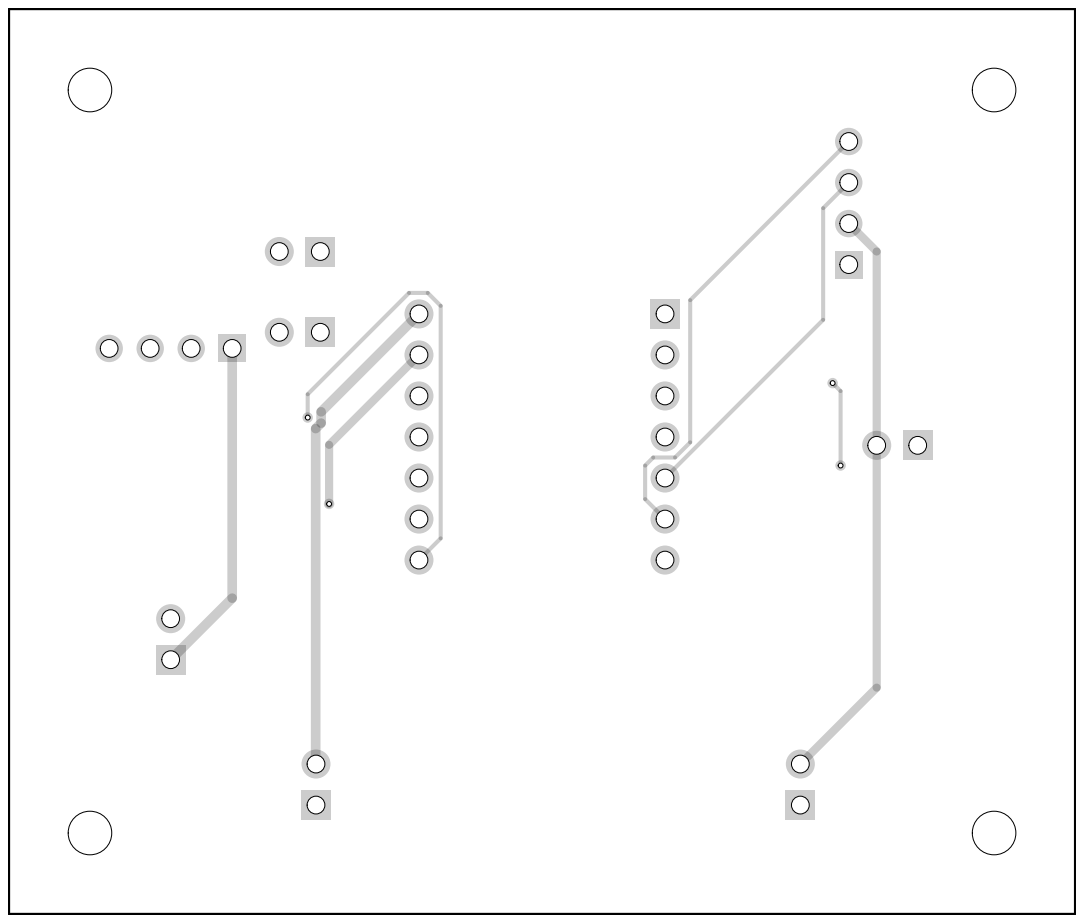
[picture p42: page 3]
