wonderbench/mianguang/pcb/release_v03_precheck03/PCB_Review_V0.3.pdf

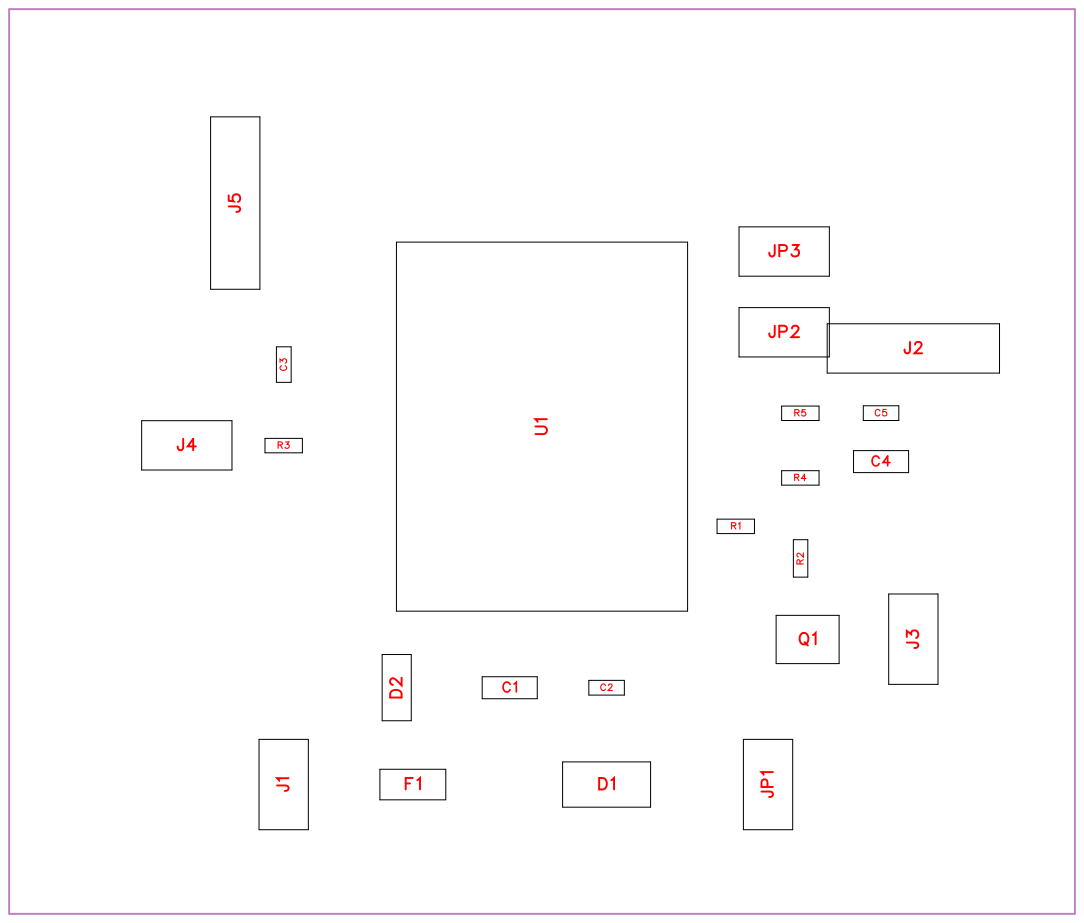
[picture p43: page 1]

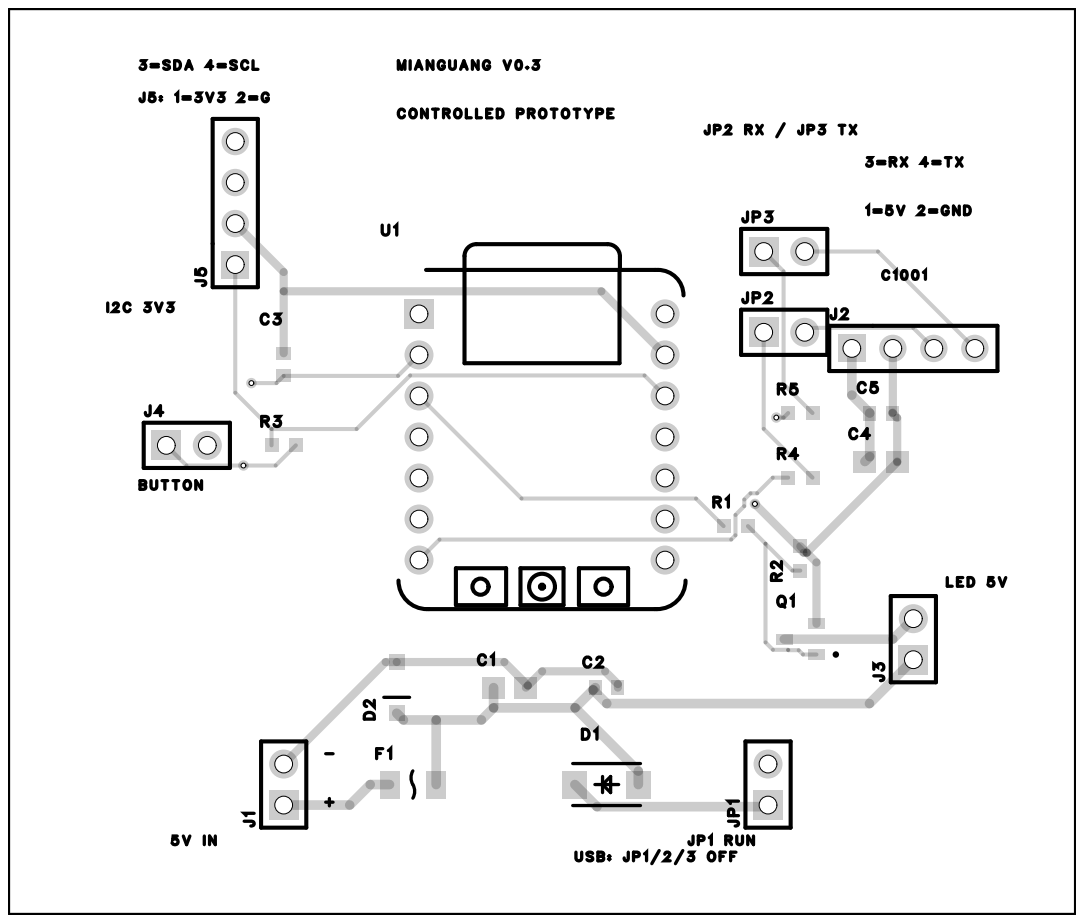
[picture p44: page 2]
