wonderbench/mianguang/pcb/release_v02/PCB_Review_V0.2.pdf

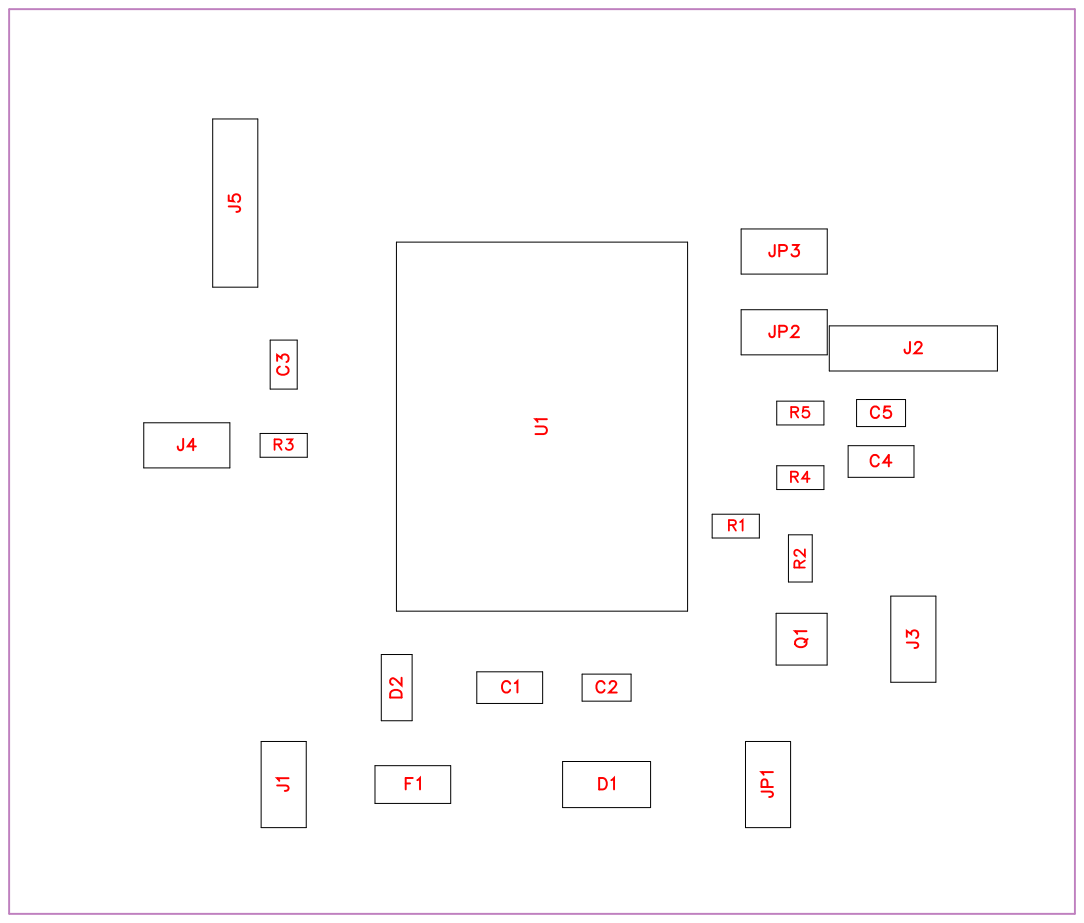
[picture p45: page 1]

U1

JP3

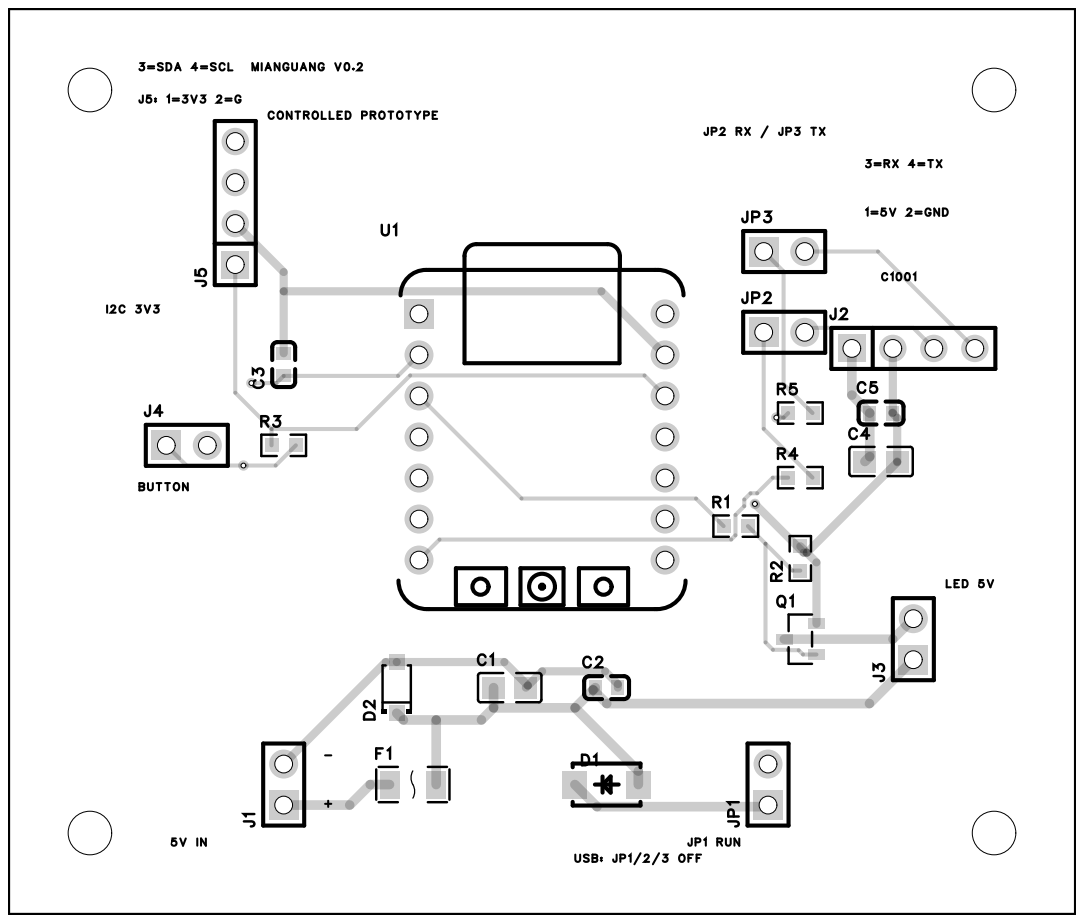
[picture p46: page 2]
