wonderbench/mianguang/(list of files, drawings)

Other design files:
models/mechanical/pcb_v02_reference.json
pcb/release_v02/pcb_netlist.json
pcb/release_v02/schematic_netlist.json
pcb/release_v03_precheck04/pcb_netlist.json
pcb/release_v03_precheck04/schematic_netlist.json
