wonderbench/mianguang/(commit log)

2026-11-04 Organize Mianguang PCB, firmware, models and project documentation
    [BOM_Mianguang_V0.2.csv, BOM_Mianguang_V0.2.xlsx, JQC1001.DWG, JQC1001.step, PickPlace_Mianguang_V0.2.csv, SR01_01_Rear_Tub.stl, SR01_02_Front_Radome_Frame.stl, SR01_03_Light_Diffuser.stl]
2026-11-04 Fit V0.2 enclosure to PCB and verify desktop and wall mounts
    [Mianguang_Enclosure_V0.2.blend, SR02_01_Rear_Tub.stl, SR02_02_Front_Radome.stl, SR02_03_Light_Diffuser.stl, SR02_04_Captive_Top_Key.stl, SR02_05_Radar_Carrier.stl, SR02_06_LED_Baffle.stl, SR02_07_Common_Dock_Yoke.stl]
2026-11-04 Document minimal multi-device management platform architecture and contracts
2026-11-04 feat(platform): 容量与持续运行验收工具 (#4)
    * feat(platform): add measured capacity and endurance acceptance tooling
    * test(platform): measure queries with 6048000 historical rows
    * docs(platform): record measured 6048000-row acceptance and keep routine CI small
2026-11-04 feat(platform): add isolated ESP32 network firmware and controlled USB provisioning (#5)
2026-11-05 feat(platform): 按 unslop 优化观测界面与手机趋势图 (#7)
    Improve dashboard hierarchy, readable snapshot metadata and responsive SVG charts. Preserve freshness, permissions and missing-data semantics.
    Verified by independent code review, 23 browser checks with 14 before/after screenshots, and the complete Platform CI. No production dependencies or permanent test framework added.
2026-11-05 Fix PCB V0.3 DFM findings and package PRECHECK03 review files
    [BOM_Mianguang_V0.3.csv, BOM_Mianguang_V0.3.xlsx, BOM_SMT_Mianguang_V0.3.csv, PickPlace_Mianguang_V0.3.csv, manual_assembly.csv, pcb_netlist.json, schematic_netlist.json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]
2026-11-05 Review PCB and SMT reports and move D1 polarity mark outside body
    [BOM_Mianguang_V0.3.csv, BOM_Mianguang_V0.3.xlsx, BOM_SMT_Mianguang_V0.3.csv, PickPlace_Mianguang_V0.3.csv, manual_assembly.csv, pcb_netlist.json, schematic_netlist.json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]
2026-11-05 Archive PRECHECK04 DFM report and close D1 silkscreen finding
2026-11-05 docs(pcb): add mounting hole and assembly clearance review
2026-11-05 docs: link mounting and clearance review from README
2026-11-05 docs(pcb): link mounting and clearance review from PCB index
2026-11-05 docs(pcb): correct hole clearance verification note
